SunBinyuan666/Standard_NUEDC_DevBoard/AI_Development/所有元器件的连接方式.md

# Standard NUEDC DevBoard — 所有元器件的连接方式

## 1. 文档范围与证据来源

- 识别对象：`D:\stm32IDEprojects\Standard_NUEDC_DevBoard\原理图\SCH_Standard NUEDC DevBoard.pdf`。
- 精确引脚网络对照：`D:\stm32IDEprojects\Standard_NUEDC_DevBoard\PCB工程文件\Netlist_Standard NUEDC DevBoard.tel`。
- 原理图共 3 页：第 1 页“主控”，第 2 页“电源”，第 3 页“接口”；标题为 STM32F103VET6，版本 V1.0。创建日期 2026-10-05，第 1/3 页更新于 2026-10-09，第 2 页更新于 2026-10-08。
- 生成日期：2026-10-16。语言沿用原任务，使用中文。
- 方法：先读取 PDF 文字并查看三页电路和关键放大区域，再以 TEL 交叉核对物理引脚号和全部同网端点。型号与符号功能以 PDF 为证据；精确引脚编号以 TEL 为证据，PDF 已显示的未连接脚另外列出。
- **U5 是位号，完整芯片型号已由 PDF 确认为 STM32F103VET6，属于 STM32F1。** U 开头并不一定都是 IC：U2 是开关、U3 是保险丝、U7–U12 多数是连接器、U14 是二极管。
- 文档记录“实际图中连接”，不是修订设计；不静默修改阻值、接线或封装。不替代 ERC/DRC、器件规格核对、PCB 检查和实测。

### 1.1 阅读约定

1. `U5.23` 表示 U5 的物理引脚 23；`USB1.A6` 表示 Type-C A 面的 A6 焊脚。
2. 同一网络内的端点是直接电气相连；跨电阻、电容、二极管、晶体管、开关或电感的两端不是同一网络。
3. `$1N.../$2N.../$3N...` 是 TEL 自动生成的匿名网络名，本文保留原名并添加语义解释，方便回查。
4. `NC` 表示 PDF 中标 × 或明确不连接，不代表逻辑低或电源地。开关未使用触点保留符号标签，不猜测 PDF 没显示的物理脚号。
5. 每个元器件都有引脚表；普通小网络直接列出其他端点，大型公用网络通过附录列出全部端点。表中“同网其他端点”不包括该行自身。
6. 接口的 PCB 针号不等同于图片左右方向、软件端口编号或开关机械档位。

## 2. 板级连接总览

### 2.1 电源结构

```text
CN1.1 / DC1.4
  → D1（SS54）
  → U1 VIN + C1/C2/C3 输入滤波
  → U1 PH + D2 续流 + L1（15µH）
  → 公共前级5V（PDF DC+5V 与 USB+5V 同网；TEL 统一为 USB+5V）
      ├─ USB1/USB2 的全部 VBUS
      ├─ C5/C6/C7 与 LED2/R6
      └─ U2 开关 → U3 保险丝 → VCC+5V
          ├─ 外设接口 P1/P2/P3/U11/U12、H2 的5V针
          └─ U4 AMS1117-3.3 → VCC+3.3V
              ├─ MCU 数字电源、CH340C、LED与上拉
              ├─ R7（0Ω）→ VCCA+3.3V → MCU VDDA
              │    └─ R9（1kΩ）→ U6 TL431 + C19 → MCU VREF+
              └─ D3一路阳极 → 共阴极VBAT
BT1正极 → D3另一路阳极 → 共阴极VBAT → U5.6
GND ← R8（0Ω）→ AGND
```

这里的“5V/3.3V”是网络名和设计意图，不是已测电压。特别是 USB 两口与 DC/DC 输出在开关之前已共网，U2/U3 不提供三路输入相互隔离。

### 2.2 主控最小系统

- 数字 VDD：U5.11/28/50/75/100 接 3.3V；VSS：U5.10/27/49/74/99 接 GND；C13–C17 去耦。
- VDDA=U5.22 接模拟 3.3V；VSSA=U5.19 与 VREF−=U5.20 接 AGND；VREF+=U5.21 接 TL431 参考节点。
- VBAT=U5.6 由 D3 合并数字 3.3V/电池，C18 到地。
- 高速晶体 X1：8MHz，连接 U5.12/13，C20/C21 各 20pF 到地；低速晶体 X2：32.768kHz，连接 U5.8/9，C22/C23 各 10pF 到地。
- RST=U5.14：R10 10kΩ 上拉、C24 100nF 到地、SW1 按下接地，并与 U14 相连。
- H1 通过 R11/R12 选择 BOOT1/BOOT0；PB2 就是 U5.37 的 BOOT1 同节点，未另外单独引出 PB2 网络。

### 2.3 接口及 GPIO 分配

| 模块 | 元器件 | MCU 信号 | 硬件连接要点 |
|---|---|---|---|
| USB 转 UART | USB1、U13 | PA9=MCU TX、PA10=MCU RX | CH340C RXD 接 PA9，TXD 接 PA10；默认 USART1 布局 |
| 原生 USB | USB2、R15 | PA11=D−、PA12=D+ | D+ 外部上拉实为 10kΩ |
| 自动下载 | Q1/Q2/U14/R27–R30 | RST、BOOT0 | 控制来自 CH340C DTR#/RTS# |
| SWD | H4 | PA13、PA14 | 1=3.3V，4=GND，无 NRST 针 |
| 模拟输入 | U7/U8 | PA0、PA1 | 中心端直连，外壳接 AGND |
| 模拟输出 | U9/U10 | PA4、PA5 | 图中 DAC 接口，中心端直连 |
| UART3/可选上拉 | P1/SW5/R21/R22 | PB10、PB11 | USART3 默认布局，也可按功能作 I²C2 |
| UART2/可选上拉 | P2/SW6/R25/R26 | PA2、PA3 | USART2 默认布局；若作 I²C 要另核功能/软件实现 |
| UART4/可选上拉 | P3/SW7/R23/R24 | PC10、PC11 | UART4 布局；与其他可复用外设共用引脚 |
| SPI | U11 | PA15/PB3/PB4/PB5 | 图中分别 CS/CLK/MISO/MOSI，SPI1 重映射与 JTAG 复用需配置 |
| “6路IIC”接口 | U12/R19/R20 | PB15/PB14/PB13/PB12 | 6针不是6路独立 I²C，PB15/PB14 有固定上拉 |
| 用户按键 | SW2/SW3/SW4 | PE13/PE14/PE15 | 按下到地，分别 C25/C26/C27 到地，未见外部上拉 |
| 用户 LED | LED3/LED4/LED5 | PB6/PB7/PD8 | 2kΩ 从3.3V供电，GPIO低电平点亮 |
| GPIO 扩展 | H2/H3 | 见逐针表 | 与板载接口共网，不是另一个独立GPIO副本 |

### 2.4 网络别名对照

| PDF 标注 | TEL 中保留的网络名 | 说明 |
|---|---|---|
| DC+5V、USB+5V | USB+5V | 电源合路图中同一根线上出现两个名称，TEL 合并为一个网络 |
| USBN | PA11 | USB2 D− 与 MCU PA11 同网 |
| USBP | PA12 | USB2 D+ 与 MCU PA12 同网 |
| PB2、BOOT1 | BOOT1 | U5.37 的启动复用引脚 |
| TXD2 / RXD2 | PA2 / PA3 | P2 串口方向标签，以 MCU 视角 |
| TXD3 / RXD3 | PB10 / PB11 | P1 串口方向标签，以 MCU 视角 |
| TXD4 / RXD4 | PC10 / PC11 | P3 串口方向标签，以 MCU 视角 |
| SPI_CS/CLK/MISO/MOSI | PA15/PB3/PB4/PB5 | U11 的功能标签 |
| SWDIO / SWCLK | PA13 / PA14 | H4 的功能标签 |
| SCL / SDA（U12） | PB15 / PB14 | 图中标签不等于 MCU 硬件外设已配置 |

## 3. 完整元器件索引

已交叉匹配 PDF 与 TEL 的 **108 个独立位号、124 个已连接网络、509 个已连接引脚端点**。另补 15 个有编号未连接脚，以及 SW5–SW7 的未使用符号触点。

| 类别 | 数量 | 位号范围 |
|---|---:|---|
| BT | 1 | BT1 |
| C | 28 | C1, C2, C3, C4, C5, C6, C7, C8, C9, C10, C11, C12, C13, C14, C15, C16, C17, C18, C19, C20, C21, C22, C23, C24, C25, C26, C27, C28 |
| CN | 1 | CN1 |
| DC | 1 | DC1 |
| D | 3 | D1, D2, D3 |
| H | 4 | H1, H2, H3, H4 |
| L | 1 | L1 |
| LED | 5 | LED1, LED2, LED3, LED4, LED5 |
| P | 3 | P1, P2, P3 |
| Q | 2 | Q1, Q2 |
| R | 30 | R1, R2, R3, R4, R5, R6, R7, R8, R9, R10, R11, R12, R13, R14, R15, R16, R17, R18, R19, R20, R21, R22, R23, R24, R25, R26, R27, R28, R29, R30 |
| SCREW | 4 | SCREW1, SCREW2, SCREW3, SCREW4 |
| SW | 7 | SW1, SW2, SW3, SW4, SW5, SW6, SW7 |
| U | 14 | U1, U2, U3, U4, U5, U6, U7, U8, U9, U10, U11, U12, U13, U14 |
| USB | 2 | USB1, USB2 |
| X | 2 | X1, X2 |

以下索引的型号/数值优先来自 PDF；TEL 的封装原字符串在每个器件小节保留。

| 位号 | PDF型号/数值 | PDF页 | 分类 |
|---|---|---|---|
| BT1 | CR1220-2ZX 电池座（电池额定电压未在图中标注） | 1 | 离散器件与时钟 |
| C1 | 4.7uF | 2 | 电容 |
| C2 | 4.7uF | 2 | 电容 |
| C3 | 10nF | 2 | 电容 |
| C4 | 10nF | 2 | 电容 |
| C5 | 47uF | 2 | 电容 |
| C6 | 47uF | 2 | 电容 |
| C7 | 10nF | 2 | 电容 |
| C8 | 10uF | 2 | 电容 |
| C9 | 100nF | 2 | 电容 |
| C10 | 10uF | 2 | 电容 |
| C11 | 100nF | 2 | 电容 |
| C12 | 100nF | 2 | 电容 |
| C13 | 100nF | 1 | 电容 |
| C14 | 100nF | 1 | 电容 |
| C15 | 100nF | 1 | 电容 |
| C16 | 100nF | 1 | 电容 |
| C17 | 100nF | 1 | 电容 |
| C18 | 100nF | 1 | 电容 |
| C19 | 10uF | 1 | 电容 |
| C20 | 20pF | 1 | 电容 |
| C21 | 20pF | 1 | 电容 |
| C22 | 10pF | 1 | 电容 |
| C23 | 10pF | 1 | 电容 |
| C24 | 100nF | 1 | 电容 |
| C25 | 100nF | 3 | 电容 |
| C26 | 100nF | 3 | 电容 |
| C27 | 100nF | 3 | 电容 |
| C28 | 100nF | 3 | 电容 |
| CN1 | MX103-5.0-02P-GN01-Cu-Y-A 两针接线端子 | 2 | 连接器 |
| D1 | SS54 肖特基二极管 | 2 | 离散器件与时钟 |
| D2 | SS54 肖特基二极管 | 2 | 离散器件与时钟 |
| D3 | BAT54C 共阴极双肖特基二极管 | 1 | 离散器件与时钟 |
| DC1 | DC005-2.5 DC 插座 | 2 | 离散器件与时钟 |
| H1 | HX PZ2.54-2x3P ZZ，BOOT 选择排针 | 1 | 连接器 |
| H2 | X6521WV-2x23H-C60D30，46Pin 排针 | 1 | 连接器 |
| H3 | X6521WV-2x23H-C60D30，46Pin 排针 | 1 | 连接器 |
| H4 | PZ254V-11-04P，SWD 四针排针 | 3 | 连接器 |
| L1 | 15uH | 2 | 离散器件与时钟 |
| LED1 | GL0603UG01 绿色 LED（PDF 标注；网表封装名含 RD） | 2 | 离散器件与时钟 |
| LED2 | GL0603UG01 绿色 LED（PDF 标注；网表封装名含 RD） | 2 | 离散器件与时钟 |
| LED3 | GL0603UB01 蓝色 LED | 3 | 离散器件与时钟 |
| LED4 | GL0603UB01 蓝色 LED | 3 | 离散器件与时钟 |
| LED5 | GL0603UB01 蓝色 LED | 3 | 离散器件与时钟 |
| P1 | ZX-XH2.54-4PLT，四个功能端子及两个辅助焊盘 | 3 | 连接器 |
| P2 | ZX-XH2.54-4PLT，四个功能端子及两个辅助焊盘 | 3 | 连接器 |
| P3 | ZX-XH2.54-4PLT，四个功能端子及两个辅助焊盘 | 3 | 连接器 |
| Q1 | S8050 J3Y，图示增益范围 200–350，NPN 三极管 | 3 | 离散器件与时钟 |
| Q2 | S8550，图示增益范围 120–200，PNP 三极管 | 3 | 离散器件与时钟 |
| R1 | 5.1kΩ | 2 | 电阻 |
| R2 | 5.1kΩ | 2 | 电阻 |
| R3 | 10kΩ | 2 | 电阻 |
| R4 | 3.16kΩ | 2 | 电阻 |
| R5 | 2kΩ | 2 | 电阻 |
| R6 | 5kΩ | 2 | 电阻 |
| R7 | 0Ω | 2 | 电阻 |
| R8 | 0Ω | 2 | 电阻 |
| R9 | 1kΩ | 1 | 电阻 |
| R10 | 10kΩ | 1 | 电阻 |
| R11 | 10kΩ | 1 | 电阻 |
| R12 | 10kΩ | 1 | 电阻 |
| R13 | 5.1kΩ | 3 | 电阻 |
| R14 | 5.1kΩ | 3 | 电阻 |
| R15 | 10kΩ | 3 | 电阻 |
| R16 | 2kΩ | 3 | 电阻 |
| R17 | 2kΩ | 3 | 电阻 |
| R18 | 2kΩ | 3 | 电阻 |
| R19 | 4.7kΩ | 3 | 电阻 |
| R20 | 4.7kΩ | 3 | 电阻 |
| R21 | 4.7kΩ | 3 | 电阻 |
| R22 | 4.7kΩ | 3 | 电阻 |
| R23 | 4.7kΩ | 3 | 电阻 |
| R24 | 4.7kΩ | 3 | 电阻 |
| R25 | 4.7kΩ | 3 | 电阻 |
| R26 | 4.7kΩ | 3 | 电阻 |
| R27 | 10kΩ | 3 | 电阻 |
| R28 | 1kΩ | 3 | 电阻 |
| R29 | 1kΩ | 3 | 电阻 |
| R30 | 1kΩ | 3 | 电阻 |
| SCREW1 | M3 安装孔/螺丝接地焊盘 | 3 | 按键、开关、LED与安装孔 |
| SCREW2 | M3 安装孔/螺丝接地焊盘 | 3 | 按键、开关、LED与安装孔 |
| SCREW3 | M3 安装孔/螺丝接地焊盘 | 3 | 按键、开关、LED与安装孔 |
| SCREW4 | M3 安装孔/螺丝接地焊盘 | 3 | 按键、开关、LED与安装孔 |
| SW1 | KH-6X6X5H-STM 轻触按键 | 1 | 按键、开关、LED与安装孔 |
| SW2 | KH-6X6X5H-STM 轻触按键 | 3 | 按键、开关、LED与安装孔 |
| SW3 | KH-6X6X5H-STM 轻触按键 | 3 | 按键、开关、LED与安装孔 |
| SW4 | KH-6X6X5H-STM 轻触按键 | 3 | 按键、开关、LED与安装孔 |
| SW5 | MST23D18G2 125，双刀三掷滑动开关 | 3 | 按键、开关、LED与安装孔 |
| SW6 | MST23D18G2 125，双刀三掷滑动开关 | 3 | 按键、开关、LED与安装孔 |
| SW7 | MST23D18G2 125，双刀三掷滑动开关 | 3 | 按键、开关、LED与安装孔 |
| U1 | TPS5450QDDARQ1 降压稳压器 | 2 | 电源与基准 |
| U2 | YSSP2AG00 电源开关 | 2 | 电源与基准 |
| U3 | JK-nSMD005/60V 自恢复保险丝 | 2 | 电源与基准 |
| U4 | AMS1117-3.3 线性稳压器 | 2 | 电源与基准 |
| U5 | STM32F103VET6（STM32F1 系列，LQFP-100） | 1 | 主控 |
| U6 | TL431QDBZR 可调分流基准 | 1 | 电源与基准 |
| U7 | SMA 同轴插座，图中标称 6GHz（不是板级模拟带宽） | 3 | 连接器 |
| U8 | SMA 同轴插座，图中标称 6GHz（不是板级模拟带宽） | 3 | 连接器 |
| U9 | SMA 同轴插座，图中标称 6GHz（不是板级模拟带宽） | 3 | 连接器 |
| U10 | SMA 同轴插座，图中标称 6GHz（不是板级模拟带宽） | 3 | 连接器 |
| U11 | HX 2.54-6P WT，六个功能端子及两个辅助焊盘 | 3 | 连接器 |
| U12 | HX 2.54-6P WT，六个功能端子及两个辅助焊盘 | 3 | 连接器 |
| U13 | CH340C USB 转 UART | 3 | USB桥接与下载 |
| U14 | 1N4007W 整流二极管 | 3 | USB桥接与下载 |
| USB1 | HC-TYPE-C-16P-01B，USB Type-C 插座 | 2 | 连接器 |
| USB2 | HC-TYPE-C-16P-01B，USB Type-C 插座 | 3 | 连接器 |
| X1 | 8MHz 四焊盘无源晶体（实际物料料号未标注） | 1 | 离散器件与时钟 |
| X2 | 32.768kHz 两端无源晶体（实际物料料号未标注） | 1 | 离散器件与时钟 |

## 4. 逐元器件、逐引脚连接

### 4.1 主控

#### U5 — STM32F103VET6（STM32F1 系列，LQFP-100）

- 来源：PDF 第 1 页。
- TEL 封装：`LQFP-100_L14.0-W14.0-P0.50-LS16.0-BL`。
- 作用与连接解释：主控明确为 STM32F103VET6，不再只是根据网表猜测。下表按物理引脚 1–100 列出；73 脚为 PDF 标明的 NC。大部分 GPIO 同时连扩展排针与板载外设，不能视为互相独立的端口。

| 引脚/焊盘 | 图中功能/端子含义 | 网络 | 同网其他端点或查阅方式 |
|---|---|---|---|
| 1 | PE2 | `PE2` | `H2.14` |
| 2 | PE3 | `PE3` | `H2.13` |
| 3 | PE4 | `PE4` | `H2.16` |
| 4 | PE5 | `PE5` | `H2.15` |
| 5 | PE6 | `PE6` | `H2.18` |
| 6 | VBAT | `$1N89` | `C18.1`、`D3.3` |
| 7 | PC13/TAMPER/RTC | `PC13` | `H2.17` |
| 8 | PC14/OSC32K_IN | `OSCL1` | `C22.2`、`X2.1` |
| 9 | PC15/OSC32K_OUT | `OSCL2` | `C23.2`、`X2.2` |
| 10 | VSS | `GND` | 公用网络，共 104 个端点；全部端点见 §6 `GND` |
| 11 | VDD | `VCC+3.3V` | 公用网络，共 42 个端点；全部端点见 §6 `VCC+3.3V` |
| 12 | OSC_IN | `OSCH1` | `C20.2`、`X1.3` |
| 13 | OSC_OUT | `OSCH2` | `C21.1`、`X1.1` |
| 14 | NRST | `RST` | `C24.2`、`R10.1`、`SW1.1`、`SW1.2`、`U14.2` |
| 15 | PC0 | `PC0` | `H2.20` |
| 16 | PC1 | `PC1` | `H2.19` |
| 17 | PC2 | `PC2` | `H2.22` |
| 18 | PC3 | `PC3` | `H2.21` |
| 19 | VSSA | `AGND` | 公用网络，共 22 个端点；全部端点见 §6 `AGND` |
| 20 | VREF− | `AGND` | 公用网络，共 22 个端点；全部端点见 §6 `AGND` |
| 21 | VREF+ | `$1N96` | `C19.2`、`R9.2`、`U6.1`、`U6.2` |
| 22 | VDDA | `VCCA+3.3V` | `C12.2`、`R7.1`、`R9.1` |
| 23 | PA0/WKUP | `PA0` | `H2.24`、`U7.5` |
| 24 | PA1 | `PA1` | `H2.23`、`U8.5` |
| 25 | PA2 | `PA2` | `H2.26`、`P2.2`、`SW6.3` |
| 26 | PA3 | `PA3` | `H2.25`、`P2.3`、`SW6.4` |
| 27 | VSS | `GND` | 公用网络，共 104 个端点；全部端点见 §6 `GND` |
| 28 | VDD | `VCC+3.3V` | 公用网络，共 42 个端点；全部端点见 §6 `VCC+3.3V` |
| 29 | PA4 | `PA4` | `H2.28`、`U9.5` |
| 30 | PA5 | `PA5` | `H2.27`、`U10.5` |
| 31 | PA6 | `PA6` | `H2.30` |
| 32 | PA7 | `PA7` | `H2.29` |
| 33 | PC4 | `PC4` | `H2.32` |
| 34 | PC5 | `PC5` | `H2.31` |
| 35 | PB0 | `PB0` | `H2.34` |
| 36 | PB1 | `PB1` | `H2.33` |
| 37 | PB2/BOOT1 | `BOOT1` | `H2.36`、`R11.2` |
| 38 | PE7 | `PE7` | `H2.35` |
| 39 | PE8 | `PE8` | `H2.38` |
| 40 | PE9 | `PE9` | `H2.37` |
| 41 | PE10 | `PE10` | `H2.40` |
| 42 | PE11 | `PE11` | `H2.39` |
| 43 | PE12 | `PE12` | `H2.42` |
| 44 | PE13 | `PE13` | `C25.2`、`H2.41`、`SW2.1`、`SW2.2` |
| 45 | PE14 | `PE14` | `C26.2`、`H2.44`、`SW3.1`、`SW3.2` |
| 46 | PE15 | `PE15` | `C27.2`、`H2.43`、`SW4.1`、`SW4.2` |
| 47 | PB10 | `PB10` | `H2.46`、`P1.2`、`SW5.3` |
| 48 | PB11 | `PB11` | `H2.45`、`P1.3`、`SW5.4` |
| 49 | VSS | `GND` | 公用网络，共 104 个端点；全部端点见 §6 `GND` |
| 50 | VDD | `VCC+3.3V` | 公用网络，共 42 个端点；全部端点见 §6 `VCC+3.3V` |
| 51 | PB12 | `PB12` | `H3.46`、`U12.5` |
| 52 | PB13 | `PB13` | `H3.45`、`U12.4` |
| 53 | PB14 | `PB14` | `H3.44`、`R20.1`、`U12.3` |
| 54 | PB15 | `PB15` | `H3.43`、`R19.1`、`U12.2` |
| 55 | PD8 | `PD8` | `H3.42`、`LED5.1` |
| 56 | PD9 | `PD9` | `H3.41` |
| 57 | PD10 | `PD10` | `H3.40` |
| 58 | PD11 | `PD11` | `H3.39` |
| 59 | PD12 | `PD12` | `H3.38` |
| 60 | PD13 | `PD13` | `H3.37` |
| 61 | PD14 | `PD14` | `H3.36` |
| 62 | PD15 | `PD15` | `H3.35` |
| 63 | PC6 | `PC6` | `H3.34` |
| 64 | PC7 | `PC7` | `H3.33` |
| 65 | PC8 | `PC8` | `H3.32` |
| 66 | PC9 | `PC9` | `H3.31` |
| 67 | PA8 | `PA8` | `H3.30` |
| 68 | PA9 | `PA9` | `H3.29`、`U13.3` |
| 69 | PA10 | `PA10` | `H3.28`、`U13.2` |
| 70 | PA11 | `PA11` | `H3.27`、`USB2.A7`、`USB2.B7` |
| 71 | PA12 | `PA12` | `H3.26`、`R15.1`、`USB2.A6`、`USB2.B6` |
| 72 | PA13 | `PA13` | `H3.25`、`H4.2` |
| 73 | NC | `NC` | PDF 标 × / 未连接，TEL 不导出此端点 |
| 74 | VSS | `GND` | 公用网络，共 104 个端点；全部端点见 §6 `GND` |
| 75 | VDD | `VCC+3.3V` | 公用网络，共 42 个端点；全部端点见 §6 `VCC+3.3V` |
| 76 | PA14 | `PA14` | `H3.24`、`H4.3` |
| 77 | PA15 | `PA15` | `H3.23`、`U11.2` |
| 78 | PC10 | `PC10` | `H3.22`、`P3.2`、`SW7.3` |
| 79 | PC11 | `PC11` | `H3.21`、`P3.3`、`SW7.4` |
| 80 | PC12 | `PC12` | `H3.20` |
| 81 | PD0 | `PD0` | `H3.19` |
| 82 | PD1 | `PD1` | `H3.18` |
| 83 | PD2 | `PD2` | `H3.17` |
| 84 | PD3 | `PD3` | `H3.16` |
| 85 | PD4 | `PD4` | `H3.15` |
| 86 | PD5 | `PD5` | `H3.14` |
| 87 | PD6 | `PD6` | `H3.13` |
| 88 | PD7 | `PD7` | `H3.12` |
| 89 | PB3 | `PB3` | `H3.11`、`U11.3` |
| 90 | PB4 | `PB4` | `H3.10`、`U11.4` |
| 91 | PB5 | `PB5` | `H3.9`、`U11.5` |
| 92 | PB6 | `PB6` | `H3.8`、`LED3.1` |
| 93 | PB7 | `PB7` | `H3.7`、`LED4.1` |
| 94 | BOOT0 | `BOOT0` | `R12.1`、`R29.1` |
| 95 | PB8 | `PB8` | `H3.6` |
| 96 | PB9 | `PB9` | `H3.5` |
| 97 | PE0 | `PE0` | `H3.4` |
| 98 | PE1 | `PE1` | `H3.3` |
| 99 | VSS | `GND` | 公用网络，共 104 个端点；全部端点见 §6 `GND` |
| 100 | VDD | `VCC+3.3V` | 公用网络，共 42 个端点；全部端点见 §6 `VCC+3.3V` |

### 4.2 电源与基准

#### U1 — TPS5450QDDARQ1 降压稳压器

- 来源：PDF 第 2 页。
- TEL 封装：`SOIC-8_L4.9-W3.9-P1.27-LS6.0-BL-EP`。
- 作用与连接解释：DC/DC 模块。VIN 接 D1 后的外部输入；PH 经 L1 输出公共 5V；D2 为续流二极管；C4 跨 BOOT/PH；R3/R4 构成 VSENSE 分压。ENA 在 PDF 中标 × 未外接，本说明不把未连接默认为任何电平。

| 引脚/焊盘 | 图中功能/端子含义 | 网络 | 同网其他端点或查阅方式 |
|---|---|---|---|
| 1 | BOOT | `$2N43` | `C4.2` |
| 2 | NC | `NC` | PDF 标 × / 未连接，TEL 不导出此端点 |
| 3 | NC | `NC` | PDF 标 × / 未连接，TEL 不导出此端点 |
| 4 | VSENSE | `FB` | `R3.2`、`R4.2` |
| 5 | ENA（未连接） | `NC` | PDF 标 × / 未连接，TEL 不导出此端点 |
| 6 | GND | `GND` | 公用网络，共 104 个端点；全部端点见 §6 `GND` |
| 7 | VIN | `$2N18` | `C1.1`、`C2.1`、`C3.2`、`D1.2` |
| 8 | PH | `$2N41` | `C4.1`、`D2.2`、`L1.1` |
| 9 | EPAD | `GND` | 公用网络，共 104 个端点；全部端点见 §6 `GND` |

#### U2 — YSSP2AG00 电源开关

- 来源：PDF 第 2 页。
- TEL 封装：`SW-SMD_YSSP2AG00`。
- 作用与连接解释：两组开关触点用于电源通断。图中 1/2/3 全接 GND，4/5 短接后接 U3 输入，6 接公共前级 5V。不能仅凭静态网表给出机械位置与导通状态，须核对开关触点定义。不是 USB/DC 双路电源隔离器。

| 引脚/焊盘 | 图中功能/端子含义 | 网络 | 同网其他端点或查阅方式 |
|---|---|---|---|
| 1 | 第一组接地触点 | `GND` | 公用网络，共 104 个端点；全部端点见 §6 `GND` |
| 2 | 第一组接地触点 | `GND` | 公用网络，共 104 个端点；全部端点见 §6 `GND` |
| 3 | 第一组接地触点 | `GND` | 公用网络，共 104 个端点；全部端点见 §6 `GND` |
| 4 | 第二组输出侧 | `$2N73` | `U2.5`、`U3.1` |
| 5 | 第二组公共/输出侧 | `$2N73` | `U2.4`、`U3.1` |
| 6 | 第二组公共5V输入侧 | `USB+5V` | 公用网络，共 15 个端点；全部端点见 §6 `USB+5V` |

#### U3 — JK-nSMD005/60V 自恢复保险丝

- 来源：PDF 第 2 页。
- TEL 封装：`F1206`。
- 作用与连接解释：串接在 U2 输出与 VCC+5V 之间的自恢复保险丝。具体保持/动作电流应查该完整料号规格，本说明不从型号字符串推断。

| 引脚/焊盘 | 图中功能/端子含义 | 网络 | 同网其他端点或查阅方式 |
|---|---|---|---|
| 1 | 开关侧 | `$2N73` | `U2.4`、`U2.5` |
| 2 | 板级5V侧 | `VCC+5V` | `C8.2`、`C9.2`、`H2.1`、`H2.3`、`H2.5`、`H2.7`、`P1.1`、`P2.1`、`P3.1`、`U4.3`、`U11.1`、`U12.1` |

#### U4 — AMS1117-3.3 线性稳压器

- 来源：PDF 第 2 页。
- TEL 封装：`SOT-223-3_L6.5-W3.4-P2.30-LS7.0-BR`。
- 作用与连接解释：5V → 3.3V LDO，2 脚和 4 脚均为输出；C8/C9 为输入滤波，C10/C11 为输出滤波。

| 引脚/焊盘 | 图中功能/端子含义 | 网络 | 同网其他端点或查阅方式 |
|---|---|---|---|
| 1 | GND | `GND` | 公用网络，共 104 个端点；全部端点见 §6 `GND` |
| 2 | VOUT | `VCC+3.3V` | 公用网络，共 42 个端点；全部端点见 §6 `VCC+3.3V` |
| 3 | VIN | `VCC+5V` | `C8.2`、`C9.2`、`H2.1`、`H2.3`、`H2.5`、`H2.7`、`P1.1`、`P2.1`、`P3.1`、`U3.2`、`U11.1`、`U12.1` |
| 4 | VOUT/散热焊盘 | `VCC+3.3V` | 公用网络，共 42 个端点；全部端点见 §6 `VCC+3.3V` |

#### U6 — TL431QDBZR 可调分流基准

- 来源：PDF 第 1 页。
- TEL 封装：`SOT-23-3_L2.9-W1.6-P1.90-LS2.8-BR`。
- 作用与连接解释：CAT（1）与 REF（2）短接，R9 从模拟 3.3V 向该节点供电，AN（3）接 AGND，C19 并在该节点到 AGND，U5.21 接该参考节点。属于分流基准连接，约 2.5V 的设计意图不等于已验证的实际参考电压；须核查最低工作电流、负载和电容稳定性。

| 引脚/焊盘 | 图中功能/端子含义 | 网络 | 同网其他端点或查阅方式 |
|---|---|---|---|
| 1 | CAT 阴极 | `$1N96` | `C19.2`、`R9.2`、`U5.21`、`U6.2` |
| 2 | REF 参考 | `$1N96` | `C19.2`、`R9.2`、`U5.21`、`U6.1` |
| 3 | AN 阳极 | `AGND` | 公用网络，共 22 个端点；全部端点见 §6 `AGND` |

### 4.3 USB桥接与下载

#### U13 — CH340C USB 转 UART

- 来源：PDF 第 3 页。
- TEL 封装：`SOP-16_L10.0-W3.9-P1.27-LS6.0-BL`。
- 作用与连接解释：USB1 的 USB-UART 桥。TXD（2）送入 MCU PA10，RXD（3）接 MCU PA9；V3（4）与 VCC（16）均接 3.3V。DTR#、RTS# 进入自动下载电路。

| 引脚/焊盘 | 图中功能/端子含义 | 网络 | 同网其他端点或查阅方式 |
|---|---|---|---|
| 1 | GND | `GND` | 公用网络，共 104 个端点；全部端点见 §6 `GND` |
| 2 | TXD 输出 | `PA10` | `H3.28`、`U5.69` |
| 3 | RXD 输入 | `PA9` | `H3.29`、`U5.68` |
| 4 | V3 | `VCC+3.3V` | 公用网络，共 42 个端点；全部端点见 §6 `VCC+3.3V` |
| 5 | D+ | `DP` | `USB1.A6`、`USB1.B6` |
| 6 | D− | `DN` | `USB1.A7`、`USB1.B7` |
| 7 | NC. | `NC` | PDF 标 × / 未连接，TEL 不导出此端点 |
| 8 | OUT# | `NC` | PDF 标 × / 未连接，TEL 不导出此端点 |
| 9 | CTS# | `NC` | PDF 标 × / 未连接，TEL 不导出此端点 |
| 10 | DSR# | `NC` | PDF 标 × / 未连接，TEL 不导出此端点 |
| 11 | RI# | `NC` | PDF 标 × / 未连接，TEL 不导出此端点 |
| 12 | DCD# | `NC` | PDF 标 × / 未连接，TEL 不导出此端点 |
| 13 | DTR# | `DTR` | `R28.1` |
| 14 | RTS# | `RTS` | `Q1.2`、`R30.1` |
| 15 | R232 | `NC` | PDF 标 × / 未连接，TEL 不导出此端点 |
| 16 | VCC | `VCC+3.3V` | 公用网络，共 42 个端点；全部端点见 §6 `VCC+3.3V` |

#### U14 — 1N4007W 整流二极管

- 来源：PDF 第 3 页。
- TEL 封装：`SOD-123FL_L2.7-W1.8-LS3.7-RD`。
- 作用与连接解释：阴极 1 接 Q1 集电极，阳极 2 接 RST；当 Q1 侧拉低时，RST 可经该二极管向该节点放电。这里记录图中方向，不把它当作任意方向的短路线。

| 引脚/焊盘 | 图中功能/端子含义 | 网络 | 同网其他端点或查阅方式 |
|---|---|---|---|
| 1 | K 阴极 | `$3N137` | `Q1.3`、`R27.1` |
| 2 | A 阳极 | `RST` | `C24.2`、`R10.1`、`SW1.1`、`SW1.2`、`U5.14` |

### 4.4 离散器件与时钟

#### BT1 — CR1220-2ZX 电池座（电池额定电压未在图中标注）

- 来源：PDF 第 1 页。
- TEL 封装：`BAT-SMD_CR1220-2ZX`。
- 作用与连接解释：电池正极接 D3 第二路阳极，负极接 GND；经 D3 向 VBAT 供电。

| 引脚/焊盘 | 图中功能/端子含义 | 网络 | 同网其他端点或查阅方式 |
|---|---|---|---|
| 1 | 电池正极 | `$1N87` | `D3.2` |
| 2 | 电池负极 | `GND` | 公用网络，共 104 个端点；全部端点见 §6 `GND` |

#### D1 — SS54 肖特基二极管

- 来源：PDF 第 2 页。
- TEL 封装：`SMA_L4.4-W2.8-LS5.4-R-RD`。
- 作用与连接解释：外部 DC 输入串联肖特基二极管，阳极在 CN1/DC1 侧，阴极在 U1 VIN 侧；用于输入方向保护/阻断该路径反向电流。

| 引脚/焊盘 | 图中功能/端子含义 | 网络 | 同网其他端点或查阅方式 |
|---|---|---|---|
| 1 | A 阳极 | `$2N21` | `CN1.1`、`DC1.4` |
| 2 | K 阴极 | `$2N18` | `C1.1`、`C2.1`、`C3.2`、`U1.7` |

#### D2 — SS54 肖特基二极管

- 来源：PDF 第 2 页。
- TEL 封装：`SMA_L4.4-W2.8-LS5.4-R-RD`。
- 作用与连接解释：降压续流肖特基二极管：阳极接地，阴极接 PH 开关节点。

| 引脚/焊盘 | 图中功能/端子含义 | 网络 | 同网其他端点或查阅方式 |
|---|---|---|---|
| 1 | A 阳极 | `GND` | 公用网络，共 104 个端点；全部端点见 §6 `GND` |
| 2 | K 阴极 | `$2N41` | `C4.1`、`L1.1`、`U1.8` |

#### D3 — BAT54C 共阴极双肖特基二极管

- 来源：PDF 第 1 页。
- TEL 封装：`SOT-23-3_L2.9-W1.3-P1.90-LS2.8-BR`。
- 作用与连接解释：双阳极分别接数字 3.3V 与电池正极，共阴极接 MCU VBAT；C18 对 VBAT 去耦。电池座位号 BT1，实际电池本体无独立位号。

| 引脚/焊盘 | 图中功能/端子含义 | 网络 | 同网其他端点或查阅方式 |
|---|---|---|---|
| 1 | A1 阳极：3.3V | `VCC+3.3V` | 公用网络，共 42 个端点；全部端点见 §6 `VCC+3.3V` |
| 2 | A2 阳极：电池 | `$1N87` | `BT1.1` |
| 3 | K 共阴极 | `$1N89` | `C18.1`、`U5.6` |

#### DC1 — DC005-2.5 DC 插座

- 来源：PDF 第 2 页。
- TEL 封装：`DC-IN-TH_DC005-2.5MM`。
- 作用与连接解释：4 脚为图示正电源接点，2/3 脚均接 GND，与 CN1 同网。插座机械接点含义应以该型号封装图核对，不套用其他 DC 插座的通用编号。

| 引脚/焊盘 | 图中功能/端子含义 | 网络 | 同网其他端点或查阅方式 |
|---|---|---|---|
| 2 | 图中地接点 | `GND` | 公用网络，共 104 个端点；全部端点见 §6 `GND` |
| 3 | 图中地接点 | `GND` | 公用网络，共 104 个端点；全部端点见 §6 `GND` |
| 4 | 图中电源正接点 | `$2N21` | `CN1.1`、`D1.1` |

#### L1 — 15uH

- 来源：PDF 第 2 页。
- TEL 封装：`IND-SMD_L7.3-W6.8`。
- 作用与连接解释：15µH 降压储能电感，1 接 PH，2 接公共 5V 输出。该连接不是模拟电源隔离用磁珠。

| 引脚/焊盘 | 图中功能/端子含义 | 网络 | 同网其他端点或查阅方式 |
|---|---|---|---|
| 1 | PH 侧 | `$2N41` | `C4.1`、`D2.2`、`U1.8` |
| 2 | 输出侧 | `USB+5V` | 公用网络，共 15 个端点；全部端点见 §6 `USB+5V` |

#### LED1 — GL0603UG01 绿色 LED（PDF 标注；网表封装名含 RD）

- 来源：PDF 第 2 页。
- TEL 封装：`LED0603-RD`。
- 作用与连接解释：电源指示：阳极 2 接 VCC+3.3V，阴极 1 经 R5 接地。

| 引脚/焊盘 | 图中功能/端子含义 | 网络 | 同网其他端点或查阅方式 |
|---|---|---|---|
| 1 | K 阴极 | `$2N72` | `R5.2` |
| 2 | A 阳极 | `VCC+3.3V` | 公用网络，共 42 个端点；全部端点见 §6 `VCC+3.3V` |

#### LED2 — GL0603UG01 绿色 LED（PDF 标注；网表封装名含 RD）

- 来源：PDF 第 2 页。
- TEL 封装：`LED0603-RD`。
- 作用与连接解释：电源指示：阳极 2 接 USB+5V（PDF DC+5V），阴极 1 经 R6 接地。

| 引脚/焊盘 | 图中功能/端子含义 | 网络 | 同网其他端点或查阅方式 |
|---|---|---|---|
| 1 | K 阴极 | `$2N71` | `R6.2` |
| 2 | A 阳极 | `USB+5V` | 公用网络，共 15 个端点；全部端点见 §6 `USB+5V` |

#### LED3 — GL0603UB01 蓝色 LED

- 来源：PDF 第 3 页。
- TEL 封装：`LED0603-RD_BLUE`。
- 作用与连接解释：用户指示：3.3V 经 R16（2kΩ）接阳极 2，阴极 1 接 PB6。GPIO 输出低电平时导通点亮，输出高电平时熄灭；该 GPIO 同时引出 H3。

| 引脚/焊盘 | 图中功能/端子含义 | 网络 | 同网其他端点或查阅方式 |
|---|---|---|---|
| 1 | K 阴极 | `PB6` | `H3.8`、`U5.92` |
| 2 | A 阳极 | `$3N152` | `R16.2` |

#### LED4 — GL0603UB01 蓝色 LED

- 来源：PDF 第 3 页。
- TEL 封装：`LED0603-RD_BLUE`。
- 作用与连接解释：用户指示：3.3V 经 R17（2kΩ）接阳极 2，阴极 1 接 PB7。GPIO 输出低电平时导通点亮，输出高电平时熄灭；该 GPIO 同时引出 H3。

| 引脚/焊盘 | 图中功能/端子含义 | 网络 | 同网其他端点或查阅方式 |
|---|---|---|---|
| 1 | K 阴极 | `PB7` | `H3.7`、`U5.93` |
| 2 | A 阳极 | `$3N154` | `R17.2` |

#### LED5 — GL0603UB01 蓝色 LED

- 来源：PDF 第 3 页。
- TEL 封装：`LED0603-RD_BLUE`。
- 作用与连接解释：用户指示：3.3V 经 R18（2kΩ）接阳极 2，阴极 1 接 PD8。GPIO 输出低电平时导通点亮，输出高电平时熄灭；该 GPIO 同时引出 H3。

| 引脚/焊盘 | 图中功能/端子含义 | 网络 | 同网其他端点或查阅方式 |
|---|---|---|---|
| 1 | K 阴极 | `PD8` | `H3.42`、`U5.55` |
| 2 | A 阳极 | `$3N156` | `R18.2` |

#### Q1 — S8050 J3Y，图示增益范围 200–350，NPN 三极管

- 来源：PDF 第 3 页。
- TEL 封装：`SOT-23-3_L3.0-W1.7-P0.95-LS2.9-BR`。
- 作用与连接解释：NPN：基极经 R28 接 DTR，发射极接 RTS，集电极由 R27 上拉并接 U14 阴极。Q1 发射极不是固定接地。

| 引脚/焊盘 | 图中功能/端子含义 | 网络 | 同网其他端点或查阅方式 |
|---|---|---|---|
| 1 | B 基极 | `$3N140` | `R28.2` |
| 2 | E 发射极 | `RTS` | `R30.1`、`U13.14` |
| 3 | C 集电极 | `$3N137` | `R27.1`、`U14.1` |

#### Q2 — S8550，图示增益范围 120–200，PNP 三极管

- 来源：PDF 第 3 页。
- TEL 封装：`SOT-23-3_L2.9-W1.6-P1.90-LS2.8-BR`。
- 作用与连接解释：PNP：发射极接 3.3V，基极经 R30 接 RTS，集电极经 R29 接 BOOT0。DTR/RTS 电平及时序决定自动下载动作，不能只凭名字认定逻辑。

| 引脚/焊盘 | 图中功能/端子含义 | 网络 | 同网其他端点或查阅方式 |
|---|---|---|---|
| 1 | B 基极 | `$3N144` | `R30.2` |
| 2 | E 发射极 | `VCC+3.3V` | 公用网络，共 42 个端点；全部端点见 §6 `VCC+3.3V` |
| 3 | C 集电极 | `$3N142` | `R29.2` |

#### X1 — 8MHz 四焊盘无源晶体（实际物料料号未标注）

- 来源：PDF 第 1 页。
- TEL 封装：`CRYSTAL-SMD_4P-L3.2-W2.5-BL_SIT8008BI`。
- TEL 导出数值：`8MHz`。
- 作用与连接解释：3 脚接 OSC_IN，1 脚接 OSC_OUT，2/4 接地；C20/C21 各 20pF 到地。PDF 画的是无源晶体；TEL 封装名含 SIT8008BI，不据此将它识别成有源时钟。

| 引脚/焊盘 | 图中功能/端子含义 | 网络 | 同网其他端点或查阅方式 |
|---|---|---|---|
| 1 | 晶体 OSC_OUT 端 | `OSCH2` | `C21.1`、`U5.13` |
| 2 | 地焊盘 | `GND` | 公用网络，共 104 个端点；全部端点见 §6 `GND` |
| 3 | 晶体 OSC_IN 端 | `OSCH1` | `C20.2`、`U5.12` |
| 4 | 地焊盘 | `GND` | 公用网络，共 104 个端点；全部端点见 §6 `GND` |

#### X2 — 32.768kHz 两端无源晶体（实际物料料号未标注）

- 来源：PDF 第 1 页。
- TEL 封装：`OSC-SMD_L3.2-W1.5`。
- TEL 导出数值：`32.768kHz`。
- 作用与连接解释：两端跨接 PC14/PC15，C22/C23 各 10pF 到地，构成 RTC 低速晶振电路。

| 引脚/焊盘 | 图中功能/端子含义 | 网络 | 同网其他端点或查阅方式 |
|---|---|---|---|
| 1 | 晶体 OSC32K_IN 端 | `OSCL1` | `C22.2`、`U5.8` |
| 2 | 晶体 OSC32K_OUT 端 | `OSCL2` | `C23.2`、`U5.9` |

### 4.5 连接器

#### CN1 — MX103-5.0-02P-GN01-Cu-Y-A 两针接线端子

- 来源：PDF 第 2 页。
- TEL 封装：`CONN-TH_2P-P5.00_MX103-5.0-02P`。
- 作用与连接解释：外部直流输入端子，与 DC 插座并联；图中没有给出允许输入电压范围。

| 引脚/焊盘 | 图中功能/端子含义 | 网络 | 同网其他端点或查阅方式 |
|---|---|---|---|
| 1 | 外部电源正端 | `$2N21` | `D1.1`、`DC1.4` |
| 2 | 外部电源地 | `GND` | 公用网络，共 104 个端点；全部端点见 §6 `GND` |

#### H1 — HX PZ2.54-2x3P ZZ，BOOT 选择排针

- 来源：PDF 第 1 页。
- TEL 封装：`HDR-TH_6P-P2.54-V-M-R2-C3-S2.54-2`。
- 作用与连接解释：BOOT 跳帽选择：1–3 可经 R11 把 BOOT1 拉向 3.3V，3–5 可拉向 GND；2–4/4–6 对 BOOT0 同理，经 R12。未装跳帽时不能把电阻称为固定上拉或下拉。

| 引脚/焊盘 | 图中功能/端子含义 | 网络 | 同网其他端点或查阅方式 |
|---|---|---|---|
| 1 | AMS1117 输出的数字 3.3V | `VCC+3.3V` | 公用网络，共 42 个端点；全部端点见 §6 `VCC+3.3V` |
| 2 | AMS1117 输出的数字 3.3V | `VCC+3.3V` | 公用网络，共 42 个端点；全部端点见 §6 `VCC+3.3V` |
| 3 | BOOT1 跳帽中间端（经 R11 到 BOOT1） | `$1N120` | `R11.1` |
| 4 | BOOT0 跳帽中间端（经 R12 到 BOOT0） | `$1N121` | `R12.2` |
| 5 | 数字/电源地 | `GND` | 公用网络，共 104 个端点；全部端点见 §6 `GND` |
| 6 | 数字/电源地 | `GND` | 公用网络，共 104 个端点；全部端点见 §6 `GND` |

#### H2 — X6521WV-2x23H-C60D30，46Pin 排针

- 来源：PDF 第 1 页。
- TEL 封装：`HDR-TH_46P-2.54-V-M-R2-C23-S2.54`。
- 作用与连接解释：46Pin 扩展，包含 5V/3.3V/GND 及 GPIO。引脚编号以网表为准，不由图片左右布局推断。

| 引脚/焊盘 | 图中功能/端子含义 | 网络 | 同网其他端点或查阅方式 |
|---|---|---|---|
| 1 | 经 U2/U3 后的板级 5V | `VCC+5V` | `C8.2`、`C9.2`、`H2.3`、`H2.5`、`H2.7`、`P1.1`、`P2.1`、`P3.1`、`U3.2`、`U4.3`、`U11.1`、`U12.1` |
| 2 | AMS1117 输出的数字 3.3V | `VCC+3.3V` | 公用网络，共 42 个端点；全部端点见 §6 `VCC+3.3V` |
| 3 | 经 U2/U3 后的板级 5V | `VCC+5V` | `C8.2`、`C9.2`、`H2.1`、`H2.5`、`H2.7`、`P1.1`、`P2.1`、`P3.1`、`U3.2`、`U4.3`、`U11.1`、`U12.1` |
| 4 | AMS1117 输出的数字 3.3V | `VCC+3.3V` | 公用网络，共 42 个端点；全部端点见 §6 `VCC+3.3V` |
| 5 | 经 U2/U3 后的板级 5V | `VCC+5V` | `C8.2`、`C9.2`、`H2.1`、`H2.3`、`H2.7`、`P1.1`、`P2.1`、`P3.1`、`U3.2`、`U4.3`、`U11.1`、`U12.1` |
| 6 | AMS1117 输出的数字 3.3V | `VCC+3.3V` | 公用网络，共 42 个端点；全部端点见 §6 `VCC+3.3V` |
| 7 | 经 U2/U3 后的板级 5V | `VCC+5V` | `C8.2`、`C9.2`、`H2.1`、`H2.3`、`H2.5`、`P1.1`、`P2.1`、`P3.1`、`U3.2`、`U4.3`、`U11.1`、`U12.1` |
| 8 | AMS1117 输出的数字 3.3V | `VCC+3.3V` | 公用网络，共 42 个端点；全部端点见 §6 `VCC+3.3V` |
| 9 | 数字/电源地 | `GND` | 公用网络，共 104 个端点；全部端点见 §6 `GND` |
| 10 | 数字/电源地 | `GND` | 公用网络，共 104 个端点；全部端点见 §6 `GND` |
| 11 | 数字/电源地 | `GND` | 公用网络，共 104 个端点；全部端点见 §6 `GND` |
| 12 | 数字/电源地 | `GND` | 公用网络，共 104 个端点；全部端点见 §6 `GND` |
| 13 | PE3 | `PE3` | `U5.2` |
| 14 | PE2 | `PE2` | `U5.1` |
| 15 | PE5 | `PE5` | `U5.4` |
| 16 | PE4 | `PE4` | `U5.3` |
| 17 | PC13 | `PC13` | `U5.7` |
| 18 | PE6 | `PE6` | `U5.5` |
| 19 | PC1 | `PC1` | `U5.16` |
| 20 | PC0 | `PC0` | `U5.15` |
| 21 | PC3 | `PC3` | `U5.18` |
| 22 | PC2 | `PC2` | `U5.17` |
| 23 | PA1 | `PA1` | `U5.24`、`U8.5` |
| 24 | PA0 | `PA0` | `U5.23`、`U7.5` |
| 25 | PA3 | `PA3` | `P2.3`、`SW6.4`、`U5.26` |
| 26 | PA2 | `PA2` | `P2.2`、`SW6.3`、`U5.25` |
| 27 | PA5 | `PA5` | `U5.30`、`U10.5` |
| 28 | PA4 | `PA4` | `U5.29`、`U9.5` |
| 29 | PA7 | `PA7` | `U5.32` |
| 30 | PA6 | `PA6` | `U5.31` |
| 31 | PC5 | `PC5` | `U5.34` |
| 32 | PC4 | `PC4` | `U5.33` |
| 33 | PB1 | `PB1` | `U5.36` |
| 34 | PB0 | `PB0` | `U5.35` |
| 35 | PE7 | `PE7` | `U5.38` |
| 36 | MCU PB2/BOOT1；原理图中的 PB2 与 BOOT1 为同节点 | `BOOT1` | `R11.2`、`U5.37` |
| 37 | PE9 | `PE9` | `U5.40` |
| 38 | PE8 | `PE8` | `U5.39` |
| 39 | PE11 | `PE11` | `U5.42` |
| 40 | PE10 | `PE10` | `U5.41` |
| 41 | PE13 | `PE13` | `C25.2`、`SW2.1`、`SW2.2`、`U5.44` |
| 42 | PE12 | `PE12` | `U5.43` |
| 43 | PE15 | `PE15` | `C27.2`、`SW4.1`、`SW4.2`、`U5.46` |
| 44 | PE14 | `PE14` | `C26.2`、`SW3.1`、`SW3.2`、`U5.45` |
| 45 | PB11 | `PB11` | `P1.3`、`SW5.4`、`U5.48` |
| 46 | PB10 | `PB10` | `P1.2`、`SW5.3`、`U5.47` |

#### H3 — X6521WV-2x23H-C60D30，46Pin 排针

- 来源：PDF 第 1 页。
- TEL 封装：`HDR-TH_46P-2.54-V-M-R2-C23-S2.54`。
- 作用与连接解释：46Pin 扩展，1/2 为 GND，其余为 GPIO；此排针没有单独 5V/3.3V 引脚。

| 引脚/焊盘 | 图中功能/端子含义 | 网络 | 同网其他端点或查阅方式 |
|---|---|---|---|
| 1 | 数字/电源地 | `GND` | 公用网络，共 104 个端点；全部端点见 §6 `GND` |
| 2 | 数字/电源地 | `GND` | 公用网络，共 104 个端点；全部端点见 §6 `GND` |
| 3 | PE1 | `PE1` | `U5.98` |
| 4 | PE0 | `PE0` | `U5.97` |
| 5 | PB9 | `PB9` | `U5.96` |
| 6 | PB8 | `PB8` | `U5.95` |
| 7 | PB7 | `PB7` | `LED4.1`、`U5.93` |
| 8 | PB6 | `PB6` | `LED3.1`、`U5.92` |
| 9 | PB5 | `PB5` | `U5.91`、`U11.5` |
| 10 | PB4 | `PB4` | `U5.90`、`U11.4` |
| 11 | PB3 | `PB3` | `U5.89`、`U11.3` |
| 12 | PD7 | `PD7` | `U5.88` |
| 13 | PD6 | `PD6` | `U5.87` |
| 14 | PD5 | `PD5` | `U5.86` |
| 15 | PD4 | `PD4` | `U5.85` |
| 16 | PD3 | `PD3` | `U5.84` |
| 17 | PD2 | `PD2` | `U5.83` |
| 18 | PD1 | `PD1` | `U5.82` |
| 19 | PD0 | `PD0` | `U5.81` |
| 20 | PC12 | `PC12` | `U5.80` |
| 21 | PC11 | `PC11` | `P3.3`、`SW7.4`、`U5.79` |
| 22 | PC10 | `PC10` | `P3.2`、`SW7.3`、`U5.78` |
| 23 | PA15 | `PA15` | `U5.77`、`U11.2` |
| 24 | PA14 | `PA14` | `H4.3`、`U5.76` |
| 25 | PA13 | `PA13` | `H4.2`、`U5.72` |
| 26 | PA12 | `PA12` | `R15.1`、`U5.71`、`USB2.A6`、`USB2.B6` |
| 27 | PA11 | `PA11` | `U5.70`、`USB2.A7`、`USB2.B7` |
| 28 | PA10 | `PA10` | `U5.69`、`U13.2` |
| 29 | PA9 | `PA9` | `U5.68`、`U13.3` |
| 30 | PA8 | `PA8` | `U5.67` |
| 31 | PC9 | `PC9` | `U5.66` |
| 32 | PC8 | `PC8` | `U5.65` |
| 33 | PC7 | `PC7` | `U5.64` |
| 34 | PC6 | `PC6` | `U5.63` |
| 35 | PD15 | `PD15` | `U5.62` |
| 36 | PD14 | `PD14` | `U5.61` |
| 37 | PD13 | `PD13` | `U5.60` |
| 38 | PD12 | `PD12` | `U5.59` |
| 39 | PD11 | `PD11` | `U5.58` |
| 40 | PD10 | `PD10` | `U5.57` |
| 41 | PD9 | `PD9` | `U5.56` |
| 42 | PD8 | `PD8` | `LED5.1`、`U5.55` |
| 43 | PB15 | `PB15` | `R19.1`、`U5.54`、`U12.2` |
| 44 | PB14 | `PB14` | `R20.1`、`U5.53`、`U12.3` |
| 45 | PB13 | `PB13` | `U5.52`、`U12.4` |
| 46 | PB12 | `PB12` | `U5.51`、`U12.5` |

#### H4 — PZ254V-11-04P，SWD 四针排针

- 来源：PDF 第 3 页。
- TEL 封装：`HDR-TH_4P-P2.54-V-M`。
- 作用与连接解释：SWD：1=3.3V，2=PA13/SWDIO，3=PA14/SWCLK，4=GND。未引出 NRST。

| 引脚/焊盘 | 图中功能/端子含义 | 网络 | 同网其他端点或查阅方式 |
|---|---|---|---|
| 1 | 3.3V | `VCC+3.3V` | 公用网络，共 42 个端点；全部端点见 §6 `VCC+3.3V` |
| 2 | SWDIO | `PA13` | `H3.25`、`U5.72` |
| 3 | SWCLK | `PA14` | `H3.24`、`U5.76` |
| 4 | GND | `GND` | 公用网络，共 104 个端点；全部端点见 §6 `GND` |

#### P1 — ZX-XH2.54-4PLT，四个功能端子及两个辅助焊盘

- 来源：PDF 第 3 页。
- TEL 封装：`CONN-SMD_4P-P2.54_C9900012758`。
- 作用与连接解释：四功能针：1=5V，2=PB10，3=PB11，4=GND；5/6 为图中额外接地辅助焊盘，不是额外两路信号。2/3 同时接 H2/H3 和 SW5，可用于 UART 或根据 GPIO 能力实现 I²C；无电平转换。

| 引脚/焊盘 | 图中功能/端子含义 | 网络 | 同网其他端点或查阅方式 |
|---|---|---|---|
| 1 | 5V | `VCC+5V` | `C8.2`、`C9.2`、`H2.1`、`H2.3`、`H2.5`、`H2.7`、`P2.1`、`P3.1`、`U3.2`、`U4.3`、`U11.1`、`U12.1` |
| 2 | TX/可复用信号 | `PB10` | `H2.46`、`SW5.3`、`U5.47` |
| 3 | RX/可复用信号 | `PB11` | `H2.45`、`SW5.4`、`U5.48` |
| 4 | GND 功能端 | `GND` | 公用网络，共 104 个端点；全部端点见 §6 `GND` |
| 5 | 辅助接地焊盘 | `GND` | 公用网络，共 104 个端点；全部端点见 §6 `GND` |
| 6 | 辅助接地焊盘 | `GND` | 公用网络，共 104 个端点；全部端点见 §6 `GND` |

#### P2 — ZX-XH2.54-4PLT，四个功能端子及两个辅助焊盘

- 来源：PDF 第 3 页。
- TEL 封装：`CONN-SMD_4P-P2.54_C9900012758`。
- 作用与连接解释：四功能针：1=5V，2=PA2，3=PA3，4=GND；5/6 为图中额外接地辅助焊盘，不是额外两路信号。2/3 同时接 H2/H3 和 SW6，可用于 UART 或根据 GPIO 能力实现 I²C；无电平转换。

| 引脚/焊盘 | 图中功能/端子含义 | 网络 | 同网其他端点或查阅方式 |
|---|---|---|---|
| 1 | 5V | `VCC+5V` | `C8.2`、`C9.2`、`H2.1`、`H2.3`、`H2.5`、`H2.7`、`P1.1`、`P3.1`、`U3.2`、`U4.3`、`U11.1`、`U12.1` |
| 2 | TX/可复用信号 | `PA2` | `H2.26`、`SW6.3`、`U5.25` |
| 3 | RX/可复用信号 | `PA3` | `H2.25`、`SW6.4`、`U5.26` |
| 4 | GND 功能端 | `GND` | 公用网络，共 104 个端点；全部端点见 §6 `GND` |
| 5 | 辅助接地焊盘 | `GND` | 公用网络，共 104 个端点；全部端点见 §6 `GND` |
| 6 | 辅助接地焊盘 | `GND` | 公用网络，共 104 个端点；全部端点见 §6 `GND` |

#### P3 — ZX-XH2.54-4PLT，四个功能端子及两个辅助焊盘

- 来源：PDF 第 3 页。
- TEL 封装：`CONN-SMD_4P-P2.54_C9900012758`。
- 作用与连接解释：四功能针：1=5V，2=PC10，3=PC11，4=GND；5/6 为图中额外接地辅助焊盘，不是额外两路信号。2/3 同时接 H2/H3 和 SW7，可用于 UART 或根据 GPIO 能力实现 I²C；无电平转换。

| 引脚/焊盘 | 图中功能/端子含义 | 网络 | 同网其他端点或查阅方式 |
|---|---|---|---|
| 1 | 5V | `VCC+5V` | `C8.2`、`C9.2`、`H2.1`、`H2.3`、`H2.5`、`H2.7`、`P1.1`、`P2.1`、`U3.2`、`U4.3`、`U11.1`、`U12.1` |
| 2 | TX/可复用信号 | `PC10` | `H3.22`、`SW7.3`、`U5.78` |
| 3 | RX/可复用信号 | `PC11` | `H3.21`、`SW7.4`、`U5.79` |
| 4 | GND 功能端 | `GND` | 公用网络，共 104 个端点；全部端点见 §6 `GND` |
| 5 | 辅助接地焊盘 | `GND` | 公用网络，共 104 个端点；全部端点见 §6 `GND` |
| 6 | 辅助接地焊盘 | `GND` | 公用网络，共 104 个端点；全部端点见 §6 `GND` |

#### U7 — SMA 同轴插座，图中标称 6GHz（不是板级模拟带宽）

- 来源：PDF 第 3 页。
- TEL 封装：`SMA-TH_HL-SMA-KHD2`。
- TEL 导出数值：`6GHz`。
- 作用与连接解释：SMA 中心端 5 接 PA0，四个外壳焊脚 1–4 接 AGND。U7/U8 图中作为 ADC 接口，U9/U10 图中作为 DAC 接口；网表未显示串联限流、缓冲或钳位器件。

| 引脚/焊盘 | 图中功能/端子含义 | 网络 | 同网其他端点或查阅方式 |
|---|---|---|---|
| 1 | 外壳/模拟地 | `AGND` | 公用网络，共 22 个端点；全部端点见 §6 `AGND` |
| 2 | 外壳/模拟地 | `AGND` | 公用网络，共 22 个端点；全部端点见 §6 `AGND` |
| 3 | 外壳/模拟地 | `AGND` | 公用网络，共 22 个端点；全部端点见 §6 `AGND` |
| 4 | 外壳/模拟地 | `AGND` | 公用网络，共 22 个端点；全部端点见 §6 `AGND` |
| 5 | 中心信号端 | `PA0` | `H2.24`、`U5.23` |

#### U8 — SMA 同轴插座，图中标称 6GHz（不是板级模拟带宽）

- 来源：PDF 第 3 页。
- TEL 封装：`SMA-TH_HL-SMA-KHD2`。
- TEL 导出数值：`6GHz`。
- 作用与连接解释：SMA 中心端 5 接 PA1，四个外壳焊脚 1–4 接 AGND。U7/U8 图中作为 ADC 接口，U9/U10 图中作为 DAC 接口；网表未显示串联限流、缓冲或钳位器件。

| 引脚/焊盘 | 图中功能/端子含义 | 网络 | 同网其他端点或查阅方式 |
|---|---|---|---|
| 1 | 外壳/模拟地 | `AGND` | 公用网络，共 22 个端点；全部端点见 §6 `AGND` |
| 2 | 外壳/模拟地 | `AGND` | 公用网络，共 22 个端点；全部端点见 §6 `AGND` |
| 3 | 外壳/模拟地 | `AGND` | 公用网络，共 22 个端点；全部端点见 §6 `AGND` |
| 4 | 外壳/模拟地 | `AGND` | 公用网络，共 22 个端点；全部端点见 §6 `AGND` |
| 5 | 中心信号端 | `PA1` | `H2.23`、`U5.24` |

#### U9 — SMA 同轴插座，图中标称 6GHz（不是板级模拟带宽）

- 来源：PDF 第 3 页。
- TEL 封装：`SMA-TH_HL-SMA-KHD2`。
- TEL 导出数值：`6GHz`。
- 作用与连接解释：SMA 中心端 5 接 PA4，四个外壳焊脚 1–4 接 AGND。U7/U8 图中作为 ADC 接口，U9/U10 图中作为 DAC 接口；网表未显示串联限流、缓冲或钳位器件。

| 引脚/焊盘 | 图中功能/端子含义 | 网络 | 同网其他端点或查阅方式 |
|---|---|---|---|
| 1 | 外壳/模拟地 | `AGND` | 公用网络，共 22 个端点；全部端点见 §6 `AGND` |
| 2 | 外壳/模拟地 | `AGND` | 公用网络，共 22 个端点；全部端点见 §6 `AGND` |
| 3 | 外壳/模拟地 | `AGND` | 公用网络，共 22 个端点；全部端点见 §6 `AGND` |
| 4 | 外壳/模拟地 | `AGND` | 公用网络，共 22 个端点；全部端点见 §6 `AGND` |
| 5 | 中心信号端 | `PA4` | `H2.28`、`U5.29` |

#### U10 — SMA 同轴插座，图中标称 6GHz（不是板级模拟带宽）

- 来源：PDF 第 3 页。
- TEL 封装：`SMA-TH_HL-SMA-KHD2`。
- TEL 导出数值：`6GHz`。
- 作用与连接解释：SMA 中心端 5 接 PA5，四个外壳焊脚 1–4 接 AGND。U7/U8 图中作为 ADC 接口，U9/U10 图中作为 DAC 接口；网表未显示串联限流、缓冲或钳位器件。

| 引脚/焊盘 | 图中功能/端子含义 | 网络 | 同网其他端点或查阅方式 |
|---|---|---|---|
| 1 | 外壳/模拟地 | `AGND` | 公用网络，共 22 个端点；全部端点见 §6 `AGND` |
| 2 | 外壳/模拟地 | `AGND` | 公用网络，共 22 个端点；全部端点见 §6 `AGND` |
| 3 | 外壳/模拟地 | `AGND` | 公用网络，共 22 个端点；全部端点见 §6 `AGND` |
| 4 | 外壳/模拟地 | `AGND` | 公用网络，共 22 个端点；全部端点见 §6 `AGND` |
| 5 | 中心信号端 | `PA5` | `H2.27`、`U5.30` |

#### U11 — HX 2.54-6P WT，六个功能端子及两个辅助焊盘

- 来源：PDF 第 3 页。
- TEL 封装：`CONN-SMD_6P-P2.50_HANXIA_HX-2.54-6P-WT`。
- 作用与连接解释：SPI 扩展：PA15=CS、PB3=CLK、PB4=MISO、PB5=MOSI，属于 SPI1 重映射布局；使用前须正确设置外设/重映射并释放相关 JTAG 引脚。接口供电为 5V，信号直接接 MCU，无电平转换。

| 引脚/焊盘 | 图中功能/端子含义 | 网络 | 同网其他端点或查阅方式 |
|---|---|---|---|
| 1 | 5V | `VCC+5V` | `C8.2`、`C9.2`、`H2.1`、`H2.3`、`H2.5`、`H2.7`、`P1.1`、`P2.1`、`P3.1`、`U3.2`、`U4.3`、`U12.1` |
| 2 | SPI_CS | `PA15` | `H3.23`、`U5.77` |
| 3 | SPI_CLK | `PB3` | `H3.11`、`U5.89` |
| 4 | SPI_MISO | `PB4` | `H3.10`、`U5.90` |
| 5 | SPI_MOSI | `PB5` | `H3.9`、`U5.91` |
| 6 | GND 功能端 | `GND` | 公用网络，共 104 个端点；全部端点见 §6 `GND` |
| 7 | 辅助接地焊盘 | `GND` | 公用网络，共 104 个端点；全部端点见 §6 `GND` |
| 8 | 辅助接地焊盘 | `GND` | 公用网络，共 104 个端点；全部端点见 §6 `GND` |

#### U12 — HX 2.54-6P WT，六个功能端子及两个辅助焊盘

- 来源：PDF 第 3 页。
- TEL 封装：`CONN-SMD_6P-P2.50_HANXIA_HX-2.54-6P-WT`。
- 作用与连接解释：图页标题为“6路IIC”，实际是六端子接口：1=5V、2=PB15（SCL）、3=PB14（SDA）、4=PB13、5=PB12、6=GND。只有 PB15/PB14 加 4.7kΩ 上拉，不能把标题理解为六路独立硬件 I²C；PB15/PB14 若作 I²C 通常需软件模拟或另查功能配置。

| 引脚/焊盘 | 图中功能/端子含义 | 网络 | 同网其他端点或查阅方式 |
|---|---|---|---|
| 1 | 5V | `VCC+5V` | `C8.2`、`C9.2`、`H2.1`、`H2.3`、`H2.5`、`H2.7`、`P1.1`、`P2.1`、`P3.1`、`U3.2`、`U4.3`、`U11.1` |
| 2 | SCL / PB15 | `PB15` | `H3.43`、`R19.1`、`U5.54` |
| 3 | SDA / PB14 | `PB14` | `H3.44`、`R20.1`、`U5.53` |
| 4 | PB13 扩展 | `PB13` | `H3.45`、`U5.52` |
| 5 | PB12 扩展 | `PB12` | `H3.46`、`U5.51` |
| 6 | GND 功能端 | `GND` | 公用网络，共 104 个端点；全部端点见 §6 `GND` |
| 7 | 辅助接地焊盘 | `GND` | 公用网络，共 104 个端点；全部端点见 §6 `GND` |
| 8 | 辅助接地焊盘 | `GND` | 公用网络，共 104 个端点；全部端点见 §6 `GND` |

#### USB1 — HC-TYPE-C-16P-01B，USB Type-C 插座

- 来源：PDF 第 2 页。
- TEL 封装：`USB-C-SMD_KH-TYPE-C-16P`。
- 作用与连接解释：USB-UART 口：D+ 接 CH340C.5，D− 接 CH340C.6；A/B 两面的同类信号短接以适应正反插。VBUS 接公共前级 5V，CC 各经 5.1kΩ 下拉。SBU1/SBU2 在 PDF 标 ×。

| 引脚/焊盘 | 图中功能/端子含义 | 网络 | 同网其他端点或查阅方式 |
|---|---|---|---|
| 1 | EP 外壳焊盘 | `GND` | 公用网络，共 104 个端点；全部端点见 §6 `GND` |
| 2 | EP 外壳焊盘 | `GND` | 公用网络，共 104 个端点；全部端点见 §6 `GND` |
| 3 | EP 外壳焊盘 | `GND` | 公用网络，共 104 个端点；全部端点见 §6 `GND` |
| 4 | EP 外壳焊盘 | `GND` | 公用网络，共 104 个端点；全部端点见 §6 `GND` |
| A1 | GND | `GND` | 公用网络，共 104 个端点；全部端点见 §6 `GND` |
| A4 | VBUS | `USB+5V` | 公用网络，共 15 个端点；全部端点见 §6 `USB+5V` |
| A5 | CC1 | `CC21` | `R1.1` |
| A6 | DP1 / D+ | `DP` | `U13.5`、`USB1.B6` |
| A7 | DN1 / D− | `DN` | `U13.6`、`USB1.B7` |
| A8 | SBU1 | `NC` | PDF 标 × / 未连接，TEL 不导出此端点 |
| A9 | VBUS | `USB+5V` | 公用网络，共 15 个端点；全部端点见 §6 `USB+5V` |
| A12 | GND | `GND` | 公用网络，共 104 个端点；全部端点见 §6 `GND` |
| B1 | GND | `GND` | 公用网络，共 104 个端点；全部端点见 §6 `GND` |
| B4 | VBUS | `USB+5V` | 公用网络，共 15 个端点；全部端点见 §6 `USB+5V` |
| B5 | CC2 | `CC22` | `R2.1` |
| B6 | DP2 / D+ | `DP` | `U13.5`、`USB1.A6` |
| B7 | DN2 / D− | `DN` | `U13.6`、`USB1.A7` |
| B8 | SBU2 | `NC` | PDF 标 × / 未连接，TEL 不导出此端点 |
| B9 | VBUS | `USB+5V` | 公用网络，共 15 个端点；全部端点见 §6 `USB+5V` |
| B12 | GND | `GND` | 公用网络，共 104 个端点；全部端点见 §6 `GND` |

#### USB2 — HC-TYPE-C-16P-01B，USB Type-C 插座

- 来源：PDF 第 3 页。
- TEL 封装：`USB-C-SMD_KH-TYPE-C-16P`。
- 作用与连接解释：MCU 原生 USB 口：D− 接 PA11，D+ 接 PA12；R15 从 D+ 上拉至 3.3V。PDF 的 USBN/USBP 分别是 PA11/PA12 的同网别名。VBUS 与 USB1 及 DC/DC 输出共网。

| 引脚/焊盘 | 图中功能/端子含义 | 网络 | 同网其他端点或查阅方式 |
|---|---|---|---|
| 1 | EP 外壳焊盘 | `GND` | 公用网络，共 104 个端点；全部端点见 §6 `GND` |
| 2 | EP 外壳焊盘 | `GND` | 公用网络，共 104 个端点；全部端点见 §6 `GND` |
| 3 | EP 外壳焊盘 | `GND` | 公用网络，共 104 个端点；全部端点见 §6 `GND` |
| 4 | EP 外壳焊盘 | `GND` | 公用网络，共 104 个端点；全部端点见 §6 `GND` |
| A1 | GND | `GND` | 公用网络，共 104 个端点；全部端点见 §6 `GND` |
| A4 | VBUS | `USB+5V` | 公用网络，共 15 个端点；全部端点见 §6 `USB+5V` |
| A5 | CC1 | `CC11` | `R13.1` |
| A6 | DP1 / D+ | `PA12` | `H3.26`、`R15.1`、`U5.71`、`USB2.B6` |
| A7 | DN1 / D− | `PA11` | `H3.27`、`U5.70`、`USB2.B7` |
| A8 | SBU1 | `NC` | PDF 标 × / 未连接，TEL 不导出此端点 |
| A9 | VBUS | `USB+5V` | 公用网络，共 15 个端点；全部端点见 §6 `USB+5V` |
| A12 | GND | `GND` | 公用网络，共 104 个端点；全部端点见 §6 `GND` |
| B1 | GND | `GND` | 公用网络，共 104 个端点；全部端点见 §6 `GND` |
| B4 | VBUS | `USB+5V` | 公用网络，共 15 个端点；全部端点见 §6 `USB+5V` |
| B5 | CC2 | `CC12` | `R14.1` |
| B6 | DP2 / D+ | `PA12` | `H3.26`、`R15.1`、`U5.71`、`USB2.A6` |
| B7 | DN2 / D− | `PA11` | `H3.27`、`U5.70`、`USB2.A7` |
| B8 | SBU2 | `NC` | PDF 标 × / 未连接，TEL 不导出此端点 |
| B9 | VBUS | `USB+5V` | 公用网络，共 15 个端点；全部端点见 §6 `USB+5V` |
| B12 | GND | `GND` | 公用网络，共 104 个端点；全部端点见 §6 `GND` |

### 4.6 电阻

#### R1 — 5.1kΩ

- 来源：PDF 第 2 页。
- TEL 封装：`R0603`。
- 作用与连接解释：USB1 CC1 下拉。两端具体编号见表；电阻本身无极性。

| 引脚/焊盘 | 图中功能/端子含义 | 网络 | 同网其他端点或查阅方式 |
|---|---|---|---|
| 1 | 电阻端子（无极性） | `CC21` | `USB1.A5` |
| 2 | 电阻端子（无极性） | `GND` | 公用网络，共 104 个端点；全部端点见 §6 `GND` |

#### R2 — 5.1kΩ

- 来源：PDF 第 2 页。
- TEL 封装：`R0603`。
- 作用与连接解释：USB1 CC2 下拉。两端具体编号见表；电阻本身无极性。

| 引脚/焊盘 | 图中功能/端子含义 | 网络 | 同网其他端点或查阅方式 |
|---|---|---|---|
| 1 | 电阻端子（无极性） | `CC22` | `USB1.B5` |
| 2 | 电阻端子（无极性） | `GND` | 公用网络，共 104 个端点；全部端点见 §6 `GND` |

#### R3 — 10kΩ

- 来源：PDF 第 2 页。
- TEL 封装：`R0603`。
- 作用与连接解释：降压输出到 FB 的上臂分压电阻。两端具体编号见表；电阻本身无极性。

| 引脚/焊盘 | 图中功能/端子含义 | 网络 | 同网其他端点或查阅方式 |
|---|---|---|---|
| 1 | 电阻端子（无极性） | `USB+5V` | 公用网络，共 15 个端点；全部端点见 §6 `USB+5V` |
| 2 | 电阻端子（无极性） | `FB` | `R4.2`、`U1.4` |

#### R4 — 3.16kΩ

- 来源：PDF 第 2 页。
- TEL 封装：`R0603`。
- 作用与连接解释：FB 到 GND 的下臂分压电阻。两端具体编号见表；电阻本身无极性。

| 引脚/焊盘 | 图中功能/端子含义 | 网络 | 同网其他端点或查阅方式 |
|---|---|---|---|
| 1 | 电阻端子（无极性） | `GND` | 公用网络，共 104 个端点；全部端点见 §6 `GND` |
| 2 | 电阻端子（无极性） | `FB` | `R3.2`、`U1.4` |

#### R5 — 2kΩ

- 来源：PDF 第 2 页。
- TEL 封装：`R0603`。
- 作用与连接解释：3.3V 电源指示 LED1 限流。两端具体编号见表；电阻本身无极性。

| 引脚/焊盘 | 图中功能/端子含义 | 网络 | 同网其他端点或查阅方式 |
|---|---|---|---|
| 1 | 电阻端子（无极性） | `GND` | 公用网络，共 104 个端点；全部端点见 §6 `GND` |
| 2 | 电阻端子（无极性） | `$2N72` | `LED1.1` |

#### R6 — 5kΩ

- 来源：PDF 第 2 页。
- TEL 封装：`R0603`。
- 作用与连接解释：公共 5V 指示 LED2 限流。两端具体编号见表；电阻本身无极性。

| 引脚/焊盘 | 图中功能/端子含义 | 网络 | 同网其他端点或查阅方式 |
|---|---|---|---|
| 1 | 电阻端子（无极性） | `GND` | 公用网络，共 104 个端点；全部端点见 §6 `GND` |
| 2 | 电阻端子（无极性） | `$2N71` | `LED2.1` |

#### R7 — 0Ω

- 来源：PDF 第 2 页。
- TEL 封装：`R0603`。
- 作用与连接解释：数字 3.3V 与模拟 3.3V 的 0Ω 连接。两端具体编号见表；电阻本身无极性。

| 引脚/焊盘 | 图中功能/端子含义 | 网络 | 同网其他端点或查阅方式 |
|---|---|---|---|
| 1 | 电阻端子（无极性） | `VCCA+3.3V` | `C12.2`、`R9.1`、`U5.22` |
| 2 | 电阻端子（无极性） | `VCC+3.3V` | 公用网络，共 42 个端点；全部端点见 §6 `VCC+3.3V` |

#### R8 — 0Ω

- 来源：PDF 第 2 页。
- TEL 封装：`R0603`。
- 作用与连接解释：GND 与 AGND 的 0Ω 连接。两端具体编号见表；电阻本身无极性。

| 引脚/焊盘 | 图中功能/端子含义 | 网络 | 同网其他端点或查阅方式 |
|---|---|---|---|
| 1 | 电阻端子（无极性） | `AGND` | 公用网络，共 22 个端点；全部端点见 §6 `AGND` |
| 2 | 电阻端子（无极性） | `GND` | 公用网络，共 104 个端点；全部端点见 §6 `GND` |

#### R9 — 1kΩ

- 来源：PDF 第 1 页。
- TEL 封装：`R0603`。
- 作用与连接解释：TL431 分流参考节点的串联供电/限流。两端具体编号见表；电阻本身无极性。

| 引脚/焊盘 | 图中功能/端子含义 | 网络 | 同网其他端点或查阅方式 |
|---|---|---|---|
| 1 | 电阻端子（无极性） | `VCCA+3.3V` | `C12.2`、`R7.1`、`U5.22` |
| 2 | 电阻端子（无极性） | `$1N96` | `C19.2`、`U5.21`、`U6.1`、`U6.2` |

#### R10 — 10kΩ

- 来源：PDF 第 1 页。
- TEL 封装：`R0603`。
- 作用与连接解释：NRST 外部上拉。两端具体编号见表；电阻本身无极性。

| 引脚/焊盘 | 图中功能/端子含义 | 网络 | 同网其他端点或查阅方式 |
|---|---|---|---|
| 1 | 电阻端子（无极性） | `RST` | `C24.2`、`SW1.1`、`SW1.2`、`U5.14`、`U14.2` |
| 2 | 电阻端子（无极性） | `VCC+3.3V` | 公用网络，共 42 个端点；全部端点见 §6 `VCC+3.3V` |

#### R11 — 10kΩ

- 来源：PDF 第 1 页。
- TEL 封装：`R0603`。
- 作用与连接解释：BOOT1 跳帽与 PB2 间的串联选择电阻。两端具体编号见表；电阻本身无极性。

| 引脚/焊盘 | 图中功能/端子含义 | 网络 | 同网其他端点或查阅方式 |
|---|---|---|---|
| 1 | 电阻端子（无极性） | `$1N120` | `H1.3` |
| 2 | 电阻端子（无极性） | `BOOT1` | `H2.36`、`U5.37` |

#### R12 — 10kΩ

- 来源：PDF 第 1 页。
- TEL 封装：`R0603`。
- 作用与连接解释：BOOT0 跳帽与 MCU 间的串联选择电阻。两端具体编号见表；电阻本身无极性。

| 引脚/焊盘 | 图中功能/端子含义 | 网络 | 同网其他端点或查阅方式 |
|---|---|---|---|
| 1 | 电阻端子（无极性） | `BOOT0` | `R29.1`、`U5.94` |
| 2 | 电阻端子（无极性） | `$1N121` | `H1.4` |

#### R13 — 5.1kΩ

- 来源：PDF 第 3 页。
- TEL 封装：`R0603`。
- 作用与连接解释：USB2 CC1 下拉。两端具体编号见表；电阻本身无极性。

| 引脚/焊盘 | 图中功能/端子含义 | 网络 | 同网其他端点或查阅方式 |
|---|---|---|---|
| 1 | 电阻端子（无极性） | `CC11` | `USB2.A5` |
| 2 | 电阻端子（无极性） | `GND` | 公用网络，共 104 个端点；全部端点见 §6 `GND` |

#### R14 — 5.1kΩ

- 来源：PDF 第 3 页。
- TEL 封装：`R0603`。
- 作用与连接解释：USB2 CC2 下拉。两端具体编号见表；电阻本身无极性。

| 引脚/焊盘 | 图中功能/端子含义 | 网络 | 同网其他端点或查阅方式 |
|---|---|---|---|
| 1 | 电阻端子（无极性） | `CC12` | `USB2.B5` |
| 2 | 电阻端子（无极性） | `GND` | 公用网络，共 104 个端点；全部端点见 §6 `GND` |

#### R15 — 10kΩ

- 来源：PDF 第 3 页。
- TEL 封装：`R0603`。
- 作用与连接解释：MCU USB D+（PA12）到 3.3V 的上拉；原图/网表均为 10kΩ，本文不静默改值。两端具体编号见表；电阻本身无极性。

| 引脚/焊盘 | 图中功能/端子含义 | 网络 | 同网其他端点或查阅方式 |
|---|---|---|---|
| 1 | 电阻端子（无极性） | `PA12` | `H3.26`、`U5.71`、`USB2.A6`、`USB2.B6` |
| 2 | 电阻端子（无极性） | `VCC+3.3V` | 公用网络，共 42 个端点；全部端点见 §6 `VCC+3.3V` |

#### R16 — 2kΩ

- 来源：PDF 第 3 页。
- TEL 封装：`R0603`。
- 作用与连接解释：LED3（PB6）限流。两端具体编号见表；电阻本身无极性。

| 引脚/焊盘 | 图中功能/端子含义 | 网络 | 同网其他端点或查阅方式 |
|---|---|---|---|
| 1 | 电阻端子（无极性） | `VCC+3.3V` | 公用网络，共 42 个端点；全部端点见 §6 `VCC+3.3V` |
| 2 | 电阻端子（无极性） | `$3N152` | `LED3.2` |

#### R17 — 2kΩ

- 来源：PDF 第 3 页。
- TEL 封装：`R0603`。
- 作用与连接解释：LED4（PB7）限流。两端具体编号见表；电阻本身无极性。

| 引脚/焊盘 | 图中功能/端子含义 | 网络 | 同网其他端点或查阅方式 |
|---|---|---|---|
| 1 | 电阻端子（无极性） | `VCC+3.3V` | 公用网络，共 42 个端点；全部端点见 §6 `VCC+3.3V` |
| 2 | 电阻端子（无极性） | `$3N154` | `LED4.2` |

#### R18 — 2kΩ

- 来源：PDF 第 3 页。
- TEL 封装：`R0603`。
- 作用与连接解释：LED5（PD8）限流。两端具体编号见表；电阻本身无极性。

| 引脚/焊盘 | 图中功能/端子含义 | 网络 | 同网其他端点或查阅方式 |
|---|---|---|---|
| 1 | 电阻端子（无极性） | `VCC+3.3V` | 公用网络，共 42 个端点；全部端点见 §6 `VCC+3.3V` |
| 2 | 电阻端子（无极性） | `$3N156` | `LED5.2` |

#### R19 — 4.7kΩ

- 来源：PDF 第 3 页。
- TEL 封装：`R0603`。
- 作用与连接解释：U12 PB15/SCL 固定上拉。两端具体编号见表；电阻本身无极性。

| 引脚/焊盘 | 图中功能/端子含义 | 网络 | 同网其他端点或查阅方式 |
|---|---|---|---|
| 1 | 电阻端子（无极性） | `PB15` | `H3.43`、`U5.54`、`U12.2` |
| 2 | 电阻端子（无极性） | `VCC+3.3V` | 公用网络，共 42 个端点；全部端点见 §6 `VCC+3.3V` |

#### R20 — 4.7kΩ

- 来源：PDF 第 3 页。
- TEL 封装：`R0603`。
- 作用与连接解释：U12 PB14/SDA 固定上拉。两端具体编号见表；电阻本身无极性。

| 引脚/焊盘 | 图中功能/端子含义 | 网络 | 同网其他端点或查阅方式 |
|---|---|---|---|
| 1 | 电阻端子（无极性） | `PB14` | `H3.44`、`U5.53`、`U12.3` |
| 2 | 电阻端子（无极性） | `VCC+3.3V` | 公用网络，共 42 个端点；全部端点见 §6 `VCC+3.3V` |

#### R21 — 4.7kΩ

- 来源：PDF 第 3 页。
- TEL 封装：`R0603`。
- 作用与连接解释：经 SW5 接 PB10 的可选择上拉。两端具体编号见表；电阻本身无极性。

| 引脚/焊盘 | 图中功能/端子含义 | 网络 | 同网其他端点或查阅方式 |
|---|---|---|---|
| 1 | 电阻端子（无极性） | `$3N118` | `SW5.6` |
| 2 | 电阻端子（无极性） | `VCC+3.3V` | 公用网络，共 42 个端点；全部端点见 §6 `VCC+3.3V` |

#### R22 — 4.7kΩ

- 来源：PDF 第 3 页。
- TEL 封装：`R0603`。
- 作用与连接解释：经 SW5 接 PB11 的可选择上拉。两端具体编号见表；电阻本身无极性。

| 引脚/焊盘 | 图中功能/端子含义 | 网络 | 同网其他端点或查阅方式 |
|---|---|---|---|
| 1 | 电阻端子（无极性） | `$3N119` | `SW5.5` |
| 2 | 电阻端子（无极性） | `VCC+3.3V` | 公用网络，共 42 个端点；全部端点见 §6 `VCC+3.3V` |

#### R23 — 4.7kΩ

- 来源：PDF 第 3 页。
- TEL 封装：`R0603`。
- 作用与连接解释：经 SW7 接 PC10 的可选择上拉。两端具体编号见表；电阻本身无极性。

| 引脚/焊盘 | 图中功能/端子含义 | 网络 | 同网其他端点或查阅方式 |
|---|---|---|---|
| 1 | 电阻端子（无极性） | `$3N124` | `SW7.6` |
| 2 | 电阻端子（无极性） | `VCC+3.3V` | 公用网络，共 42 个端点；全部端点见 §6 `VCC+3.3V` |

#### R24 — 4.7kΩ

- 来源：PDF 第 3 页。
- TEL 封装：`R0603`。
- 作用与连接解释：经 SW7 接 PC11 的可选择上拉。两端具体编号见表；电阻本身无极性。

| 引脚/焊盘 | 图中功能/端子含义 | 网络 | 同网其他端点或查阅方式 |
|---|---|---|---|
| 1 | 电阻端子（无极性） | `$3N125` | `SW7.5` |
| 2 | 电阻端子（无极性） | `VCC+3.3V` | 公用网络，共 42 个端点；全部端点见 §6 `VCC+3.3V` |

#### R25 — 4.7kΩ

- 来源：PDF 第 3 页。
- TEL 封装：`R0603`。
- 作用与连接解释：经 SW6 接 PA2 的可选择上拉。两端具体编号见表；电阻本身无极性。

| 引脚/焊盘 | 图中功能/端子含义 | 网络 | 同网其他端点或查阅方式 |
|---|---|---|---|
| 1 | 电阻端子（无极性） | `$3N121` | `SW6.6` |
| 2 | 电阻端子（无极性） | `VCC+3.3V` | 公用网络，共 42 个端点；全部端点见 §6 `VCC+3.3V` |

#### R26 — 4.7kΩ

- 来源：PDF 第 3 页。
- TEL 封装：`R0603`。
- 作用与连接解释：经 SW6 接 PA3 的可选择上拉。两端具体编号见表；电阻本身无极性。

| 引脚/焊盘 | 图中功能/端子含义 | 网络 | 同网其他端点或查阅方式 |
|---|---|---|---|
| 1 | 电阻端子（无极性） | `$3N122` | `SW6.5` |
| 2 | 电阻端子（无极性） | `VCC+3.3V` | 公用网络，共 42 个端点；全部端点见 §6 `VCC+3.3V` |

#### R27 — 10kΩ

- 来源：PDF 第 3 页。
- TEL 封装：`R0603`。
- 作用与连接解释：Q1 集电极/复位驱动节点上拉。两端具体编号见表；电阻本身无极性。

| 引脚/焊盘 | 图中功能/端子含义 | 网络 | 同网其他端点或查阅方式 |
|---|---|---|---|
| 1 | 电阻端子（无极性） | `$3N137` | `Q1.3`、`U14.1` |
| 2 | 电阻端子（无极性） | `VCC+3.3V` | 公用网络，共 42 个端点；全部端点见 §6 `VCC+3.3V` |

#### R28 — 1kΩ

- 来源：PDF 第 3 页。
- TEL 封装：`R0603`。
- 作用与连接解释：DTR 到 Q1 基极串联限流。两端具体编号见表；电阻本身无极性。

| 引脚/焊盘 | 图中功能/端子含义 | 网络 | 同网其他端点或查阅方式 |
|---|---|---|---|
| 1 | 电阻端子（无极性） | `DTR` | `U13.13` |
| 2 | 电阻端子（无极性） | `$3N140` | `Q1.1` |

#### R29 — 1kΩ

- 来源：PDF 第 3 页。
- TEL 封装：`R0603`。
- 作用与连接解释：Q2 集电极到 BOOT0 串联电阻。两端具体编号见表；电阻本身无极性。

| 引脚/焊盘 | 图中功能/端子含义 | 网络 | 同网其他端点或查阅方式 |
|---|---|---|---|
| 1 | 电阻端子（无极性） | `BOOT0` | `R12.1`、`U5.94` |
| 2 | 电阻端子（无极性） | `$3N142` | `Q2.3` |

#### R30 — 1kΩ

- 来源：PDF 第 3 页。
- TEL 封装：`R0603`。
- 作用与连接解释：RTS 到 Q2 基极串联限流。两端具体编号见表；电阻本身无极性。

| 引脚/焊盘 | 图中功能/端子含义 | 网络 | 同网其他端点或查阅方式 |
|---|---|---|---|
| 1 | 电阻端子（无极性） | `RTS` | `Q1.2`、`U13.14` |
| 2 | 电阻端子（无极性） | `$3N144` | `Q2.1` |

### 4.7 电容

#### C1 — 4.7uF

- 来源：PDF 第 2 页。
- TEL 封装：`CAP-SMD_BD4.0-L4.3-W4.3-LS5.0-FD`。
- 作用与连接解释：外部 DC 输入滤波，正端 1、负端 2。PDF 画有极性标记。

| 引脚/焊盘 | 图中功能/端子含义 | 网络 | 同网其他端点或查阅方式 |
|---|---|---|---|
| 1 | 正端 | `$2N18` | `C2.1`、`C3.2`、`D1.2`、`U1.7` |
| 2 | 负端 | `GND` | 公用网络，共 104 个端点；全部端点见 §6 `GND` |

#### C2 — 4.7uF

- 来源：PDF 第 2 页。
- TEL 封装：`CAP-SMD_BD4.0-L4.3-W4.3-LS5.0-FD`。
- 作用与连接解释：外部 DC 输入滤波，正端 1、负端 2。PDF 画有极性标记。

| 引脚/焊盘 | 图中功能/端子含义 | 网络 | 同网其他端点或查阅方式 |
|---|---|---|---|
| 1 | 正端 | `$2N18` | `C1.1`、`C3.2`、`D1.2`、`U1.7` |
| 2 | 负端 | `GND` | 公用网络，共 104 个端点；全部端点见 §6 `GND` |

#### C3 — 10nF

- 来源：PDF 第 2 页。
- TEL 封装：`C0603`。
- 作用与连接解释：外部 DC 输入高频旁路。PDF 未标该器件正负极，不能把网表脚号当作电气极性。

| 引脚/焊盘 | 图中功能/端子含义 | 网络 | 同网其他端点或查阅方式 |
|---|---|---|---|
| 1 | 电容端子（图中无极性） | `GND` | 公用网络，共 104 个端点；全部端点见 §6 `GND` |
| 2 | 电容端子（图中无极性） | `$2N18` | `C1.1`、`C2.1`、`D1.2`、`U1.7` |

#### C4 — 10nF

- 来源：PDF 第 2 页。
- TEL 封装：`C0603`。
- 作用与连接解释：TPS5450 BOOT–PH 自举电容，不是对地滤波。PDF 未标该器件正负极，不能把网表脚号当作电气极性。

| 引脚/焊盘 | 图中功能/端子含义 | 网络 | 同网其他端点或查阅方式 |
|---|---|---|---|
| 1 | 电容端子（图中无极性） | `$2N41` | `D2.2`、`L1.1`、`U1.8` |
| 2 | 电容端子（图中无极性） | `$2N43` | `U1.1` |

#### C5 — 47uF

- 来源：PDF 第 2 页。
- TEL 封装：`CAP-SMD_BD6.3-L6.6-W6.6-LS7.3-FD`。
- 作用与连接解释：公共 5V 输出滤波，正端 1、负端 2。PDF 画有极性标记。

| 引脚/焊盘 | 图中功能/端子含义 | 网络 | 同网其他端点或查阅方式 |
|---|---|---|---|
| 1 | 正端 | `USB+5V` | 公用网络，共 15 个端点；全部端点见 §6 `USB+5V` |
| 2 | 负端 | `GND` | 公用网络，共 104 个端点；全部端点见 §6 `GND` |

#### C6 — 47uF

- 来源：PDF 第 2 页。
- TEL 封装：`CAP-SMD_BD6.3-L6.6-W6.6-LS7.3-FD`。
- 作用与连接解释：公共 5V 输出滤波，正端 1、负端 2。PDF 画有极性标记。

| 引脚/焊盘 | 图中功能/端子含义 | 网络 | 同网其他端点或查阅方式 |
|---|---|---|---|
| 1 | 正端 | `USB+5V` | 公用网络，共 15 个端点；全部端点见 §6 `USB+5V` |
| 2 | 负端 | `GND` | 公用网络，共 104 个端点；全部端点见 §6 `GND` |

#### C7 — 10nF

- 来源：PDF 第 2 页。
- TEL 封装：`C0603`。
- 作用与连接解释：公共 5V 高频旁路。PDF 未标该器件正负极，不能把网表脚号当作电气极性。

| 引脚/焊盘 | 图中功能/端子含义 | 网络 | 同网其他端点或查阅方式 |
|---|---|---|---|
| 1 | 电容端子（图中无极性） | `GND` | 公用网络，共 104 个端点；全部端点见 §6 `GND` |
| 2 | 电容端子（图中无极性） | `USB+5V` | 公用网络，共 15 个端点；全部端点见 §6 `USB+5V` |

#### C8 — 10uF

- 来源：PDF 第 2 页。
- TEL 封装：`C0603`。
- 作用与连接解释：AMS1117 5V 输入滤波。PDF 未标该器件正负极，不能把网表脚号当作电气极性。

| 引脚/焊盘 | 图中功能/端子含义 | 网络 | 同网其他端点或查阅方式 |
|---|---|---|---|
| 1 | 电容端子（图中无极性） | `GND` | 公用网络，共 104 个端点；全部端点见 §6 `GND` |
| 2 | 电容端子（图中无极性） | `VCC+5V` | `C9.2`、`H2.1`、`H2.3`、`H2.5`、`H2.7`、`P1.1`、`P2.1`、`P3.1`、`U3.2`、`U4.3`、`U11.1`、`U12.1` |

#### C9 — 100nF

- 来源：PDF 第 2 页。
- TEL 封装：`C0603`。
- 作用与连接解释：AMS1117 5V 输入去耦。PDF 未标该器件正负极，不能把网表脚号当作电气极性。

| 引脚/焊盘 | 图中功能/端子含义 | 网络 | 同网其他端点或查阅方式 |
|---|---|---|---|
| 1 | 电容端子（图中无极性） | `GND` | 公用网络，共 104 个端点；全部端点见 §6 `GND` |
| 2 | 电容端子（图中无极性） | `VCC+5V` | `C8.2`、`H2.1`、`H2.3`、`H2.5`、`H2.7`、`P1.1`、`P2.1`、`P3.1`、`U3.2`、`U4.3`、`U11.1`、`U12.1` |

#### C10 — 10uF

- 来源：PDF 第 2 页。
- TEL 封装：`C0603`。
- 作用与连接解释：AMS1117 3.3V 输出滤波。PDF 未标该器件正负极，不能把网表脚号当作电气极性。

| 引脚/焊盘 | 图中功能/端子含义 | 网络 | 同网其他端点或查阅方式 |
|---|---|---|---|
| 1 | 电容端子（图中无极性） | `GND` | 公用网络，共 104 个端点；全部端点见 §6 `GND` |
| 2 | 电容端子（图中无极性） | `VCC+3.3V` | 公用网络，共 42 个端点；全部端点见 §6 `VCC+3.3V` |

#### C11 — 100nF

- 来源：PDF 第 2 页。
- TEL 封装：`C0603`。
- 作用与连接解释：AMS1117 3.3V 输出去耦。PDF 未标该器件正负极，不能把网表脚号当作电气极性。

| 引脚/焊盘 | 图中功能/端子含义 | 网络 | 同网其他端点或查阅方式 |
|---|---|---|---|
| 1 | 电容端子（图中无极性） | `GND` | 公用网络，共 104 个端点；全部端点见 §6 `GND` |
| 2 | 电容端子（图中无极性） | `VCC+3.3V` | 公用网络，共 42 个端点；全部端点见 §6 `VCC+3.3V` |

#### C12 — 100nF

- 来源：PDF 第 2 页。
- TEL 封装：`C0603`。
- 作用与连接解释：模拟 3.3V 到 AGND 去耦。PDF 未标该器件正负极，不能把网表脚号当作电气极性。

| 引脚/焊盘 | 图中功能/端子含义 | 网络 | 同网其他端点或查阅方式 |
|---|---|---|---|
| 1 | 电容端子（图中无极性） | `AGND` | 公用网络，共 22 个端点；全部端点见 §6 `AGND` |
| 2 | 电容端子（图中无极性） | `VCCA+3.3V` | `R7.1`、`R9.1`、`U5.22` |

#### C13 — 100nF

- 来源：PDF 第 1 页。
- TEL 封装：`C0603`。
- 作用与连接解释：MCU 数字电源去耦。PDF 未标该器件正负极，不能把网表脚号当作电气极性。

| 引脚/焊盘 | 图中功能/端子含义 | 网络 | 同网其他端点或查阅方式 |
|---|---|---|---|
| 1 | 电容端子（图中无极性） | `GND` | 公用网络，共 104 个端点；全部端点见 §6 `GND` |
| 2 | 电容端子（图中无极性） | `VCC+3.3V` | 公用网络，共 42 个端点；全部端点见 §6 `VCC+3.3V` |

#### C14 — 100nF

- 来源：PDF 第 1 页。
- TEL 封装：`C0603`。
- 作用与连接解释：MCU 数字电源去耦。PDF 未标该器件正负极，不能把网表脚号当作电气极性。

| 引脚/焊盘 | 图中功能/端子含义 | 网络 | 同网其他端点或查阅方式 |
|---|---|---|---|
| 1 | 电容端子（图中无极性） | `VCC+3.3V` | 公用网络，共 42 个端点；全部端点见 §6 `VCC+3.3V` |
| 2 | 电容端子（图中无极性） | `GND` | 公用网络，共 104 个端点；全部端点见 §6 `GND` |

#### C15 — 100nF

- 来源：PDF 第 1 页。
- TEL 封装：`C0603`。
- 作用与连接解释：MCU 数字电源去耦。PDF 未标该器件正负极，不能把网表脚号当作电气极性。

| 引脚/焊盘 | 图中功能/端子含义 | 网络 | 同网其他端点或查阅方式 |
|---|---|---|---|
| 1 | 电容端子（图中无极性） | `VCC+3.3V` | 公用网络，共 42 个端点；全部端点见 §6 `VCC+3.3V` |
| 2 | 电容端子（图中无极性） | `GND` | 公用网络，共 104 个端点；全部端点见 §6 `GND` |

#### C16 — 100nF

- 来源：PDF 第 1 页。
- TEL 封装：`C0603`。
- 作用与连接解释：MCU 数字电源去耦。PDF 未标该器件正负极，不能把网表脚号当作电气极性。

| 引脚/焊盘 | 图中功能/端子含义 | 网络 | 同网其他端点或查阅方式 |
|---|---|---|---|
| 1 | 电容端子（图中无极性） | `VCC+3.3V` | 公用网络，共 42 个端点；全部端点见 §6 `VCC+3.3V` |
| 2 | 电容端子（图中无极性） | `GND` | 公用网络，共 104 个端点；全部端点见 §6 `GND` |

#### C17 — 100nF

- 来源：PDF 第 1 页。
- TEL 封装：`C0603`。
- 作用与连接解释：MCU 数字电源去耦。PDF 未标该器件正负极，不能把网表脚号当作电气极性。

| 引脚/焊盘 | 图中功能/端子含义 | 网络 | 同网其他端点或查阅方式 |
|---|---|---|---|
| 1 | 电容端子（图中无极性） | `VCC+3.3V` | 公用网络，共 42 个端点；全部端点见 §6 `VCC+3.3V` |
| 2 | 电容端子（图中无极性） | `GND` | 公用网络，共 104 个端点；全部端点见 §6 `GND` |

#### C18 — 100nF

- 来源：PDF 第 1 页。
- TEL 封装：`C0603`。
- 作用与连接解释：VBAT 备用供电去耦。PDF 未标该器件正负极，不能把网表脚号当作电气极性。

| 引脚/焊盘 | 图中功能/端子含义 | 网络 | 同网其他端点或查阅方式 |
|---|---|---|---|
| 1 | 电容端子（图中无极性） | `$1N89` | `D3.3`、`U5.6` |
| 2 | 电容端子（图中无极性） | `GND` | 公用网络，共 104 个端点；全部端点见 §6 `GND` |

#### C19 — 10uF

- 来源：PDF 第 1 页。
- TEL 封装：`C0603`。
- 作用与连接解释：TL431/VREF+ 到 AGND 滤波。PDF 未标该器件正负极，不能把网表脚号当作电气极性。

| 引脚/焊盘 | 图中功能/端子含义 | 网络 | 同网其他端点或查阅方式 |
|---|---|---|---|
| 1 | 电容端子（图中无极性） | `AGND` | 公用网络，共 22 个端点；全部端点见 §6 `AGND` |
| 2 | 电容端子（图中无极性） | `$1N96` | `R9.2`、`U5.21`、`U6.1`、`U6.2` |

#### C20 — 20pF

- 来源：PDF 第 1 页。
- TEL 封装：`C0603`。
- 作用与连接解释：8MHz OSC_IN 端负载。PDF 未标该器件正负极，不能把网表脚号当作电气极性。

| 引脚/焊盘 | 图中功能/端子含义 | 网络 | 同网其他端点或查阅方式 |
|---|---|---|---|
| 1 | 电容端子（图中无极性） | `GND` | 公用网络，共 104 个端点；全部端点见 §6 `GND` |
| 2 | 电容端子（图中无极性） | `OSCH1` | `U5.12`、`X1.3` |

#### C21 — 20pF

- 来源：PDF 第 1 页。
- TEL 封装：`C0603`。
- 作用与连接解释：8MHz OSC_OUT 端负载。PDF 未标该器件正负极，不能把网表脚号当作电气极性。

| 引脚/焊盘 | 图中功能/端子含义 | 网络 | 同网其他端点或查阅方式 |
|---|---|---|---|
| 1 | 电容端子（图中无极性） | `OSCH2` | `U5.13`、`X1.1` |
| 2 | 电容端子（图中无极性） | `GND` | 公用网络，共 104 个端点；全部端点见 §6 `GND` |

#### C22 — 10pF

- 来源：PDF 第 1 页。
- TEL 封装：`C0603`。
- 作用与连接解释：32.768kHz OSC32K_IN 端负载。PDF 未标该器件正负极，不能把网表脚号当作电气极性。

| 引脚/焊盘 | 图中功能/端子含义 | 网络 | 同网其他端点或查阅方式 |
|---|---|---|---|
| 1 | 电容端子（图中无极性） | `GND` | 公用网络，共 104 个端点；全部端点见 §6 `GND` |
| 2 | 电容端子（图中无极性） | `OSCL1` | `U5.8`、`X2.1` |

#### C23 — 10pF

- 来源：PDF 第 1 页。
- TEL 封装：`C0603`。
- 作用与连接解释：32.768kHz OSC32K_OUT 端负载。PDF 未标该器件正负极，不能把网表脚号当作电气极性。

| 引脚/焊盘 | 图中功能/端子含义 | 网络 | 同网其他端点或查阅方式 |
|---|---|---|---|
| 1 | 电容端子（图中无极性） | `GND` | 公用网络，共 104 个端点；全部端点见 §6 `GND` |
| 2 | 电容端子（图中无极性） | `OSCL2` | `U5.9`、`X2.2` |

#### C24 — 100nF

- 来源：PDF 第 1 页。
- TEL 封装：`C0603`。
- 作用与连接解释：NRST 复位滤波/RC。PDF 未标该器件正负极，不能把网表脚号当作电气极性。

| 引脚/焊盘 | 图中功能/端子含义 | 网络 | 同网其他端点或查阅方式 |
|---|---|---|---|
| 1 | 电容端子（图中无极性） | `GND` | 公用网络，共 104 个端点；全部端点见 §6 `GND` |
| 2 | 电容端子（图中无极性） | `RST` | `R10.1`、`SW1.1`、`SW1.2`、`U5.14`、`U14.2` |

#### C25 — 100nF

- 来源：PDF 第 3 页。
- TEL 封装：`C0603`。
- 作用与连接解释：PE13 按键滤波。PDF 未标该器件正负极，不能把网表脚号当作电气极性。

| 引脚/焊盘 | 图中功能/端子含义 | 网络 | 同网其他端点或查阅方式 |
|---|---|---|---|
| 1 | 电容端子（图中无极性） | `GND` | 公用网络，共 104 个端点；全部端点见 §6 `GND` |
| 2 | 电容端子（图中无极性） | `PE13` | `H2.41`、`SW2.1`、`SW2.2`、`U5.44` |

#### C26 — 100nF

- 来源：PDF 第 3 页。
- TEL 封装：`C0603`。
- 作用与连接解释：PE14 按键滤波。PDF 未标该器件正负极，不能把网表脚号当作电气极性。

| 引脚/焊盘 | 图中功能/端子含义 | 网络 | 同网其他端点或查阅方式 |
|---|---|---|---|
| 1 | 电容端子（图中无极性） | `GND` | 公用网络，共 104 个端点；全部端点见 §6 `GND` |
| 2 | 电容端子（图中无极性） | `PE14` | `H2.44`、`SW3.1`、`SW3.2`、`U5.45` |

#### C27 — 100nF

- 来源：PDF 第 3 页。
- TEL 封装：`C0603`。
- 作用与连接解释：PE15 按键滤波。PDF 未标该器件正负极，不能把网表脚号当作电气极性。

| 引脚/焊盘 | 图中功能/端子含义 | 网络 | 同网其他端点或查阅方式 |
|---|---|---|---|
| 1 | 电容端子（图中无极性） | `GND` | 公用网络，共 104 个端点；全部端点见 §6 `GND` |
| 2 | 电容端子（图中无极性） | `PE15` | `H2.43`、`SW4.1`、`SW4.2`、`U5.46` |

#### C28 — 100nF

- 来源：PDF 第 3 页。
- TEL 封装：`C0603`。
- 作用与连接解释：CH340C 3.3V 供电去耦。PDF 未标该器件正负极，不能把网表脚号当作电气极性。

| 引脚/焊盘 | 图中功能/端子含义 | 网络 | 同网其他端点或查阅方式 |
|---|---|---|---|
| 1 | 电容端子（图中无极性） | `VCC+3.3V` | 公用网络，共 42 个端点；全部端点见 §6 `VCC+3.3V` |
| 2 | 电容端子（图中无极性） | `GND` | 公用网络，共 104 个端点；全部端点见 §6 `GND` |

### 4.8 按键、开关、LED与安装孔

#### SCREW1 — M3 安装孔/螺丝接地焊盘

- 来源：PDF 第 3 页。
- TEL 封装：`M3螺丝`。
- 作用与连接解释：安装孔导电焊盘接 GND，不是悬浮机械孔；与金属支架或机壳的关系须在整机装配时确认。

| 引脚/焊盘 | 图中功能/端子含义 | 网络 | 同网其他端点或查阅方式 |
|---|---|---|---|
| 1 | 导电安装焊盘 | `GND` | 公用网络，共 104 个端点；全部端点见 §6 `GND` |

#### SCREW2 — M3 安装孔/螺丝接地焊盘

- 来源：PDF 第 3 页。
- TEL 封装：`M3螺丝`。
- 作用与连接解释：安装孔导电焊盘接 GND，不是悬浮机械孔；与金属支架或机壳的关系须在整机装配时确认。

| 引脚/焊盘 | 图中功能/端子含义 | 网络 | 同网其他端点或查阅方式 |
|---|---|---|---|
| 1 | 导电安装焊盘 | `GND` | 公用网络，共 104 个端点；全部端点见 §6 `GND` |

#### SCREW3 — M3 安装孔/螺丝接地焊盘

- 来源：PDF 第 3 页。
- TEL 封装：`M3螺丝`。
- 作用与连接解释：安装孔导电焊盘接 GND，不是悬浮机械孔；与金属支架或机壳的关系须在整机装配时确认。

| 引脚/焊盘 | 图中功能/端子含义 | 网络 | 同网其他端点或查阅方式 |
|---|---|---|---|
| 1 | 导电安装焊盘 | `GND` | 公用网络，共 104 个端点；全部端点见 §6 `GND` |

#### SCREW4 — M3 安装孔/螺丝接地焊盘

- 来源：PDF 第 3 页。
- TEL 封装：`M3螺丝`。
- 作用与连接解释：安装孔导电焊盘接 GND，不是悬浮机械孔；与金属支架或机壳的关系须在整机装配时确认。

| 引脚/焊盘 | 图中功能/端子含义 | 网络 | 同网其他端点或查阅方式 |
|---|---|---|---|
| 1 | 导电安装焊盘 | `GND` | 公用网络，共 104 个端点；全部端点见 §6 `GND` |

#### SW1 — KH-6X6X5H-STM 轻触按键

- 来源：PDF 第 1 页。
- TEL 封装：`SW-SMD_4P-L6.0-W6.0-P4.50-LS9.0_H5.0`。
- 作用与连接解释：同侧 1/2 接 RST，另一侧 3/4 接 GND，按下使 RST 接地；C24 并接该信号到地。RST 有 R10 外部上拉。

| 引脚/焊盘 | 图中功能/端子含义 | 网络 | 同网其他端点或查阅方式 |
|---|---|---|---|
| 1 | 信号侧 | `RST` | `C24.2`、`R10.1`、`SW1.2`、`U5.14`、`U14.2` |
| 2 | 信号侧同组 | `RST` | `C24.2`、`R10.1`、`SW1.1`、`U5.14`、`U14.2` |
| 3 | 地侧 | `GND` | 公用网络，共 104 个端点；全部端点见 §6 `GND` |
| 4 | 地侧同组 | `GND` | 公用网络，共 104 个端点；全部端点见 §6 `GND` |

#### SW2 — KH-6X6X5H-STM 轻触按键

- 来源：PDF 第 3 页。
- TEL 封装：`SW-SMD_4P-L6.0-W6.0-P4.50-LS9.0_H5.0`。
- 作用与连接解释：同侧 1/2 接 PE13，另一侧 3/4 接 GND，按下使 PE13 接地；C25 并接该信号到地。图中没有该用户按键的外部上拉，固件应按实际使用配置内部上拉等输入偏置。

| 引脚/焊盘 | 图中功能/端子含义 | 网络 | 同网其他端点或查阅方式 |
|---|---|---|---|
| 1 | 信号侧 | `PE13` | `C25.2`、`H2.41`、`SW2.2`、`U5.44` |
| 2 | 信号侧同组 | `PE13` | `C25.2`、`H2.41`、`SW2.1`、`U5.44` |
| 3 | 地侧 | `GND` | 公用网络，共 104 个端点；全部端点见 §6 `GND` |
| 4 | 地侧同组 | `GND` | 公用网络，共 104 个端点；全部端点见 §6 `GND` |

#### SW3 — KH-6X6X5H-STM 轻触按键

- 来源：PDF 第 3 页。
- TEL 封装：`SW-SMD_4P-L6.0-W6.0-P4.50-LS9.0_H5.0`。
- 作用与连接解释：同侧 1/2 接 PE14，另一侧 3/4 接 GND，按下使 PE14 接地；C26 并接该信号到地。图中没有该用户按键的外部上拉，固件应按实际使用配置内部上拉等输入偏置。

| 引脚/焊盘 | 图中功能/端子含义 | 网络 | 同网其他端点或查阅方式 |
|---|---|---|---|
| 1 | 信号侧 | `PE14` | `C26.2`、`H2.44`、`SW3.2`、`U5.45` |
| 2 | 信号侧同组 | `PE14` | `C26.2`、`H2.44`、`SW3.1`、`U5.45` |
| 3 | 地侧 | `GND` | 公用网络，共 104 个端点；全部端点见 §6 `GND` |
| 4 | 地侧同组 | `GND` | 公用网络，共 104 个端点；全部端点见 §6 `GND` |

#### SW4 — KH-6X6X5H-STM 轻触按键

- 来源：PDF 第 3 页。
- TEL 封装：`SW-SMD_4P-L6.0-W6.0-P4.50-LS9.0_H5.0`。
- 作用与连接解释：同侧 1/2 接 PE15，另一侧 3/4 接 GND，按下使 PE15 接地；C27 并接该信号到地。图中没有该用户按键的外部上拉，固件应按实际使用配置内部上拉等输入偏置。

| 引脚/焊盘 | 图中功能/端子含义 | 网络 | 同网其他端点或查阅方式 |
|---|---|---|---|
| 1 | 信号侧 | `PE15` | `C27.2`、`H2.43`、`SW4.2`、`U5.46` |
| 2 | 信号侧同组 | `PE15` | `C27.2`、`H2.43`、`SW4.1`、`U5.46` |
| 3 | 地侧 | `GND` | 公用网络，共 104 个端点；全部端点见 §6 `GND` |
| 4 | 地侧同组 | `GND` | 公用网络，共 104 个端点；全部端点见 §6 `GND` |

#### SW5 — MST23D18G2 125，双刀三掷滑动开关

- 来源：PDF 第 3 页。
- TEL 封装：`SW-SMD_SHOU_MST23D18G2`。
- 作用与连接解释：PB10/PB11 各接一组公共触点（3/4），上拉电阻 R21/R22 接对应选择触点（6/5）。图中 A/B 未用触点标 ×，C 触点接上拉；开关只切换上拉是否接入，不把信号切到另一组 MCU 引脚。PDF 注释只使用机械 1、3 档，2 档不使用；该机械档位不是网表引脚号。

| 引脚/焊盘 | 图中功能/端子含义 | 网络 | 同网其他端点或查阅方式 |
|---|---|---|---|
| 3 | 第一组公共触点 | `PB10` | `H2.46`、`P1.2`、`U5.47` |
| 4 | 第二组公共触点 | `PB11` | `H2.45`、`P1.3`、`U5.48` |
| 5 | 第二组上拉选择触点 | `$3N119` | `R22.1` |
| 6 | 第一组上拉选择触点 | `$3N118` | `R21.1` |
| A/B 未使用触点（两组各两端） | PDF 标 ×，本页未明确标注这些端子的物理编号 | `NC` | 图中未接线，TEL 不导出；不得猜测编号或把 × 当成接地 |

#### SW6 — MST23D18G2 125，双刀三掷滑动开关

- 来源：PDF 第 3 页。
- TEL 封装：`SW-SMD_SHOU_MST23D18G2`。
- 作用与连接解释：PA2/PA3 各接一组公共触点（3/4），上拉电阻 R25/R26 接对应选择触点（6/5）。图中 A/B 未用触点标 ×，C 触点接上拉；开关只切换上拉是否接入，不把信号切到另一组 MCU 引脚。PDF 注释只使用机械 1、3 档，2 档不使用；该机械档位不是网表引脚号。

| 引脚/焊盘 | 图中功能/端子含义 | 网络 | 同网其他端点或查阅方式 |
|---|---|---|---|
| 3 | 第一组公共触点 | `PA2` | `H2.26`、`P2.2`、`U5.25` |
| 4 | 第二组公共触点 | `PA3` | `H2.25`、`P2.3`、`U5.26` |
| 5 | 第二组上拉选择触点 | `$3N122` | `R26.1` |
| 6 | 第一组上拉选择触点 | `$3N121` | `R25.1` |
| A/B 未使用触点（两组各两端） | PDF 标 ×，本页未明确标注这些端子的物理编号 | `NC` | 图中未接线，TEL 不导出；不得猜测编号或把 × 当成接地 |

#### SW7 — MST23D18G2 125，双刀三掷滑动开关

- 来源：PDF 第 3 页。
- TEL 封装：`SW-SMD_SHOU_MST23D18G2`。
- 作用与连接解释：PC10/PC11 各接一组公共触点（3/4），上拉电阻 R23/R24 接对应选择触点（6/5）。图中 A/B 未用触点标 ×，C 触点接上拉；开关只切换上拉是否接入，不把信号切到另一组 MCU 引脚。PDF 注释只使用机械 1、3 档，2 档不使用；该机械档位不是网表引脚号。

| 引脚/焊盘 | 图中功能/端子含义 | 网络 | 同网其他端点或查阅方式 |
|---|---|---|---|
| 3 | 第一组公共触点 | `PC10` | `H3.22`、`P3.2`、`U5.78` |
| 4 | 第二组公共触点 | `PC11` | `H3.21`、`P3.3`、`U5.79` |
| 5 | 第二组上拉选择触点 | `$3N125` | `R24.1` |
| 6 | 第一组上拉选择触点 | `$3N124` | `R23.1` |
| A/B 未使用触点（两组各两端） | PDF 标 ×，本页未明确标注这些端子的物理编号 | `NC` | 图中未接线，TEL 不导出；不得猜测编号或把 × 当成接地 |

## 5. 原理图与网表差异、使用限制及待核对项

### 5.1 已确认的差异和补充

1. **型号缺失由 PDF 补齐**：TEL 里多个器件只导出 `{Value}`；PDF 明确了 STM32F103VET6、TPS5450QDDARQ1、AMS1117-3.3、TL431QDBZR、CH340C、S8050/S8550、BAT54C、SS54、1N4007W 及保险丝/连接器型号。
2. **DC+5V 与 USB+5V 已合并**：PDF 的电源合路图上有明确导线连接两个标签；TEL 统一为 USB+5V，不是本文漏了一条独立 DC 电源。
3. **接口别名已归一**：PDF 的 USBN/USBP、TXD/RXD、SCL/SDA、SPI、SWD 标签在 TEL 中多以 GPIO 网络名出现，详见 §2.4。
4. **未连接脚不等于缺失元器件**：U1.2/3/5、U5.73、U13.7/8/9/10/11/12/15、USB1/2.A8/B8 在 PDF 中未连接，本文单列 NC。SW5–SW7 的 A/B 触点也未连接，但不臆造编号。
5. **辅助焊盘不是多出来的接口信号**：PDF 的 P1–P3 符号确实还有 5/6 接地端，U11/U12 有 7/8 接地端；它们对应额外辅助焊盘，功能口仍分别为四针与六针。实际机械焊盘形状仍须对照 PCB 封装。
6. **晶体与 LED 的名称不能只看 TEL 封装**：X1 原理图为无源晶体，但 TEL 封装名包含 SIT8008BI；LED1/2 PDF 型号为 GL0603UG01（绿色），TEL 封装名含 RD。按图识别类型/颜色，生产前再核对实装物料。
7. **本说明没有发现需要把某条已连接 TEL 端点改接别网的证据**；这只表示当前三页可见连接与所用网表可解释地对应，不代表通过完整电气审查或证明两文件导出时刻完全一致。

### 5.2 上电和开发前重点核对

- **多路5V回灌**：USB1/USB2 VBUS 与降压输出处在同一前级5V网络。不要把“电源合路”误读为有防反灌/自动择源电路；D1 仅在 DC 输入侧。是否允许同时接电脑 USB、第二个 USB 或外部 DC，应结合芯片内部反向电流特性、主机保护和实板确认。
- **USB D+ 上拉实为10kΩ**：R15 两份来源都为10kΩ。需按 STM32F103 USB FS 外部上拉要求核对该值、识别可靠性以及断电时供电路径；本文未替用户把它改成其他阻值。
- **参考电压电路不等同于“模拟3.3V”**：U5 VDDA 与 VREF+ 是不同网络。TL431 CAT/REF 短接、R9=1kΩ、C19=10µF 时需验证工作电流余量、输出稳定性和有效参考电压；ADC/DAC 代码不能未经实测把 VREF+ 固定假定成3.3V。
- **BOOT偏置与自动下载**：BOOT1 的静态偏置取决于 H1 跳帽；BOOT0 还受 Q2 控制，未见独立固定下拉。下载结束、控制线释放、跳帽未装时的状态必须测试。DTR/RTS 标签对应的是 CH340C 带 # 的输出，需要核对软件极性与时序。
- **U2机械档位**：图中接地触点和短接输出触点必须按 YSSP2AG00 实际接触结构理解；静态网表不能证明某档不会造成前级5V短接地或明确 ON/OFF 位置。本文不生成未经物料图验证的机械真值表。
- **外设供电与逻辑电平**：P1/P2/P3/U11/U12 提供5V，但信号线直接接3.3V MCU；并非全部信号都能耐受5V，模拟脚尤其需要按 MCU 规格核对。图中未见统一电平转换、模拟缓冲或限流保护。
- **复用冲突**：PB6/PB7/PD8 挂有用户LED；PE13/14/15 挂有按键及电容；PA11/12 挂USB；PA9/10 挂CH340C；PA13/14 挂SWD；PA15/PB3/PB4 挂SPI/JTAG复用。虽然都从 H2/H3 引出，使用时仍要考虑这些板载负载。
- **“串口/IIC切换”只切换上拉**：三个开关没有把信号换接到其他MCU口。PB10/PB11 的硬件 I²C 能力、其他引脚的软件实现和具体重映射需各自配置，不是拨开关就自动切换外设协议。
- **“6路IIC”不意味着6路硬件I²C**：U12 是六功能端子的连接器，PB15/PB14 有两只上拉；其余两GPIO没有此上拉。须按图与固件约定识别。
- **器件规格仍未全给出**：PDF 没标所有电容耐压、电阻功率、电感饱和电流、允许DC输入范围、晶体完整料号及保险丝动作参数。这里的连接说明不补造这些规格。

## 6. 全部网络端点索引

以下按 TEL 顺序列出全部 124 个已连接网络，保留每一个端点。元器件引脚表中的大型公用网络可在这里完整回查。`NC` 不属于已连接网络，不列在此索引中。

### 6.1 `$1N120` — BOOT1 跳帽中间端（经 R11 到 BOOT1）

端点数量：2。

- `H1.3`、`R11.1`

### 6.2 `$1N121` — BOOT0 跳帽中间端（经 R12 到 BOOT0）

端点数量：2。

- `H1.4`、`R12.2`

### 6.3 `$1N87` — 电池正极至 D3 第二路阳极

端点数量：2。

- `BT1.1`、`D3.2`

### 6.4 `$1N89` — VBAT：D3 共阴极输出及 MCU 备用供电

端点数量：3。

- `C18.1`、`D3.3`、`U5.6`

### 6.5 `$1N96` — VREF+：R9 输出、TL431 CAT/REF 与 MCU 参考正端

端点数量：5。

- `C19.2`、`R9.2`、`U5.21`、`U6.1`、`U6.2`

### 6.6 `$2N18` — D1 后的 DC 输入滤波及 U1 VIN 节点

端点数量：5。

- `C1.1`、`C2.1`、`C3.2`、`D1.2`、`U1.7`

### 6.7 `$2N21` — DC 原始输入：CN1/DC1 至 D1 阳极

端点数量：3。

- `CN1.1`、`D1.1`、`DC1.4`

### 6.8 `$2N41` — 降压开关节点 PH：U1、D2、L1、C4

端点数量：4。

- `C4.1`、`D2.2`、`L1.1`、`U1.8`

### 6.9 `$2N43` — U1 BOOT 自举节点

端点数量：2。

- `C4.2`、`U1.1`

### 6.10 `$2N71` — 5V 指示 LED2 阴极与 R6

端点数量：2。

- `LED2.1`、`R6.2`

### 6.11 `$2N72` — 3.3V 指示 LED1 阴极与 R5

端点数量：2。

- `LED1.1`、`R5.2`

### 6.12 `$2N73` — 电源开关输出至保险丝输入

端点数量：3。

- `U2.4`、`U2.5`、`U3.1`

### 6.13 `$3N118` — R21 与 SW5 上拉选择触点

端点数量：2。

- `R21.1`、`SW5.6`

### 6.14 `$3N119` — R22 与 SW5 上拉选择触点

端点数量：2。

- `R22.1`、`SW5.5`

### 6.15 `$3N121` — R25 与 SW6 上拉选择触点

端点数量：2。

- `R25.1`、`SW6.6`

### 6.16 `$3N122` — R26 与 SW6 上拉选择触点

端点数量：2。

- `R26.1`、`SW6.5`

### 6.17 `$3N124` — R23 与 SW7 上拉选择触点

端点数量：2。

- `R23.1`、`SW7.6`

### 6.18 `$3N125` — R24 与 SW7 上拉选择触点

端点数量：2。

- `R24.1`、`SW7.5`

### 6.19 `$3N137` — 自动下载复位驱动：Q1 集电极、R27、U14 阴极

端点数量：3。

- `Q1.3`、`R27.1`、`U14.1`

### 6.20 `$3N140` — Q1 基极，经 R28 接 DTR

端点数量：2。

- `Q1.1`、`R28.2`

### 6.21 `$3N142` — Q2 集电极，经 R29 接 BOOT0

端点数量：2。

- `Q2.3`、`R29.2`

### 6.22 `$3N144` — Q2 基极，经 R30 接 RTS

端点数量：2。

- `Q2.1`、`R30.2`

### 6.23 `$3N152` — LED3 阳极至 R16

端点数量：2。

- `LED3.2`、`R16.2`

### 6.24 `$3N154` — LED4 阳极至 R17

端点数量：2。

- `LED4.2`、`R17.2`

### 6.25 `$3N156` — LED5 阳极至 R18

端点数量：2。

- `LED5.2`、`R18.2`

### 6.26 `USB+5V` — 公共前级 5V：PDF 中 DC+5V 与 USB+5V 被导线合并

端点数量：15。

- `C5.1`、`C6.1`、`C7.2`、`L1.2`、`LED2.2`、`R3.1`、`U2.6`、`USB1.A4`、`USB1.A9`、`USB1.B4`
- `USB1.B9`、`USB2.A4`、`USB2.A9`、`USB2.B4`、`USB2.B9`

### 6.27 `VCC+3.3V` — AMS1117 输出的数字 3.3V

端点数量：42。

- `C10.2`、`C11.2`、`C13.2`、`C14.1`、`C15.1`、`C16.1`、`C17.1`、`C28.1`、`D3.1`、`H1.1`
- `H1.2`、`H2.2`、`H2.4`、`H2.6`、`H2.8`、`H4.1`、`LED1.2`、`Q2.2`、`R7.2`、`R10.2`
- `R15.2`、`R16.1`、`R17.1`、`R18.1`、`R19.2`、`R20.2`、`R21.2`、`R22.2`、`R23.2`、`R24.2`
- `R25.2`、`R26.2`、`R27.2`、`U4.2`、`U4.4`、`U5.11`、`U5.28`、`U5.50`、`U5.75`、`U5.100`
- `U13.4`、`U13.16`

### 6.28 `VCC+5V` — 经 U2/U3 后的板级 5V

端点数量：13。

- `C8.2`、`C9.2`、`H2.1`、`H2.3`、`H2.5`、`H2.7`、`P1.1`、`P2.1`、`P3.1`、`U3.2`
- `U4.3`、`U11.1`、`U12.1`

### 6.29 `VCCA+3.3V` — R7 后模拟 3.3V

端点数量：4。

- `C12.2`、`R7.1`、`R9.1`、`U5.22`

### 6.30 `AGND` — 模拟地，经 R8（0Ω）连接 GND

端点数量：22。

- `C12.1`、`C19.1`、`R8.1`、`U5.19`、`U5.20`、`U6.3`、`U7.1`、`U7.2`、`U7.3`、`U7.4`
- `U8.1`、`U8.2`、`U8.3`、`U8.4`、`U9.1`、`U9.2`、`U9.3`、`U9.4`、`U10.1`、`U10.2`
- `U10.3`、`U10.4`

### 6.31 `BOOT0` — MCU 启动选择输入

端点数量：3。

- `R12.1`、`R29.1`、`U5.94`

### 6.32 `BOOT1` — MCU PB2/BOOT1；原理图中的 PB2 与 BOOT1 为同节点

端点数量：3。

- `H2.36`、`R11.2`、`U5.37`

### 6.33 `CC11` — USB2 CC1 下拉节点

端点数量：2。

- `R13.1`、`USB2.A5`

### 6.34 `CC12` — USB2 CC2 下拉节点

端点数量：2。

- `R14.1`、`USB2.B5`

### 6.35 `CC21` — USB1 CC1 下拉节点

端点数量：2。

- `R1.1`、`USB1.A5`

### 6.36 `CC22` — USB1 CC2 下拉节点

端点数量：2。

- `R2.1`、`USB1.B5`

### 6.37 `DN` — USB1 D− 至 CH340C D−

端点数量：3。

- `U13.6`、`USB1.A7`、`USB1.B7`

### 6.38 `DP` — USB1 D+ 至 CH340C D+

端点数量：3。

- `U13.5`、`USB1.A6`、`USB1.B6`

### 6.39 `DTR` — CH340C DTR# 输出网络（名称未带 #）

端点数量：2。

- `R28.1`、`U13.13`

### 6.40 `FB` — U1 VSENSE 反馈分压中点

端点数量：3。

- `R3.2`、`R4.2`、`U1.4`

### 6.41 `GND` — 数字/电源地

端点数量：104。

- `BT1.2`、`C1.2`、`C2.2`、`C3.1`、`C5.2`、`C6.2`、`C7.1`、`C8.1`、`C9.1`、`C10.1`
- `C11.1`、`C13.1`、`C14.2`、`C15.2`、`C16.2`、`C17.2`、`C18.2`、`C20.1`、`C21.2`、`C22.1`
- `C23.1`、`C24.1`、`C25.1`、`C26.1`、`C27.1`、`C28.2`、`CN1.2`、`D2.1`、`DC1.2`、`DC1.3`
- `H1.5`、`H1.6`、`H2.9`、`H2.10`、`H2.11`、`H2.12`、`H3.1`、`H3.2`、`H4.4`、`P1.4`
- `P1.5`、`P1.6`、`P2.4`、`P2.5`、`P2.6`、`P3.4`、`P3.5`、`P3.6`、`R1.2`、`R2.2`
- `R4.1`、`R5.1`、`R6.1`、`R8.2`、`R13.2`、`R14.2`、`SCREW1.1`、`SCREW2.1`、`SCREW3.1`、`SCREW4.1`
- `SW1.3`、`SW1.4`、`SW2.3`、`SW2.4`、`SW3.3`、`SW3.4`、`SW4.3`、`SW4.4`、`U1.6`、`U1.9`
- `U2.1`、`U2.2`、`U2.3`、`U4.1`、`U5.10`、`U5.27`、`U5.49`、`U5.74`、`U5.99`、`U11.6`
- `U11.7`、`U11.8`、`U12.6`、`U12.7`、`U12.8`、`U13.1`、`USB1.1`、`USB1.2`、`USB1.3`、`USB1.4`
- `USB1.A1`、`USB1.A12`、`USB1.B1`、`USB1.B12`、`USB2.1`、`USB2.2`、`USB2.3`、`USB2.4`、`USB2.A1`、`USB2.A12`
- `USB2.B1`、`USB2.B12`、`X1.2`、`X1.4`

### 6.42 `OSCH1` — 8MHz 晶体输入，U5 OSC_IN

端点数量：3。

- `C20.2`、`U5.12`、`X1.3`

### 6.43 `OSCH2` — 8MHz 晶体输出，U5 OSC_OUT

端点数量：3。

- `C21.1`、`U5.13`、`X1.1`

### 6.44 `OSCL1` — 32.768kHz 晶体输入，PC14/OSC32K_IN

端点数量：3。

- `C22.2`、`U5.8`、`X2.1`

### 6.45 `OSCL2` — 32.768kHz 晶体输出，PC15/OSC32K_OUT

端点数量：3。

- `C23.2`、`U5.9`、`X2.2`

### 6.46 `PA0` — MCU GPIO；同网板载负载和扩展接口见端点

端点数量：3。

- `H2.24`、`U5.23`、`U7.5`

### 6.47 `PA1` — MCU GPIO；同网板载负载和扩展接口见端点

端点数量：3。

- `H2.23`、`U5.24`、`U8.5`

### 6.48 `PA10` — MCU GPIO；同网板载负载和扩展接口见端点

端点数量：3。

- `H3.28`、`U5.69`、`U13.2`

### 6.49 `PA11` — MCU GPIO；同网板载负载和扩展接口见端点

端点数量：4。

- `H3.27`、`U5.70`、`USB2.A7`、`USB2.B7`
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

- `H3.42`、`LED5.1`、`U5.55`

### 6.106 `PD9` — MCU GPIO；同网板载负载和扩展接口见端点

端点数量：2。

- `H3.41`、`U5.56`

### 6.107 `PE0` — MCU GPIO；同网板载负载和扩展接口见端点

端点数量：2。

- `H3.4`、`U5.97`

### 6.108 `PE1` — MCU GPIO；同网板载负载和扩展接口见端点

端点数量：2。

- `H3.3`、`U5.98`

### 6.109 `PE10` — MCU GPIO；同网板载负载和扩展接口见端点

端点数量：2。

- `H2.40`、`U5.41`

### 6.110 `PE11` — MCU GPIO；同网板载负载和扩展接口见端点

端点数量：2。

- `H2.39`、`U5.42`

### 6.111 `PE12` — MCU GPIO；同网板载负载和扩展接口见端点

端点数量：2。

- `H2.42`、`U5.43`

### 6.112 `PE13` — MCU GPIO；同网板载负载和扩展接口见端点

端点数量：5。

- `C25.2`、`H2.41`、`SW2.1`、`SW2.2`、`U5.44`

### 6.113 `PE14` — MCU GPIO；同网板载负载和扩展接口见端点

端点数量：5。

- `C26.2`、`H2.44`、`SW3.1`、`SW3.2`、`U5.45`

### 6.114 `PE15` — MCU GPIO；同网板载负载和扩展接口见端点

端点数量：5。

- `C27.2`、`H2.43`、`SW4.1`、`SW4.2`、`U5.46`

### 6.115 `PE2` — MCU GPIO；同网板载负载和扩展接口见端点

端点数量：2。

- `H2.14`、`U5.1`

### 6.116 `PE3` — MCU GPIO；同网板载负载和扩展接口见端点

端点数量：2。

- `H2.13`、`U5.2`

### 6.117 `PE4` — MCU GPIO；同网板载负载和扩展接口见端点

端点数量：2。

- `H2.16`、`U5.3`

### 6.118 `PE5` — MCU GPIO；同网板载负载和扩展接口见端点

端点数量：2。

- `H2.15`、`U5.4`

### 6.119 `PE6` — MCU GPIO；同网板载负载和扩展接口见端点

端点数量：2。

- `H2.18`、`U5.5`

### 6.120 `PE7` — MCU GPIO；同网板载负载和扩展接口见端点

端点数量：2。

- `H2.35`、`U5.38`

### 6.121 `PE8` — MCU GPIO；同网板载负载和扩展接口见端点

端点数量：2。

- `H2.38`、`U5.39`

### 6.122 `PE9` — MCU GPIO；同网板载负载和扩展接口见端点

端点数量：2。

- `H2.37`、`U5.40`

### 6.123 `RST` — MCU NRST：复位按键、RC、自动下载二极管

端点数量：6。

- `C24.2`、`R10.1`、`SW1.1`、`SW1.2`、`U5.14`、`U14.2`

### 6.124 `RTS` — CH340C RTS# 输出网络（名称未带 #）

端点数量：3。

- `Q1.2`、`R30.1`、`U13.14`

## 7. 完整性校验记录

- PDF 三页抽取到的独立元器件位号集合与 TEL `$PACKAGES` 集合一致：**108/108**。
- 所有 TEL 网络均进入附录：**124/124**。
- 所有 TEL 已连接引脚端点均进入逐器件表且只属于一个已连接网络：**509/509**。
- 补列有物理编号的 PDF 未连接脚：**15 个**；U5 表覆盖 **100 个物理引脚**。
- SW5–SW7 的未用 A/B 触点另外保留说明；由于页面没有给出清晰物理端子编号，不计入509个已连接端点或15个已编号NC脚。
- 全部连接器辅助焊盘、安装孔接地端、电源脚及晶体接地焊盘均已保留，没有只列信号线而省略它们。
- 上述校验是位号/引脚/网络覆盖校验，不是对 PCB 实际连通性、芯片兼容性和物料选型的合格认证。

### 来源文件指纹（便于确认后续修订是否仍对应本版本）

- `SCH_Standard NUEDC DevBoard.pdf` SHA-256：`03e12eee2c91f8d43770a42bf5b46dee30f54751200e430579d8fe5c1c7884bc`。
- `Netlist_Standard NUEDC DevBoard.tel` SHA-256：`dd5247ab8d4544d2532ea557967ff43d2f1dc2b45ade4678948e0ee6f3bcb167`。
