SunBinyuan666/Standard_NUEDC_DevBoard/AI_Development/keil移植出现过的坑/03_Keil2VSCode脚本勘误手册.docx

Keil工程移植到VSCode平台勘误手册

一、说明

手册只适用于keil平台使用脚本keil2cubevscode.ps1 / keil2cubevscode.bat移植到vscode的stm32工程，其他情况谨慎参考。

二、移植脚本提示参考

脚本运行时会输出四种前缀信息：

前缀 | 颜色 | 含义
[OK] | 绿色 | 正常完成，无需处理
[!] | 黄色 | 警告，部分处理
[ERR] | 红色 | 错误，必须处理后重新运行
==> | 紫色 | 步骤分隔，表示进入新阶段
乱码 | 不定 | Keil工程文件被加密

2.1 警告提示

2.1.1 cube-cmake未找到

[!] cube-cmake 未找到 — 请先安装 STM32CubeIDE for VS Code 扩展并运行 Bundle Manager

说明：不重要

处理：确认vscode中的stm32cubeide for vscode是否安装

2.1.2 无法自动识别芯片

[!] 无法自动识别芯片核心，已设为 cortex-m3，请手动确认 cmake/gcc-arm-none-eabi.cmake

说明：脚本推导Cortex核心失败

处理：打开cmake/gcc-arm-none-eabi.cmake，找到 -mcpu=cortex-m3，改为实际的核心号。

芯片型号 | 更改方式
Cortex-M0 | -mcpu=cortex-m0
Cortex-M0+ | -mcpu=cortex-m0plus
Cortex-M4（带 FPU） | -mcpu=cortex-m4 -mfpu=fpv4-sp-d16 -mfloat-abi=hard
Cortex-M7 | -mcpu=cortex-m7 -mfpu=fpv5-d16 -mfloat-abi=hard
没有参考 | 使用cubemx生成基本框架抄一下

2.1.3 无法从.uvprojx读取Flash/RAM大小

[!] 无法从 .uvprojx 读取 Flash/RAM 大小，链接脚本将生成占位值，请手动填写

说明：.uvprojx中没有内存配置节点，脚本生成.ld文件Flash/RAM大小为0，无法正常链接。

处理：打开生成的.ld文件，找到以下两行，按实际芯片填写：

FLASH (rx) : ORIGIN = 0x08000000, LENGTH = 0K /* <-- 改为实际值，如 128K */

RAM (xrw): ORIGIN = 0x20000000, LENGTH = 0K /* <-- 改为实际值，如 20K */

2.1.4 无法自动识别HAL设备宏

[!] 无法自动推导 HAL 设备宏，请在 cmake/stm32cubemx/CMakeLists.txt 中手动填写

说明：缺少HAL库工程需要的编译设备型号宏定义

处理：打开cmake/stm32cubemx/CMakeLists.txt，在 MX_Defines_Syms 中手动添加对应宏。

格式参考：

系列 | 宏
STM32F103xB（128KB Flash） | STM32F103xB
STM32F103xE（512KB Flash） | STM32F103xE
没有参考 | Cubemx生成代码抄一下

2.1.5 未找到GCC启动文件

[!] 未找到 GCC 语法启动文件，请手动填写 cmake/stm32cubemx/CMakeLists.txt 中的 MX_Startup

说明：keil使用的是arm语法汇编，gcc汇编器不支持，需要导入gcc的启动汇编文件

处理：cubemx生成代码找到gcc启动文件拷贝到工程中，并在cmake/stm32cubemx/CMakeLists.txt-> MX_Startup 变量中填写相对路径。

2.1.6 FreeRTOS GCC port不存在

[!] FreeRTOS RVDS port 存在但 GCC port 不存在：<路径>

请从 FreeRTOS-Kernel/portable/GCC/ 下载对应型号的 port.c + portmacro.h

说明：keil工程freertos使用的是rvds移植版，gcc需要gcc移植版

处理：在freertos源码包中找到portable/GCC/ 目录拷贝到工程中，并修改cmake/stm32cubemx/CMakeLists.txt中port.c路径和port.h包含文件路径

2.1.7 core_cm3.c寄存器约束bug

[!] core_cm3.c：检测到 STREX 寄存器约束 Bug，尝试修复...

[OK] core_cm3.c：已修复（=r → =&r）

修复失败时：

[!] core_cm3.c: auto-fix failed. Manually change "=r"(result) to "=&r"(result) in __STREXB and __STREXH

说明：存在自动修复失败可能

操作：自动修复失败时，根据提示修改文件即可

2.1.8 已存在文件

[!] 已存在，跳过：CMakeLists.txt

[!] 已存在，跳过：.vscode/launch.json

说明：已存在文件不会覆盖

操作：如果需要脚本重新生成，把已存在文件全部删除后重新运行脚本。

2.2错误提示

若出现红色提示，根据提示处理后重新运行脚本，只要环境是正常的基本不会报红色错误。

三、移植后手动适配项

以下内容脚本无法自动处理，需人工确认，如果遇到无法处理的可以手动生成代码参考移植：

项目 | 说明
uCOS-II / FreeRTOS 等 RTOS | 确认 `OS_CPU_A.s` 等汇编文件已加入源文件列表；检查启动文件与 RTOS 的 SysTick 冲突
私有 `.lib` / `.a` 静态库 | Keil 的 `.lib` 不可直接链接，需找对应 GCC 版本的 `.a` 或重新编译源码
Keil scatter file（`.sct`） | 需转换为 GCC linker script（`.ld`）；脚本仅复制，不转换
条件编译 `#ifdef __CC_ARM` | 这类代码块在 GCC 下被跳过，需检查等价的 `__GNUC__` 分支是否正确
汇编语法（Keil UAL vs GAS） | Keil 汇编用 PROC/ENDP/AREA 等关键字，GCC 汇编器不支持，需转换

3.1 RTOS适配（uCOS-II/FreeRTOS）

3.1.1 FreeRTOS

l Port.c和port.h文件，参考脚本提示

l SysTick冲突问题，正常在keil编译成功移植到vscode不会有该问题

3.1.2 uCOS-II

l 替换OS_CPU_A.s：Keil版使用ARM汇编语法，需换成GCC汇编版

l 确认OS_CPU_C.c中的OS_TASKStkInit堆栈方向与GCC ABI一致

l os_cfg.h中的OS_TICK_PER_SEC与SysTick配置保持一致

3.2静态库链接（.a/.lib）

Keil的.lib文件是ARM Compiler格式，GCC无法直接链接，需要找厂商拿到.a文件用GCC重新编译。

GCC链接.a文件方式（参考）：

方式1：直接路径链接

target_link_libraries(${CMAKE_PROJECT_NAME} PRIVATE

${CMAKE_SOURCE_DIR}/Libs/libxxx.a

)

方式2：导入库支持STM32cubeide识别：

add_library(xxx STATIC IMPORTED)

set_target_properties(xxx PROPERTIES

IMPORTED_LOCATION ${CMAKE_SOURCE_DIR}/Libs/libxxx.a

)

target_link_libraries(${CMAKE_PROJECT_NAME} PRIVATE xxx)

注意： .a 文件必须是与当前 GCC 版本和 MCU 架构（-mcpu / -mthumb）完全匹配的版本，否则链接时会报 incompatible target 或符号缺失。

3.3 keil .sct转GCC .ld

Keil 使用 .sct ，GCC 使用 .ld ，脚本只生成通用 .ld 模板，不解析 .sct。

若 Keil 工程有自定义内存分区（如多 Flash 分区、CCM RAM），需手动转换：

Keil .sct 片段示例：

LR_IROM1 0x08000000 0x00080000 {

ER_IROM1 0x08000000 0x00080000 { *.o (RESET, +First) *.o (+RO) }

RW_IRAM1 0x20000000 0x00020000 { *.o (+RW +ZI) }

}

对应 GCC .ld 写法：

MEMORY {

FLASH (rx) : ORIGIN = 0x08000000, LENGTH = 512K

RAM (xrw) : ORIGIN = 0x20000000, LENGTH = 128K

}

SECTIONS {

.text : { KEEP(*(.isr_vector)) *(.text*) } > FLASH

.data : { *(.data*) } > RAM AT > FLASH

.bss : { *(.bss*) *(COMMON) } > RAM

}

通常直接使用脚本生成的通用 .ld 即可，只有工程使用了特殊内存区域（如 STM32F4 的 CCM、外部 SRAM）时才需要手动扩展。

3.4 条件编译

Keil预定义 __CC_ARM，GCC 预定义 __GNUC__。移植后 #ifdef __CC_ARM 块会被完全跳过，可能导致功能缺失。

排查方法：

全局搜索 __CC_ARM，逐一确认对应的 #elif __GNUC__ 分支是否存在且正确：

#ifdef __CC_ARM /* Keil ARM Compiler */

__packed typedef struct { ... } MyStruct;

#elif defined(__GNUC__) /* GCC */

typedef struct __attribute__((packed)) { ... } MyStruct;

#endif

若原代码只有 #ifdef __CC_ARM 而无 __GNUC__ 分支，需手动补充 GCC 等价实现。keil_compat.h 已将常用关键字（__packed、__weak 等）做了映射，大多数情况下不需要额外处理。

3.5汇编文件语法转换

Keil UAL 语法 vs GAS 语法对照：

Keil UAL | GCC GAS | 说明
`AREA |.text|, CODE` | `.section .text` | 段声明
`PROC` / `ENDP` | 无等价，直接省略 | 函数开始/结束标记
`EXPORT FuncName` | `.global FuncName` | 导出符号
`IMPORT FuncName` | `.extern FuncName` | 引用外部符号
`DCD 0x12345678` | `.word 0x12345678` | 32 位数据定义
`DCB 0x00` | `.byte 0x00` | 8 位数据定义
`ALIGN 4` | `.align 2` | 对齐（GAS 的参数是 2 的幂次）
`END` | 文件末尾无需此关键字 | 文件结束标记

推荐做法： 不手动转换，直接从 ST 官方 CMSIS 包中找已有 GCC 版本的同功能汇编文件（启动文件、OS 移植文件等均有 GCC 版），替换即可。只有完全自定义的汇编才需要逐行转换。

四、常见错误说明

4.1 STREX 寄存器约束错误（老 CMSIS core_cm3.c）

编译报错现象：

Error: registers may not be the same -- 'strexb r3,r2,[r3]'

Error: registers may not be the same -- 'strexh r3,r2,[r3]'

原因： 旧版 core_cm3.c 中 __STREXB / __STREXH 使用 "=r"(result)，GCC 14.x 要求 early-clobber 约束 "=&r"，否则拒绝将 result 与 addr 分配到同一寄存器。

脚本处理： 自动检测并修复（=r → =&r）。

手动修复： 在 core_cm3.c 中找到 __STREXB 和 __STREXH，将 "=r" (result) 改为 "=&r" (result)。

4.2 汇编文件编译时包含 C 头文件导致汇编器报错

编译报错现象：

arm-none-eabi/include/machine/_default_types.h: Assembler messages:

Error: junk at end of line, first unrecognized character is `,'

原因： keil_compat.h 通过 -include 强制包含，但编译选项未区分语言，导致 .s 文件也被 -include，C 预处理器展开的 <stdint.h> 等内容汇编器无法解析。

脚本处理： CMake 使用 $<$<COMPILE_LANGUAGE:C>:-include keil_compat.h> 仅对 C 文件生效；keil_compat.h 内容同时加 #ifndef __ASSEMBLER__ 双重保护。

手动修复（如未用脚本生成）：

1. cmake/stm32cubemx/CMakeLists.txt 中将 -include keil_compat.h 改为：

$<$<COMPILE_LANGUAGE:C>:-include ${CMAKE_SOURCE_DIR}/keil_compat.h>

$<$<COMPILE_LANGUAGE:CXX>:-include ${CMAKE_SOURCE_DIR}/keil_compat.h>

2. keil_compat.h 顶部加：

#ifndef __ASSEMBLER__

// ... 原有内容 ...

#endif

4.3 CMake 报 add_custom_command TARGET not created in this directory

编译报错现象：

CMake Error at cmake/stm32cubemx/CMakeLists.txt:XX (add_custom_command):

TARGET 'ProjectName' was not created in this directory.

原因： add_custom_command(TARGET ...) 只能引用同一 CMakeLists.txt 中创建的 target。add_executable 在根目录，子目录无法引用。

脚本处理： 生成 HEX/BIN 的 add_custom_command 放在根 CMakeLists.txt 中，子目录 cmake/stm32cubemx/CMakeLists.txt 不再包含此命令。

4.4 调试时报 GDB executable "arm-none-eabi-gdb.exe" was not found

现象： F5 启动调试时 Cortex-Debug 报找不到 GDB。

原因： cortex-debug.armToolchainPath 未配置，且 Bundle Manager 的 GCC 路径不在系统 PATH 中。

正确做法： 使用 ST 扩展原生的 stlinkgdbtarget 调试类型（脚本生成的 launch.json 已包含），无需配置 GDB 路径，扩展内部托管。J-Link 调试仍使用 cortex-debug 类型，需 J-Link 驱动安装后路径自动可用。

4.5 PowerShell 脚本在中文 Windows 下解析失败

现象： 双击 .bat 运行脚本时报 PS 语法错误，或中文乱码。

原因： 1.中文 Windows 默认 GBK 编码，Get-Content 读取 UTF-8 文件时错误识别为 GBK，导致中文字符破坏脚本语法；2.也可能是文件被加密

解决： 在已知keil .uvprojx没加密的情况下，确保 keil2cubevscode.ps1 文件保存为 UTF-8 with BOM + CRLF 换行。可用 VS Code 右下角切换编码和换行符。

4.6 DRM 加密环境下 build 产物被加密

现象： 编译成功但 .elf 无法被 GDB 加载，或调试器报文件损坏。

解决： 将 build 目录指向非加密区域：

# CMake 配置时指定 build 路径到非加密盘

cmake -S . -B C:\build\MyProject -G Ninja -DCMAKE_BUILD_TYPE=Debug

然后在 launch.json 中将 ELF 路径改为对应绝对路径。

4.7链接阶段出现大量 note: ... does not take linker garbage collection into account

现象：

libc_nano.a(libc_a-closer.o): note: the message above does not take linker garbage collection into account

说明： 这是 linker 的提示信息，不是错误。真正的错误在这些 note 行上方，需向上滚动查看第一行 error: 或 undefined reference。

4.8 flash.jlink 使用硬编码绝对路径导致不可移植

现象： 在其他电脑或其他目录打开工程时，J-Link 烧录失败，报文件不存在。

原因： 参考项目（如 IO_P_V1.1）的 flash.jlink 中写的是绝对路径：

loadfile D:\claude_test\IO_P_V1.1\build\ActionControl.hex

正确写法（相对路径，以 workspaceFolder 为工作目录）：

loadfile build/Debug/MyProject.hex

注意： 调用 JLink 时必须保证工作目录是项目根目录。tasks.json 中需设置 "cwd": "${workspaceFolder}"。脚本生成的 flash.jlink 已使用相对路径。

4.9 settings.json 硬编码 J-Link 特定版本路径

现象： 在其他电脑上打开项目时，Cortex-Debug 报 GDB Server 路径不存在，因为 J-Link 版本不同导致路径变化。

原因： 参考项目 .vscode/settings.json 中写的是绝对版本路径：

{

"cortex-debug.JLinkGDBServerPath": "C:/Program Files/SEGGER/JLink_V794/JLinkGDBServerCL.exe"

}

正确做法： 只写可执行文件名，依赖系统 PATH：

{

"cortex-debug.JLinkGDBServerPath": "JLinkGDBServerCL"

}

如果本机 J-Link 不在 PATH，在 .vscode/settings.local.json（已加入 .gitignore，不提交）中覆盖：

{

"cortex-debug.JLinkGDBServerPath": "C:/Program Files/SEGGER/JLink/JLinkGDBServerCL.exe"

}

4.10 itoa 重定义冲突

现象：

error: conflicting types for 'itoa'

或链接时报 multiple definition of 'itoa'。

原因： keil_compat.h 强制包含 <stdlib.h>，而部分 Keil 工程自己定义了 itoa，或 newlib 的 stdlib.h 已提供 itoa 声明，导致重定义冲突。

脚本处理： 新版 keil_compat.h 用临时宏规避：

#define itoa __newlib_itoa

#include <stdlib.h>

#undef itoa

手动修复（旧版移植工程）： 在 keil_compat.h 的 #include <stdlib.h> 前后加上上述两行。

4.11旧版 tasks.json 直接调用 cmake，Bundle Manager 环境下失效

现象： Ctrl+Shift+B 触发 CMake: Configure 或 CMake: Build 任务时报：

'cmake' 不是内部或外部命令

原因： 旧版脚本生成的 tasks.json 直接调用 cmake 命令（"command": "cmake"）。新环境只依赖 ST 扩展的 Bundle Manager，cmake 在 Bundle Manager 内部路径中，不在系统 PATH。

正确做法（新版脚本已修复）： tasks.json 使用 CMake Tools 扩展的 task 类型，配合 CMakePresets.json 触发构建，cmake 路径通过 settings.json 的 "cmake.cmakePath": "cube-cmake" 代理。

旧工程临时解决： 在系统 PATH 中手动添加 Bundle Manager 的 cmake 路径（路径类似 C:\Users\<user>\AppData\Local\stm32cube\bundles\...），或升级为新版移植脚本重新生成。

4.12旧版 CMakePresets.json 使用 cmake/toolchain.cmake，跨电脑可移植性差

现象： 在没有 cmake/toolchain.cmake 的机器上配置失败，或工具链路径写死导致换电脑后编译器找不到。

原因： 旧版脚本生成的 CMakePresets.json 为：

"toolchainFile": "${sourceDir}/cmake/toolchain.cmake"

toolchain.cmake 内部自动扫描 arm-none-eabi-gcc 的路径——这要求编译器在系统 PATH 中，Bundle Manager 仅有环境下无法满足。

新版脚本做法： CMakePresets.json 通过 "cmake.cmakePath": "cube-cmake"（在 settings.json）让 ST 扩展代理整个工具链发现过程，不再依赖 toolchain.cmake 和系统 PATH。

旧工程升级方式： 删除 .vscode/tasks.json、.vscode/settings.json、CMakePresets.json，用新版脚本重新生成（脚本会跳过已存在的文件，删除后才会重建）。

五、Flash 烧录说明

5.1 ST-Link 烧录（无需额外工具）

通过调试会话烧录：F5 启动调试，ST 扩展自动完成 flash + 启动 GDB。

目前 ST 扩展无独立的"仅烧录"任务入口，烧录与调试绑定。

5.2 J-Link 烧录（独立烧录）

JLink -CommandFile flash.jlink # 增量烧录

JLink -CommandFile flash_full.jlink # 全擦 + 烧录

或在 VS Code tasks.json 中添加 J-Link Flash 任务触发。
