SunBinyuan666/Standard_NUEDC_DevBoard/PCB工程文件/BOM_Standard NUEDC DevBoard_PCB1_2026-10-09.xlsx

No. | Quantity | Comment | Designator | Footprint | Value | Manufacturer Part | Manufacturer | Supplier Part | Supplier | LCSC Stock | LCSC Price | JLCPCB Stock
1 | 1 | CR1220-2ZX | BT1 | BAT-SMD_CR1220-2ZX |  | CR1220-2ZX | QIJEY | C969906 | LCSC | 10176 | 1.7154 | 57181
2 | 2 | 4.7uF | C1,C2 | CAP-SMD_BD4.0-L4.3-W4.3-LS5.0-FD | 4.7uF | VT50V4R7M4X5 | JIERR(捷而瑞) | C48970985 | LCSC | 4212 | 0.2105 | 35433
3 | 3 | 10nF | C3,C4,C7 | C0603 | 10nF | FCC0603B103K500CT | FOJAN(富捷) | C5137477 | LCSC | 50256 | 0.0435 | 5095923
4 | 2 | 47uF | C5,C6 | CAP-SMD_BD6.3-L6.6-W6.6-LS7.3-FD | 47uF | RV63V47M6X8 | JIERR(捷而瑞) | C48971005 | LCSC | 37775 | 0.3362 | 380428
5 | 3 | 10uF | C8,C10,C19 | C0603 | 10uF | CGA0603X5R106K100JT | HRE(芯声) | C6119842 | LCSC | 22746 | 0.1327 | 486867
6 | 13 | 100nF | C9,C11,C13,C14,C15,C16,C17,C18,C24,C25,C26,C27,C28 | C0603 | 100nF | CC0603KRX7R9BB104 | YAGEO(国巨) | C14663 | LCSC | 80 | 0.0857 | 59868075
7 | 1 | 100nF | C12 | C0603 | 100nF | FCC0603B104K500CT | FOJAN(富捷) | C5137636 | LCSC | 15380 | 0.0388 | 2303665
8 | 2 | 20pF | C20,C21 | C0603 | 20pF | CL10C200JB8NNNC | SAMSUNG(三星) | C1648 | LCSC | 12738 | 0.0559 | 2183804
9 | 2 | 10pF | C22,C23 | C0603 | 10pF | CL10C100JB8NNNC | SAMSUNG(三星) | C1634 | LCSC | 0 | 0.0461 | 1155645
10 | 1 | MX103-5.0-02P-GN01-Cu-Y-A | CN1 | CONN-TH_2P-P5.00_MX103-5.0-02P |  | MX103-5.0-02P-GN01-Cu-Y-A | MAX(迈旭) | C5188482 | LCSC | 546 | 0.8448 | 2759
11 | 2 | SS54 | D1,D2 | SMA_L4.4-W2.8-LS5.4-R-RD |  | SS54 | MDD(辰达半导体) | C22452 | LCSC | 199428 | 0.2719 | 2334159
12 | 1 | BAT54C | D3 | SOT-23-3_L2.9-W1.3-P1.90-LS2.8-BR |  | BAT54C | R+O(宏嘉诚) | C22466350 | LCSC | 12108 | 0.1017 | 736523
13 | 1 | DC005-2.5 | DC1 | DC-IN-TH_DC005-2.5MM |  | DC005-2.5 | SHOU HAN(首韩) | C7507454 | LCSC | 6063 | 0.4172 | 60800
14 | 1 | HX PZ2.54-2x3P ZZ | H1 | HDR-TH_6P-P2.54-V-M-R2-C3-S2.54-2 |  | HX PZ2.54-2x3P ZZ | hanxia(韩下) | C32713276 | LCSC | 4448 | 0.2842 | 45395
15 | 2 | X6521WV-2x23H-C60D30 | H2,H3 | HDR-TH_46P-2.54-V-M-R2-C23-S2.54 |  | X6521WV-2x23H-C60D30 | XKB Connection(中国星坤) | C725895 | LCSC | 29 | 7.25 | 25
16 | 1 | PZ254V-11-04P | H4 | HDR-TH_4P-P2.54-V-M |  | PZ254V-11-04P | XFCN(兴飞) | C492403 | LCSC | 2962 | 0.1734 | 60584
17 | 1 | 15uH | L1 | IND-SMD_L7.3-W6.8 | 15uH | MWSA0603S-150MT | Sunlord(顺络) | C408452 | LCSC | 8933 | 0.7593 | 52501
18 | 2 | GL0603UG01 | LED1,LED2 | LED0603-RD |  | GL0603UG01 | Guiguang light(桂光光电) | C51933293 | LCSC | 22629 | 0.0252 | 2605313
19 | 3 | GL0603UB01 | LED3,LED4,LED5 | LED0603-RD_BLUE |  | GL0603UB01 | Guiguang light(桂光光电) | C51933294 | LCSC | 19805 | 0.0209 | 2014072
20 | 3 | ZX-XH2.54-4PLT | P1,P2,P3 | CONN-SMD_4P-P2.54_C9900012758 |  | ZX-XH2.54-4PLT | Megastar(兆星) | C7429682 | LCSC | 13646 | 0.5375 | 71690
21 | 4 | 6GHz | PA0,PA1,PA4,PA5 | SMA-TH_HL-SMA-KHD2 | 6GHz | HL-SMA-KE-02 | HenryTech(恒利泰) | C20617215 | LCSC | 20495 | 2.2 | 21358
22 | 1 | S8050 J3Y(RANGE:200-350) | Q1 | SOT-23-3_L3.0-W1.7-P0.95-LS2.9-BR |  | S8050 J3Y(RANGE:200-350) | CJ(江苏长电/长晶) | C2146 | LCSC | 17966 | 0.0904 | 1373199
23 | 1 | S8550(RANGE:120-200) | Q2 | SOT-23-3_L2.9-W1.6-P1.90-LS2.8-BR |  | S8550(RANGE:120-200) | CJ(江苏长电/长晶) | C105432 | LCSC | 3128 | 0.102 | 257135
24 | 4 | 5.1kΩ | R1,R2,R13,R14 | R0603 | 5.1kΩ | 0603WAF5101T5E | UNI-ROYAL(厚声) | C23186 | LCSC | 200727 | 0.0091 | 24964292
25 | 6 | 10kΩ | R3,R10,R11,R12,R15,R27 | R0603 | 10kΩ | FRC0603F1002TS | FOJAN(富捷) | C2906982 | LCSC | 24775 | 0.0167 | 5526485
26 | 1 | 3.16kΩ | R4 | R0603 | 3.16kΩ | RMC06033.16K1%N | Tyohm(幸亚电阻) | C325684 | LCSC | 86 | 0.0245 | 8783
27 | 4 | 2kΩ | R5,R16,R17,R18 | R0603 | 2kΩ | 0603WAF2001T5E | UNI-ROYAL(厚声) | C22975 | LCSC | 78136 | 0.0145 | 13210545
28 | 1 | 5kΩ | R6 | R0603 | 5kΩ | RT0603BRE075KL | YAGEO(国巨) | C862232 | LCSC | 6270 | 0.1595 | 209936
29 | 2 | 0Ω | R7,R8 | R0603 | 0Ω | 0603WAF0000T5E | UNI-ROYAL(厚声) | C21189 | LCSC | 143112 | 0.0137 | 23213454
30 | 4 | 1kΩ | R9,R28,R29,R30 | R0603 | 1kΩ | FRC0603F1001TS | FOJAN(富捷) | C2907002 | LCSC | 98882 | 0.0146 | 11781804
31 | 8 | 4.7kΩ | R19,R20,R21,R22,R23,R24,R25,R26 | R0603 | 4.7kΩ | 0603WAF4701T5E | UNI-ROYAL(厚声) | C23162 | LCSC | 97869 | 0.0169 | 21643797
32 | 4 | M3螺丝 | SCREW1,SCREW2,SCREW3,SCREW4 | M3螺丝
33 | 4 | KH-6X6X5H-STM | SW1,SW2,SW3,SW4 | SW-SMD_4P-L6.0-W6.0-P4.50-LS9.0_H5.0 |  | KH-6X6X5H-STM | kinghelm(金航标) | C2837531 | LCSC | 8826 | 0.1153 | 517744
34 | 3 | MST23D18G2 125 | SW5,SW6,SW7 | SW-SMD_SHOU_MST23D18G2 |  | MST23D18G2 125 | SHOU HAN(首韩) | C2906281 | LCSC | 2108 | 0.4178 | 10558
35 | 1 | TPS5450QDDARQ1 | U1 | SOIC-8_L4.9-W3.9-P1.27-LS6.0-BL-EP |  | TPS5450QDDARQ1 | TI(德州仪器) | C181270 | LCSC | 1224 | 22.47 | 1242
36 | 1 | YSSP2AG00 | U2 | SW-SMD_YSSP2AG00 |  | YSSP2AG00 | YIYUAN(怡远) | C5188558 | LCSC | 296 | 0.435 | 2960
37 | 1 | JK-nSMD005/60V | U3 | F1206 |  | JK-nSMD005/60V | JK(金科) | C2830235 | LCSC | 22168 | 0.1668 | 451375
38 | 1 | AMS1117-3.3 | U4 | SOT-223-3_L6.5-W3.4-P2.30-LS7.0-BR |  | AMS1117-3.3 | Advanced Monolithic Systems | C6186 | LCSC | 168407 | 1.2772 | 1305927
39 | 1 | STM32F103VET6 | U5 | LQFP-100_L14.0-W14.0-P0.50-LS16.0-BL |  | STM32F103VET6 | ST(意法半导体) | C8308 | LCSC | 3254 | 26.27 | 3650
40 | 1 | TL431QDBZR | U6 | SOT-23-3_L2.9-W1.6-P1.90-LS2.8-BR |  | TL431QDBZR | TI(德州仪器) | C316457 | LCSC | 14932 | 0.6517 | 75080
41 | 2 | HX 2.54-6P WT | U11,U12 | CONN-SMD_6P-P2.50_HANXIA_HX-2.54-6P-WT |  | HX 2.54-6P WT | hanxia(韩下) | C5142102 | LCSC | 8153 | 0.5769 | 40938
42 | 1 | CH340C | U13 | SOP-16_L10.0-W3.9-P1.27-LS6.0-BL |  | CH340C | WCH(南京沁恒) | C84681 | LCSC | 136950 | 3.72 | 138947
43 | 1 | 1N4007W | U14 | SOD-123FL_L2.7-W1.8-LS3.7-RD |  | 1N4007W | MSKSEMI(美森科) | C7528871 | LCSC | 13502 | 0.0379 | 1368936
44 | 2 | HC-TYPE-C-16P-01B | USART,USB | USB-C-SMD_KH-TYPE-C-16P |  | HC-TYPE-C-16P-01B | HCTL(华灿天禄) | C2894898 | LCSC | 2923 | 0.8938 | 14994
45 | 1 | 8MHz | X1 | CRYSTAL-SMD_4P-L3.2-W2.5-BL_SIT8008BI | 8MHz | XL2EL89CSI-111YLC-8M | YXC(扬兴晶振) | C5444548 | LCSC | 6987 | 1.0094 | 34976
46 | 1 | 32.768kHz | X2 | OSC-SMD_L3.2-W1.5 | 32.768kHz | SF32WK32768D31T002 | TKD(泰晶) | C271654 | LCSC | 5878 | 1.0406 | 92194
