SunBinyuan666/Standard_NUEDC_DevBoard/PCB工程文件/PCB_Standard NUEDC DevBoard.pdf

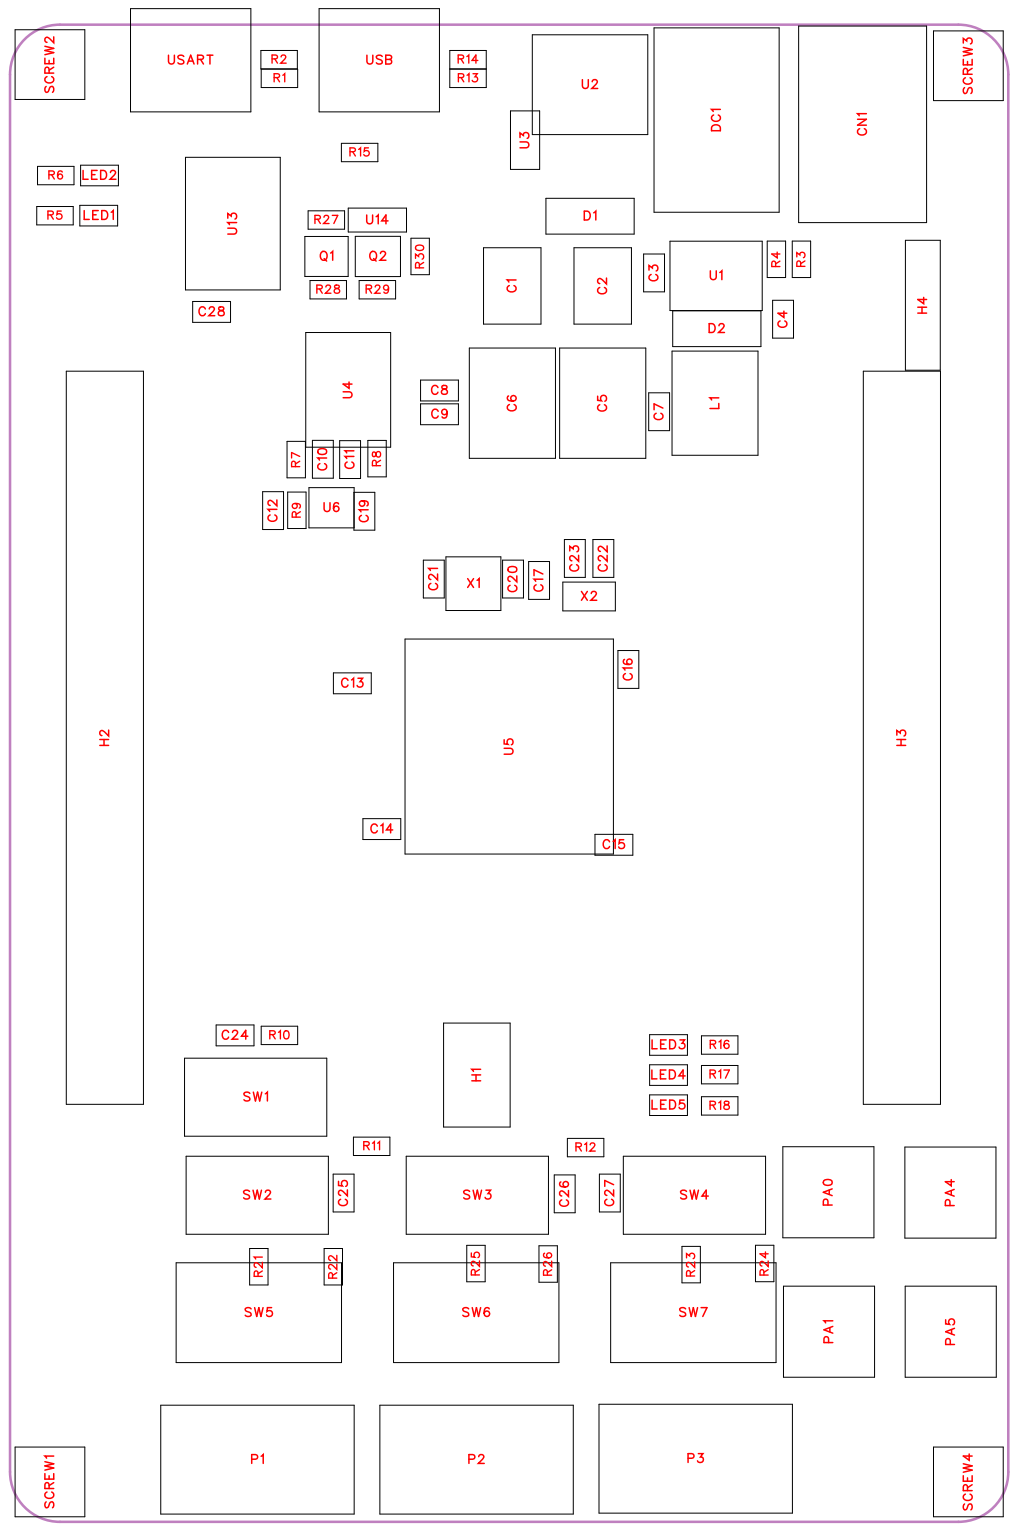
[picture p8: page 1]

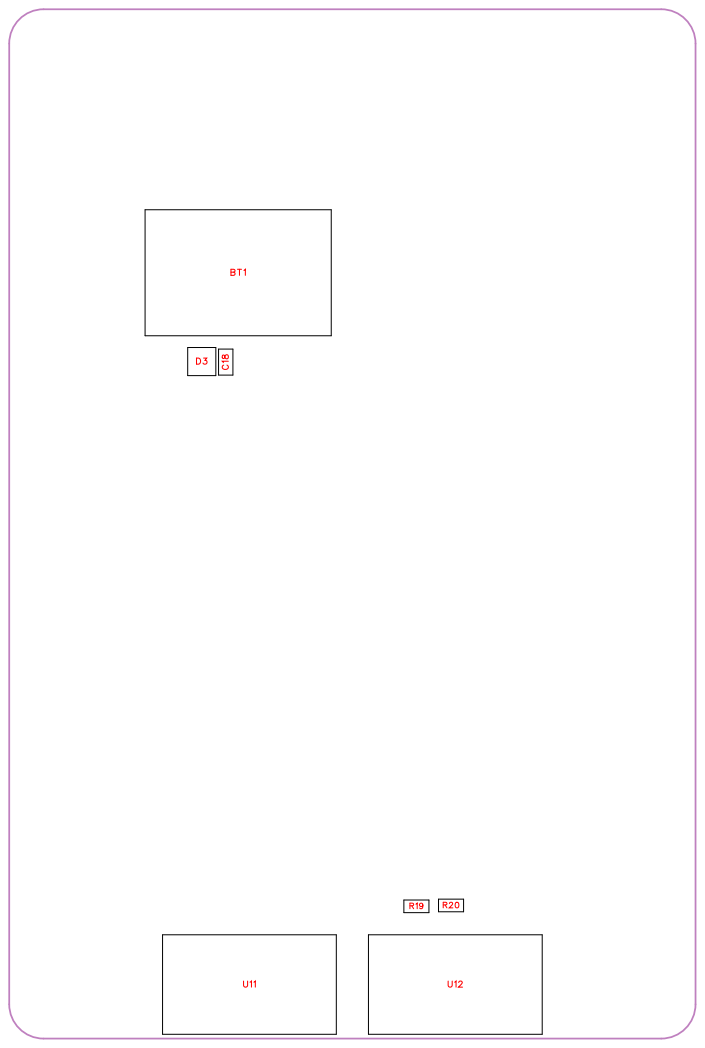
[picture p9: page 2]

No. | Quantity | Comment | Designator | Footprint | Value | Manufacturer Part | Manufacturer | Supplier Part | Supplier
1 | 1 | CR1220-2ZX | BT1 | BAT-SMD_C R1220-2ZX | | CR1220-2ZX | QIJEY | C969906 | LCSC
2 | 2 | 4.7uF | C1,C2 | CAP-SMD_B D4.0-L4.3-W 4.3-LS5.0-FD | 4.7uF | VT50V4R7M 4X5 | JIERR(捷而 瑞) | C48970985 | LCSC
3 | 3 | 10nF | C3,C4,C7 | C0603 | 10nF | FCC0603B10 3K500CT | FOJAN(富捷) | C5137477 | LCSC
4 | 2 | 47uF | C5,C6 | CAP-SMD_B D6.3-L6.6-W 6.6-LS7.3-FD | 47uF | RV63V47M6 X8 | JIERR(捷而 瑞) | C48971005 | LCSC
5 | 3 | 10uF | C8,C10,C19 | C0603 | 10uF | CGA0603X5 R106K100JT | HRE(芯声) | C6119842 | LCSC
6 | 13 | 100nF | C9,C11,C13,C14,C15,C16, C17,C18,C24,C25,C26,C27 ,C28 | C0603 | 100nF | CC0603KRX 7R9BB104 | YAGEO(国巨 ) | C14663 | LCSC
7 | 1 | 100nF | C12 | C0603 | 100nF | FCC0603B10 4K500CT | FOJAN(富捷) | C5137636 | LCSC
8 | 2 | 20pF | C20,C21 | C0603 | 20pF | CL10C200JB 8NNNC | SAMSUNG( 三星) | C1648 | LCSC
9 | 2 | 10pF | C22,C23 | C0603 | 10pF | CL10C100JB 8NNNC | SAMSUNG( 三星) | C1634 | LCSC
10 | 1 | MX103-5.0-0 2P-GN01-Cu -Y-A | CN1 | CONN-TH_2 P-P5.00_MX 103-5.0-02P | | MX103-5.0-0 2P-GN01-Cu -Y-A | MAX(迈旭) | C5188482 | LCSC
11 | 2 | SS54 | D1,D2 | SMA_L4.4-W 2.8-LS5.4-R-RD | | SS54 | MDD(辰达半 导体) | C22452 | LCSC
12 | 1 | BAT54C | D3 | SOT-23-3_L2 .9-W1.3-P1.9 0-LS2.8-BR | | BAT54C | R+O(宏嘉诚) | C22466350 | LCSC
13 | 1 | DC005-2.5 | DC1 | DC-IN-TH_D C005-2.5MM | | DC005-2.5 | SHOU HAN(首韩) | C7507454 | LCSC
14 | 1 | HX PZ2.54-2x3P ZZ | H1 | HDR-TH_6P-P2.54-V-M-R 2-C3-S2.54-2 | | HX PZ2.54-2x3P ZZ | hanxia(韩下) | C32713276 | LCSC
15 | 2 | X6521WV-2x 23H-C60D30 | H2,H3 | HDR-TH_46 P-2.54-V-M-R2-C23-S2.5 4 | | X6521WV-2x 23H-C60D30 | XKB Connect ion(中国星坤) | C725895 | LCSC
16 | 1 | PZ254V-11-0 4P | H4 | HDR-TH_4P-P2.54-V-M | | PZ254V-11-0 4P | XFCN(兴飞) | C492403 | LCSC
17 | 1 | 15uH | L1 | IND-SMD_L7 .3-W6.8 | 15uH | MWSA0603S -150MT | Sunlord(顺络 ) | C408452 | LCSC
18 | 2 | GL0603UG0 1 | LED1,LED2 | LED0603-RD | | GL0603UG0 1 | Guiguang lig ht(桂光光电) | C51933293 | LCSC
19 | 3 | GL0603UB01 | LED3,LED4,LED5 | LED0603-RD _BLUE | | GL0603UB01 | Guiguang lig ht(桂光光电) | C51933294 | LCSC

20 | 3 | ZX-XH2.54-4 PLT | P1,P2,P3 | CONN-SMD_ 4P-P2.54_C9 900012758 | | ZX-XH2.54-4 PLT | Megastar( 兆 星 ) | C7429682 | LCSC
21 | 4 | 6GHz | PA0,PA1,PA4,PA5 | SMA-TH_HL-SMA-KHD2 | 6GHz | HL-SMA-KE-02 | HenryTech( 恒利泰 ) | C20617215 | LCSC
22 | 1 | S8050 J3Y(R ANGE:200-3 50) | Q1 | SOT-23-3_L3 .0-W1.7-P0.9 5-LS2.9-BR | | S8050 J3Y(R ANGE:200-3 50) | CJ(江苏长电 / ) 长晶 | C2146 | LCSC
23 | 1 | S8550(RAN GE:120-200) | Q2 | SOT-23-3_L2 .9-W1.6-P1.9 0-LS2.8-BR | | S8550(RAN GE:120-200) | CJ(江苏长电 / ) 长晶 | C105432 | LCSC
24 | 4 | 5.1k | R1,R2,R13,R14 | R0603 | 5.1k | 0603WAF51 01T5E | UNI-ROYAL( ) 厚声 | C23186 | LCSC
25 | 6 | 10k | R3,R10,R11,R12,R15,R27 | R0603 | 10k | FRC0603F10 02TS | FOJAN(富捷 ) | C2906982 | LCSC
26 | 1 | 3.16k | R4 | R0603 | 3.16k | RMC06033.1 6K1%N | Tyohm(幸亚 电阻 ) | C325684 | LCSC
27 | 4 | 2k | R5,R16,R17,R18 | R0603 | 2k | 0603WAF20 01T5E | UNI-ROYAL( 厚声 ) | C22975 | LCSC
28 | 1 | 5k | R6 | R0603 | 5k | RT0603BRE 075KL | YAGEO(国巨 ) | C862232 | LCSC
29 | 2 | 0 | R7,R8 | R0603 | 0 | 0603WAF00 00T5E | UNI-ROYAL( ) 厚声 | C21189 | LCSC
30 | 4 | 1k | R9,R28,R29,R30 | R0603 | 1k | FRC0603F10 01TS | FOJAN(富捷 ) | C2907002 | LCSC
31 | 8 | 4.7k | R19,R20,R21,R22,R23,R24 ,R25,R26 | R0603 | 4.7k | 0603WAF47 01T5E | UNI-ROYAL( 厚声 ) | C23162 | LCSC
32 | 4 | M3螺丝 | SCREW1,SCREW2,SCRE W3,SCREW4 | M3螺丝
33 | 4 | KH-6X6X5H-STM | SW1,SW2,SW3,SW4 | SW-SMD_4P -L6.0-W6.0-P 4.50-LS9.0_ H5.0 | | KH-6X6X5H-STM | kinghelm( 金 ) 航标 | C2837531 | LCSC
34 | 3 | MST23D18G 2 125 | SW5,SW6,SW7 | SW-SMD_S HOU_MST23 D18G2 | | MST23D18G 2 125 | SHOU HAN(首韩 ) | C2906281 | LCSC
35 | 1 | TPS5450QD DARQ1 | U1 | SOIC-8_L4.9 -W3.9-P1.27-LS6.0-BL-EP | | TPS5450QD DARQ1 | TI(德州仪器 ) | C181270 | LCSC
36 | 1 | YSSP2AG00 | U2 | SW-SMD_YS SP2AG00 | | YSSP2AG00 | YIYUAN(怡远 ) | C5188558 | LCSC
37 | 1 | JK-nSMD005 /60V | U3 | F1206 | | JK-nSMD005 /60V | JK(金科 ) | C2830235 | LCSC
38 | 1 | AMS1117-3. 3 | U4 | SOT-223-3_L 6.5-W3.4-P2. 30-LS7.0-BR | | AMS1117-3. 3 | Advanced Monolithic Systems | C6186 | LCSC
39 | 1 | STM32F103 VET6 | U5 | LQFP-100_L 14.0-W14.0-P0.50-LS16. 0-BL | | STM32F103 VET6 | ST(意法半导 体) | C8308 | LCSC

40 | 1 | TL431QDBZ R | U6 | SOT-23-3_L2 .9-W1.6-P1.9 0-LS2.8-BR | | TL431QDBZ R | TI(德州仪器 ) | C316457 | LCSC
41 | 2 | HX 2.54-6P WT | U11,U12 | CONN-SMD_ 6P-P2.50_H ANXIA_HX-2 .54-6P-WT | | HX 2.54-6P WT | hanxia(韩下 ) | C5142102 | LCSC
42 | 1 | CH340C | U13 | SOP-16_L10. 0-W3.9-P1.2 7-LS6.0-BL | | CH340C | WCH(南京沁 恒) | C84681 | LCSC
43 | 1 | 1N4007W | U14 | SOD-123FL_ L2.7-W1.8-L S3.7-RD | | 1N4007W | MSKSEMI( 美 森科 ) | C7528871 | LCSC
44 | 2 | HC-TYPE-C-16P-01B | USART,USB | USB-C-SMD _KH-TYPE-C -16P | | HC-TYPE-C-16P-01B | HCTL(华灿天 禄) | C2894898 | LCSC
45 | 1 | 8MHz | X1 | CRYSTAL-S MD_4P-L3.2-W2.5-BL_SIT 8008BI | 8MHz | XL2EL89CSI -111YLC-8M | YXC(扬兴晶 振) | C5444548 | LCSC
46 | 1 | 32.768kHz | X2 | OSC-SMD_L 3.2-W1.5 | 32.768kHz | SF32WK327 68D31T002 | TKD(泰晶 ) | C271654 | LCSC

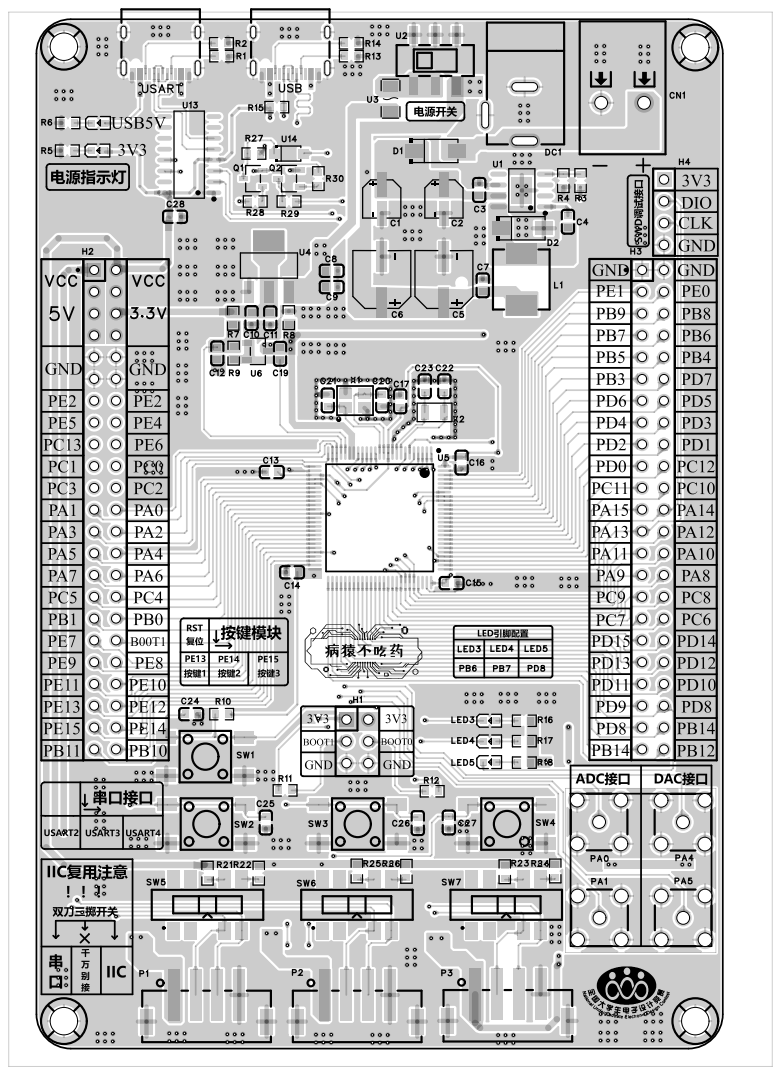
[picture p10: page 6]

PC3 | PC2 | | PC10
PA1 | | | PA14

串口接口 | ADC接口 | DAC接口

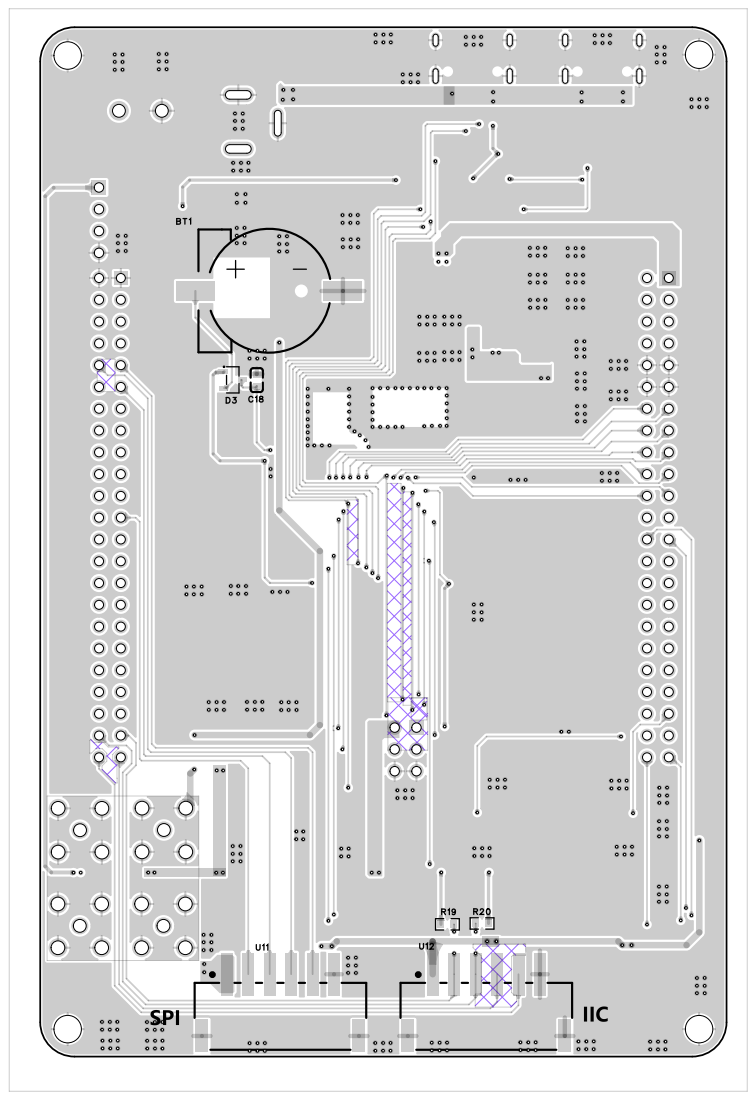
[picture p11: page 7]

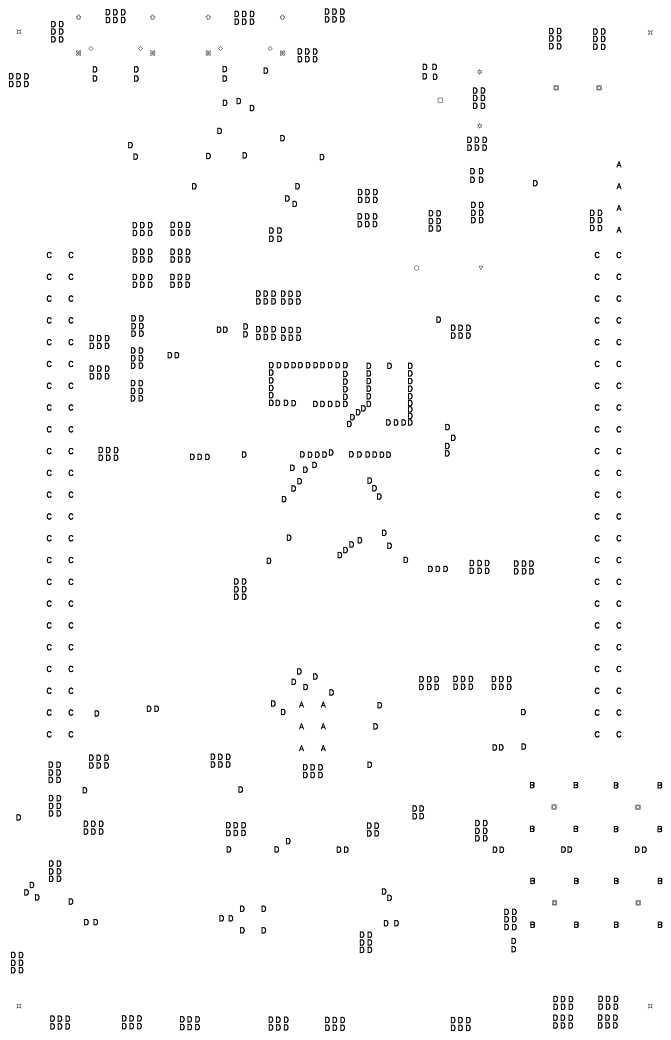
[picture p12: page 8]
