SunBinyuan666/Standard_NUEDC_DevBoard/原理图/SCH_Standard NUEDC DevBoard.pdf

# BOOT电路

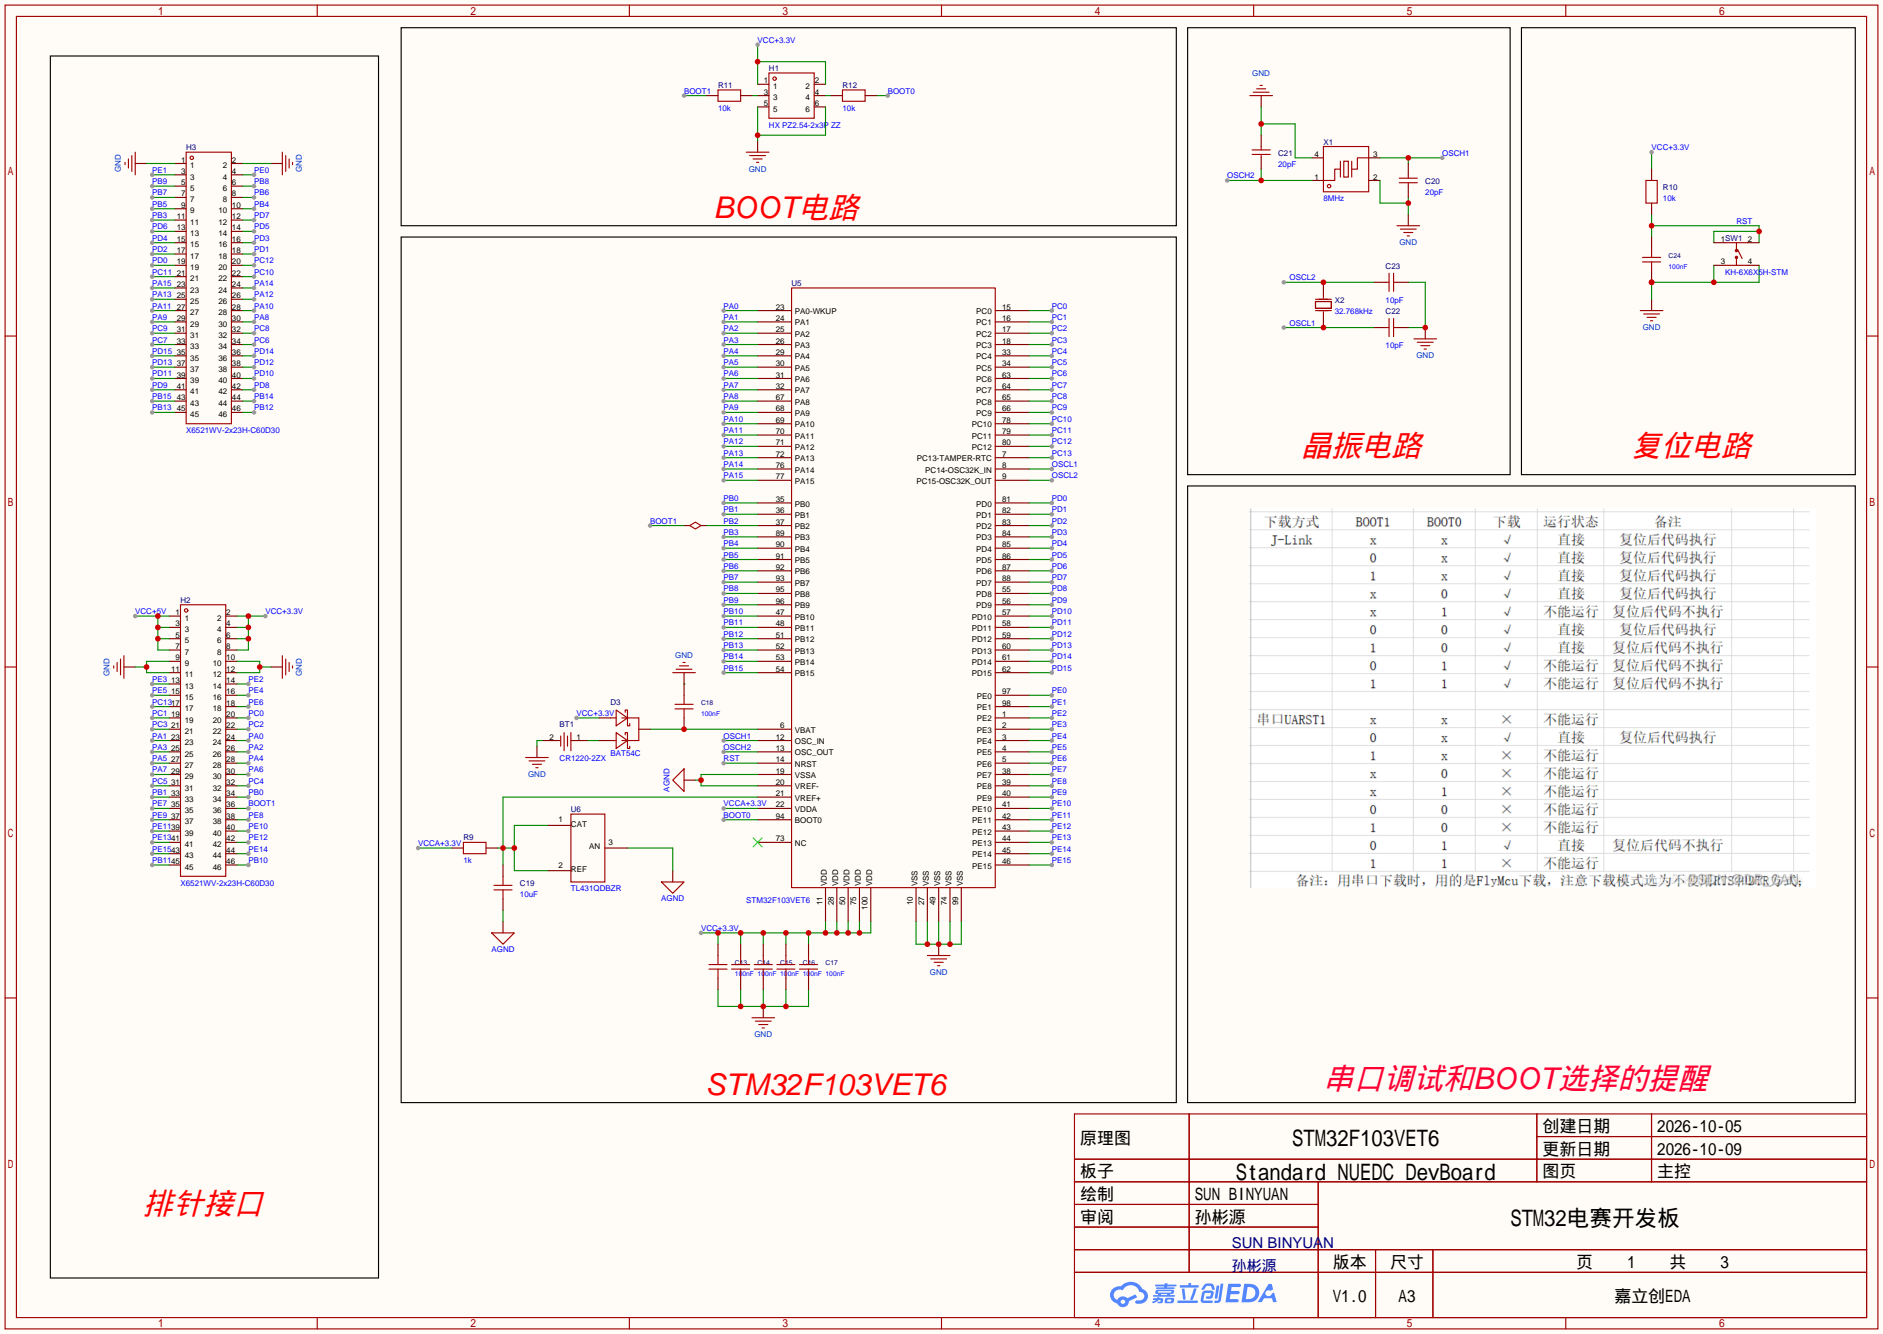
[picture p13: page 1]

原理图 | STM32F103VET6 | 创建日期 | 2026-10-05
板子 | Standard NUEDC DevBoard | 图页 | 主控
绘制 | SUN BINYUAN | STM32电赛开发板
审阅 | 孙彬源

更新日期 | 2026-10-09

SUN BINYUAN
孙彬源 | 版本 | 尺寸 | 页 1 共 3

V1.0 | A3 | 嘉立创EDA

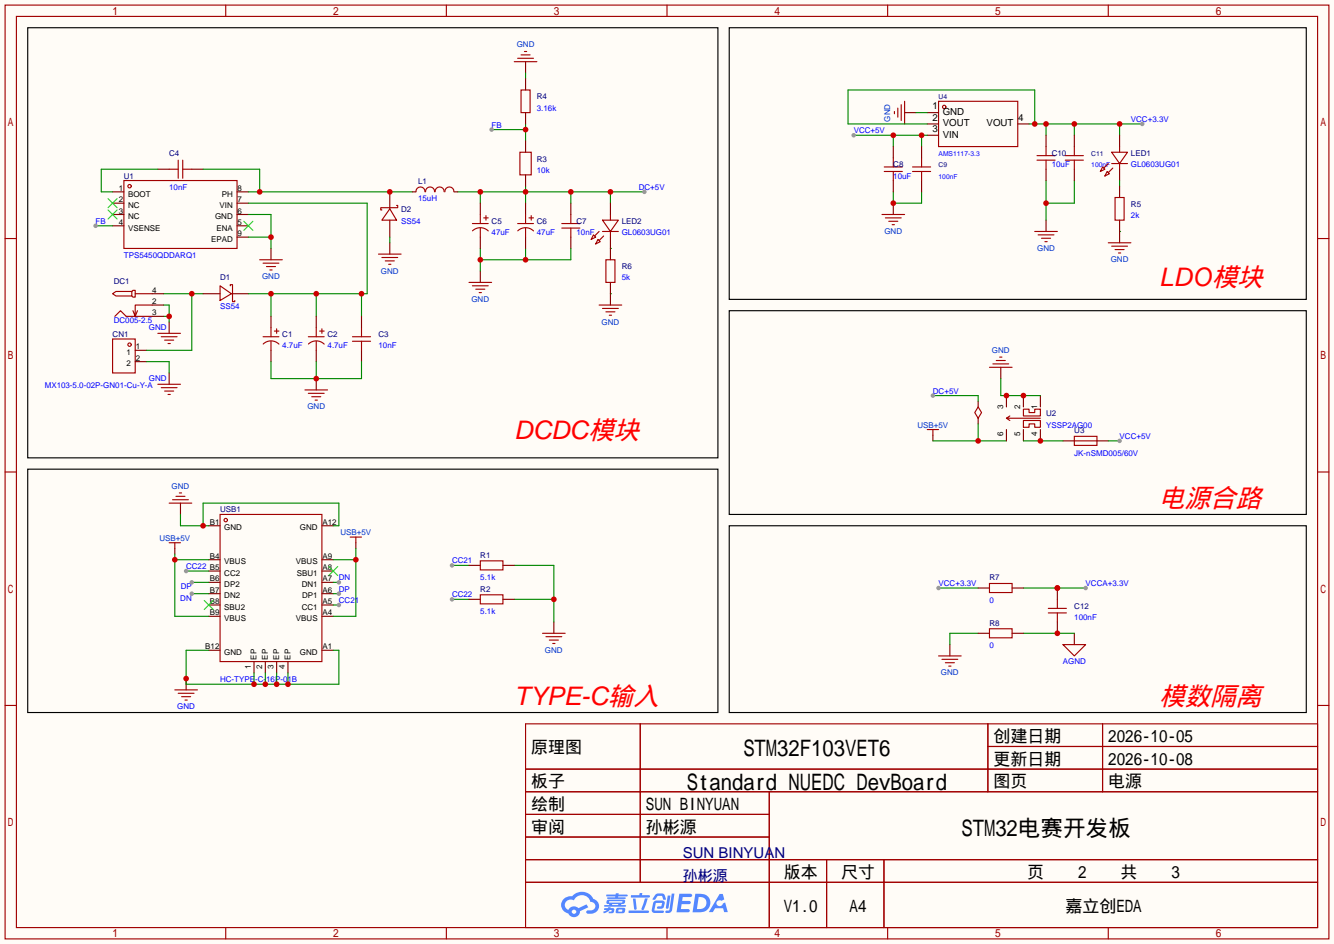
[picture p14: page 2]

原理图 | STM32F103VET6 | 创建日期 | 2026-10-05
板子 | Standard NUEDC DevBoard | 图页 | 电源
绘制 | SUN BINYUAN | STM32电赛开发板
审阅 | 孙彬源

更新日期 | 2026-10-08

SUN BINYUAN

V1.0 | A4 | 嘉立创EDA

# VBUS B9 SBU2 B8 DN2 B7 DP2 B6 CC2 B5 VBUS B4

串口自动下载 | ADC接口电路

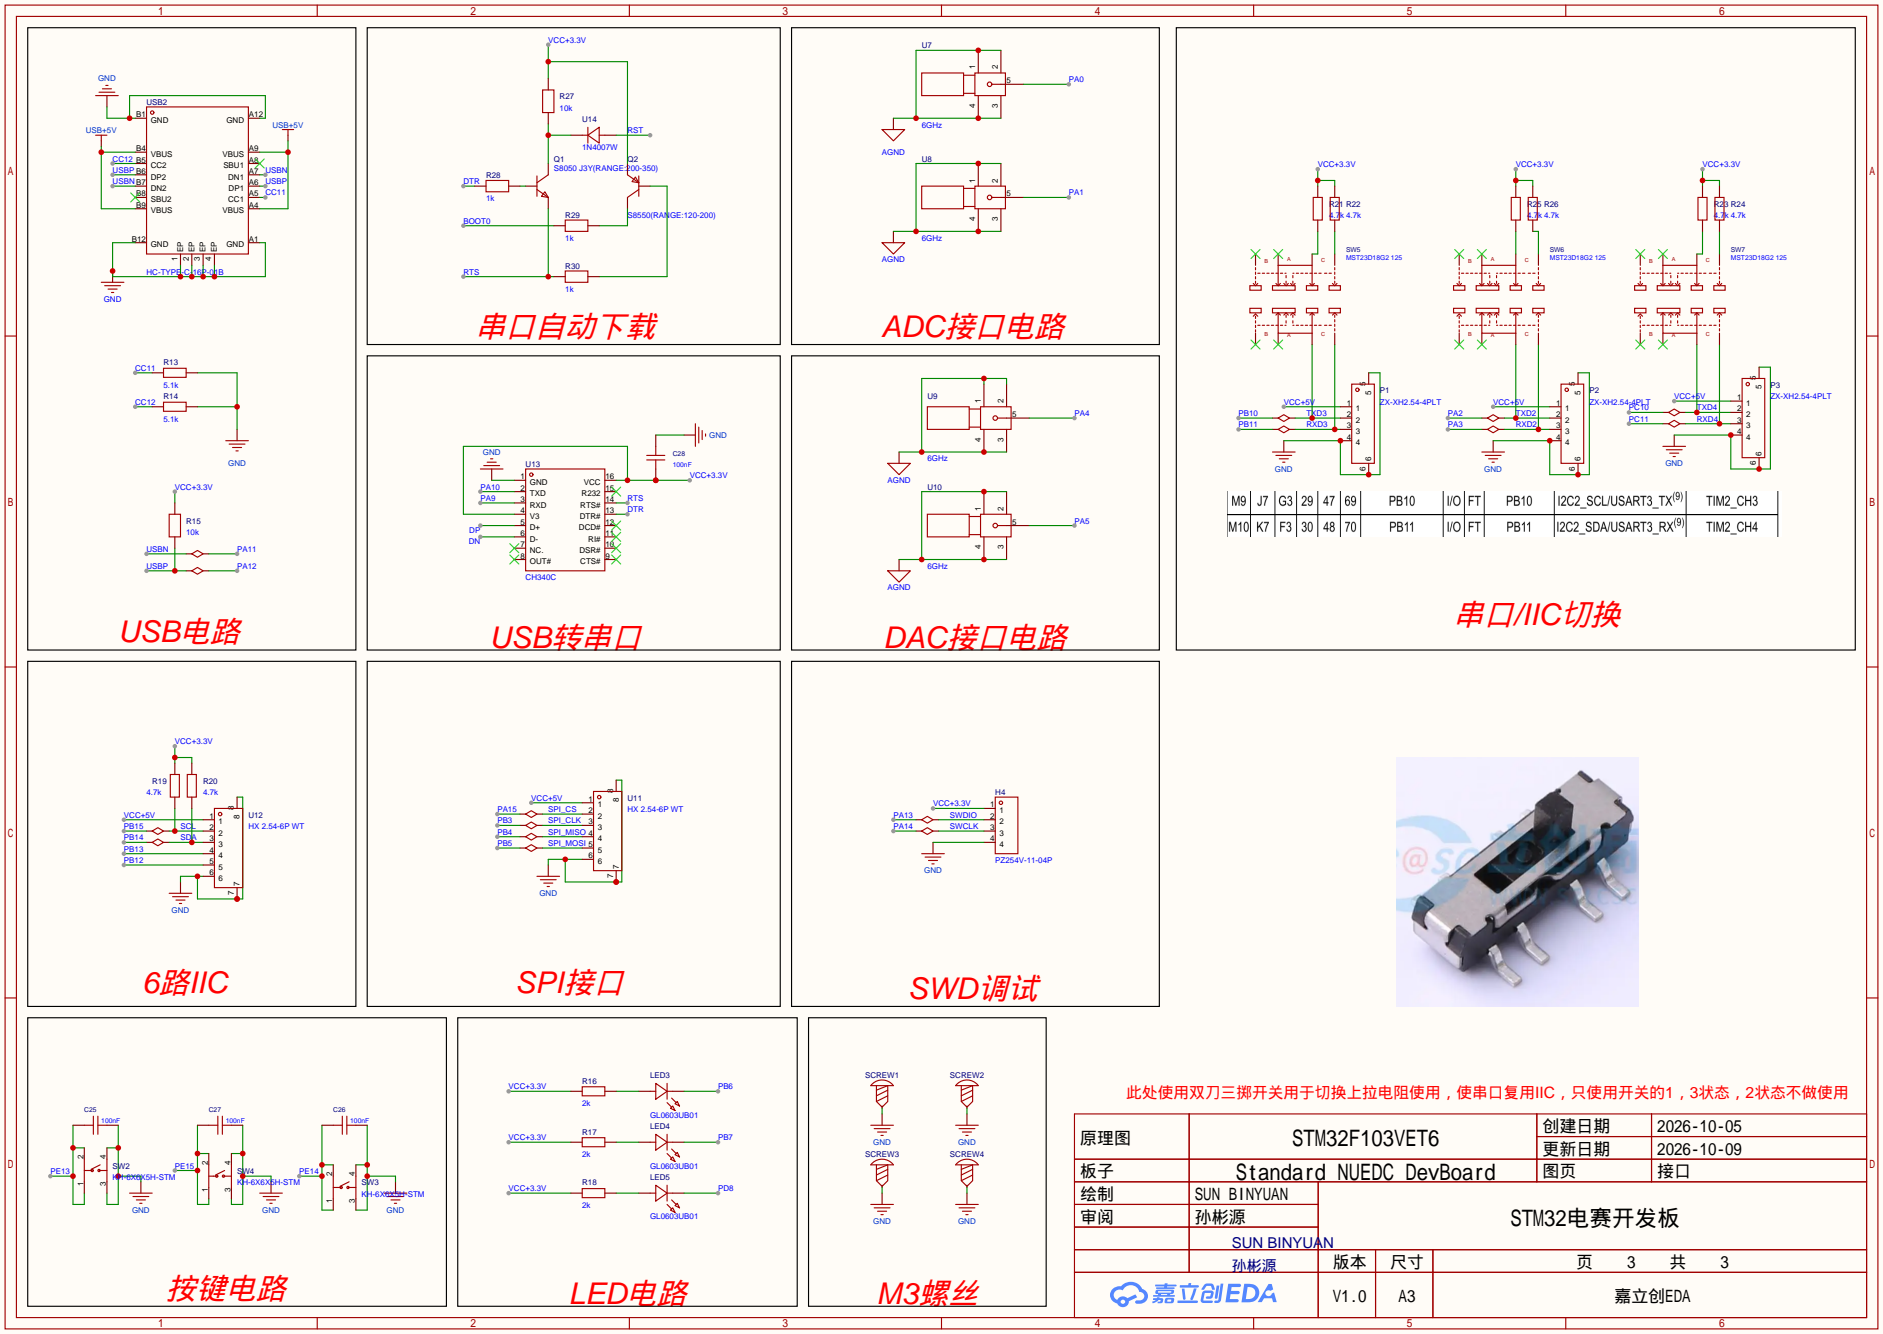
[picture p15: page 3]

原理图 | STM32F103VET6 | 创建日期 | 2026-10-05
板子 | Standard NUEDC DevBoard | 图页 | 接口
绘制 | SUN BINYUAN | STM32电赛开发板
审阅 | 孙彬源

更新日期 | 2026-10-09

SUN BINYUAN

V1.0 | A3 | 嘉立创EDA
