SunBinyuan666/Standard_NUEDC_DevBoard/Code_Demo/TB6612FNG/TB6612FNG.ioc

Mcu.UserName=STM32F103VETx
PA6.Signal=S_TIM3_CH1
PA7.Signal=S_TIM3_CH2
PA13.Signal=SYS_JTMS-SWDIO
PA14.Signal=SYS_JTCK-SWCLK
PE8.GPIO_Label=MOTOR_AIN1
PE8.Signal=GPIO_Output
PE9.GPIO_Label=MOTOR_AIN2
PE9.Signal=GPIO_Output
PE10.GPIO_Label=MOTOR_BIN1
PE10.Signal=GPIO_Output
PE11.GPIO_Label=MOTOR_BIN2
PE11.Signal=GPIO_Output
PE12.GPIO_Label=MOTOR_STBY
PE12.Signal=GPIO_Output
