SunBinyuan666/Standard_NUEDC_DevBoard/Code_Demo/TB6612FNG/Core/Inc/main.h

#define MOTOR_AIN1_Pin             GPIO_PIN_8
#define MOTOR_AIN1_GPIO_Port       GPIOE
#define MOTOR_AIN2_Pin             GPIO_PIN_9
#define MOTOR_AIN2_GPIO_Port       GPIOE
#define MOTOR_BIN1_Pin             GPIO_PIN_10
#define MOTOR_BIN1_GPIO_Port       GPIOE
#define MOTOR_BIN2_Pin             GPIO_PIN_11
#define MOTOR_BIN2_GPIO_Port       GPIOE
#define MOTOR_STBY_Pin             GPIO_PIN_12
#define MOTOR_STBY_GPIO_Port       GPIOE
