SunBinyuan666/Standard_NUEDC_DevBoard/Code_Demo/SG90_Test/Core/Inc/main.h

#define LED3_Pin GPIO_PIN_6
#define LED3_GPIO_Port GPIOB          /* 细调状态灯, 低电平点亮 */
#define LED4_Pin GPIO_PIN_7
#define LED4_GPIO_Port GPIOB          /* 粗调状态灯, 低电平点亮 */
#define LED5_Pin GPIO_PIN_8
#define LED5_GPIO_Port GPIOD          /* 系统心跳灯, 低电平点亮 */
#define KEY_DEC_Pin GPIO_PIN_13
#define KEY_DEC_GPIO_Port GPIOE       /* SW2角度减小, 按下接地 */
#define KEY_INC_Pin GPIO_PIN_14
#define KEY_INC_GPIO_Port GPIOE       /* SW3角度增大, 按下接地 */
#define KEY_MODE_Pin GPIO_PIN_15
#define KEY_MODE_GPIO_Port GPIOE      /* SW4模式切换, 按下接地 */
