SunBinyuan666/Standard_NUEDC_DevBoard/Code_Demo/KEY_LED/Core/Inc/main.h

#define LED3_Pin GPIO_PIN_6
#define LED3_GPIO_Port GPIOB
#define LED4_Pin GPIO_PIN_7
#define LED4_GPIO_Port GPIOB
#define LED5_Pin GPIO_PIN_8
#define LED5_GPIO_Port GPIOD
#define KEY0_Pin GPIO_PIN_13
#define KEY0_GPIO_Port GPIOE
#define KEY1_Pin GPIO_PIN_14
#define KEY1_GPIO_Port GPIOE
#define KEY2_Pin GPIO_PIN_15
#define KEY2_GPIO_Port GPIOE
