SunBinyuan666/Standard_NUEDC_DevBoard/(commit log)

2026-10-20 初始提交：STM32F103VET6 电赛开发板 V1.0
    - 原理图/PCB 工程文件（立创EDA专业版 + BOM + 网表 + PDF）
    - 5 个 VSCode+CMake 示例工程（含 HAL 库，克隆即编译）
    - AI_Development：元器件连接方式文档、个人编程规范、Keil 移植踩坑笔记
    - keil2cubevscode 移植脚本
    - 硬件手册（厂商版权 PDF）不入库，型号见 BOM
2026-10-20 README: 移除开发规范一节的来源与对齐标准说明
2026-10-20 README: 板载资源改为完整外设介绍（电源/最小系统/通信/模拟/人机交互/扩展）
2026-10-20 README: 添加 PCB 顶层/底层渲染图预览
2026-10-20 添加 PCB 3D 顶层/底层渲染图并更新 README 预览
2026-10-20 README: 添加原理图三页预览（主控/电源/接口）
2026-10-20 README: 添加工程配置流程（从克隆到运行）
2026-10-20 README: 工程配置流程补充串口调试工具推荐（SerialWeb）
2026-10-20 README: 警告语补充未测试大占用场景说明
2026-10-21 Update README.md
    修改了一些readme介绍
2026-10-28 添加 SG90 舵机按键控制 demo（半成品）
    - Core: app_servo/app_button/app_led + HAL 初始化（TIM PWM 驱动舵机）
    - 含 SG90_Test.ioc、Keil 工程、CMake 工程
    - 附工程要求文档 SG90舵机按键控制工程要求.md
2026-11-11 添加 HC-SR04 超声波+舵机扫描避障 demo（编译验证通过，待上板）
2026-11-11 HC-SR04 改硬件IIC驱动: TIM4输入捕获+TRIG/ECHO换I2C2(PB10/PB11, P1接口+SW5上拉), 2020款模块IIC协议(0x57/写0x01/读3字节), 编译通过
2026-11-11 回退IIC改动: 模块无R4/R5模式电阻无法切IIC, 恢复GPIO(TRIG/ECHO+TIM4捕获)版本, 编译验证通过
2026-11-11 扫描逻辑V2.1.0: 二值判定(前方有物体才摆头,转向无物体侧); 扫描角±20->±60度(30~150); SW3改位置复原(任意状态回中重测); SW4暂停态单向微调; 编译通过
2026-11-11 方向保持时间1s->5s: 转向无物体侧后停留5s再回中复测
2026-11-11 同步工作区: SG90_Test进行中改动+USART1_KEY clangd配置
2026-11-11 chore: 添加TB6612FNG工程骨架基线
2026-11-11 feat: 完成TB6612FNG双电机功能测试
2026-11-12 TB6612FNG实测通过: 起步占空比提到40%, 高速段80%; 补clangd配置
