SunBinyuan666/Standard_NUEDC_DevBoard/(notices)

Notices in the files:
Code_Demo/PWM_LED/Core/Src/main.c:
Copyright (c) 2026 STMicroelectronics.
All rights reserved.
This software is licensed under terms that can be found in the LICENSE file
